cgrgncu/SwitchArray_info/README.md

# SwitchArray_info
+ SwitchArray 資訊

### 基本資料
+ 作者: TingoYeh
+ 最終版本: v20240416a
  + 電腦軟體:
    + 作業系統: Windows10
    + 軟體: ERT_ver2_9_9_Client.exe
  + 主控板PCBA(含ESP32):
    + Gerber: 檔案=BOM_ERT3-rev2_2024-02-26.csv,Gerber_ERT3-rev2_PCB_ERT3_9_2024-02-26.zip,PickAndPlace_PCB_ERT3_9_2024-02-26.csv
    + 韌體:SwitchArray_ver2_9.ino
  + 繼電器板PBCA:
    + Gerber: ??
    + 韌體:無

### 材料
+ #1 機殼:
  + 下單連結: https://item.taobao.com/item.htm?spm=a1z09.2.0.0.12aa2e8dmm8tFh&id=650716903526&_u=f207c1240h89b1
  + 來自大陸，關稅另計。視情況免運。
  + 一組含稅價約CYN800，折合台幣約NTD4000，要詢價(廠商將參考訂單數量、訂單交期等條件進行報價)。
  + 要提供設計圖。檔案=???
  + 每一台設備只需要一組機殼。
+ #2 電源接頭+插孔(K16防水航空插頭插座)
  + 下單連結: https://item.taobao.com/item.htm?spm=a1z09.2.0.0.12aa2e8dmm8tFh&id=663162205748&_u=f207c1240h331f
    + 替代連結: https://www.ruten.com.tw/item/show?22325055484808
  + 來自大陸，關稅另計。視情況免運。
  + 一組含稅價約CYN19，折合台幣約NTD95。
  + 每一台設備只需要一組(電源接頭+插孔)。
  + 圖片:  
    <image src="https://github.com/cgrgncu/SwitchArray_info/blob/main/K16%E9%98%B2%E6%B0%B4%E8%88%AA%E7%A9%BA%E6%8F%92%E9%A0%AD%E6%8F%92%E5%BA%A7.png" width="200">
+ #3 USB插孔(龍仕LSHITECH防水USB連接器)
  + 下單連結: https://item.taobao.com/item.htm?spm=a1z09.2.0.0.12aa2e8dmm8tFh&id=662371485402&_u=f207c1240h22c0
    + 替代連結: https://www.ruten.com.tw/item/show?22227674727266
  + 來自大陸，關稅另計。視情況免運。
  + 一組含稅價約CYN23，折合台幣約NTD115。
  + 每一台設備只需要一組(USB插孔)。
+ #4 HDMI插孔
  + 下單連結: https://item.taobao.com/item.htm?spm=a1z09.2.0.0.12aa2e8dmm8tFh&id=662442461312&_u=f207c1240hef03
  + 來自大陸，關稅另計。視情況免運。
  + 一組含稅價約CYN26，折合台幣約NTD130。
  + 每一台設備只需要2組(HDMI插孔)。
+ #5 BNC插孔
  + 下單連結: https://shop.cpu.com.tw/product/39037/info/
  + 來自台灣廣華電子，可開立統一發票。視情況免運。
  + 一個含稅價約NTD38。
  + 每一台設備只需要一個(BNC插孔)。
+ #6 槍型接頭
  + 下單連結: ????????????????????
  + 來自?????????????
  + 一組含稅價約??????????????????
  + 每一台設備只需要3紅色3黑色(槍型接頭)，共6個。
  + 用UL1015 18AWG 600V單股多蕊線=>AWG18,105度,600V,多芯線(紅色、黑色)
    + https://shop.cpu.com.tw/product/6934/info/
    + https://shop.cpu.com.tw/product/17169/info/
+ #7 香蕉插孔
  + 下單連結: https://shop.cpu.com.tw/product/8617/info/
  + 來自台灣廣華電子，可開立統一發票。視情況免運。
  + 一個含稅價約NTD22。
  + 每一台設備只需要1紅1黑1綠(香蕉插孔)。
+ #8 客製電路-切換版
  + 下單連結: https://jlcpcb.com/
  + 來自大陸。要運費。
  + 一組含稅價約US11，大約NTD330。
  + 要提供設計圖。檔案=BOM_ERT3-rev2_2024-02-26.csv,Gerber_ERT3-rev2_PCB_ERT3_9_2024-02-26.zip,PickAndPlace_PCB_ERT3_9_2024-02-26.csv
    + 其他: 4-PCB_PCB_ERT3_9.json
  + 每一台設備只需要8組(客製電路-切換版)。
+ #9 客製電路-控制版
  + 下單連結: https://jlcpcb.com/
  + 來自大陸。要運費。
  + 一組含稅價約US10，大約NTD300。
  + 要提供設計圖。檔案=???
  + 每一台設備只需要一組(客製電路-控制版)。
+ #10 電子元件???
  + 下單連結: https://www.lcsc.com/

+ #11 nodemcu-32s
  + 下單連結: [https://jlcpcb.com/](https://shopee.tw/(%E6%94%B6%E6%93%9A%E7%99%BC%E7%A5%A8%E5%8F%AF)%E7%AA%84%E7%89%88ESP32%E9%9B%99%E6%A0%B8%E5%BF%83arduino-WIFI%E8%97%8D%E8%8A%BDble%E8%85%B3%E4%BD%8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)https://shopee.tw/(%E6%94%B6%E6%93%9A%E7%99%BC%E7%A5%A8%E5%8F%AF)%E7%AA%84%E7%89%88ESP32%E9%9B%99%E6%A0%B8%E5%BF%83arduino-WIFI%E8%97%8D%E8%8A%BDble%E8%85%B3%E4%BD%8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
  + 來自台灣，要運費。
  + 一組含稅價約NTD245。
  + 每一台設備只需要一組(nodemcu-32s)。
  + 這個要自己燒韌體，韌體檔案=???
+ #12 BNC線
  + 下單連結: https://shop.cpu.com.tw/product/68473/info/
  + 來自台灣廣華電子，可開立統一發票。視情況免運。
  + 一組含稅價約NTD120。
  + 每一台設備只需要一組(BNC線)。
+ #13 34465A電錶
  + 下單連結: https://www.pinsyun.com.tw/index.html
  + 來自台灣品勛科技股份有限公司，可開立統一發票。視情況免運。
  + 一組含稅價約NTD63720。
  + 每一台設備只需要一組(34465A電錶)。
+ #14 200V 1A 9184B電源供應器
  + 下單連結: https://www.bktw.com.tw/
  + 來自台灣廣華電子，可開立統一發票。視情況免運。
  + 一組含稅價約NTD57750。
  + 每一台設備只需要一組(200V 1A 9184B電源供應器)。
+ #15 windows電腦
  + 一組含稅價約NTD15000。
  + 要有三個USBA
  + 每一台設備只需要一組(windows電腦)。
  + 軟體相關安裝
+ #16 歐規端子台
  + me860-508
  + MPC301-50808P
  + WJ2EDGRM-5.08-8P

```
 versionA@ 400V 100mA						
編號	項目	數量	單價	幣別	備註	來源
15A	AB30S	260	30	TWD		https://www.relay.com.tw/zh-TW/index/index.html
						
		總價	152378.308	匯率	CYN	4.4
					USD	31.24
						
 versionB@600V 600mA						
編號	項目	數量	單價	幣別	備註	來源
15B	LT930	128	70	TWD	交期長	https://www.letex.com.tw/
16B	AM38S	132	35	TWD	交期長	https://www.relay.com.tw/zh-TW/index/index.html
						
		總價	158158.308	匯率	CYN	4.4
					USD	31.24
						
 versionC@1000V 350mA						
編號	項目	數量	單價	幣別	備註	來源
15C	AA52F	260	380	TWD	交頎長	https://www.letex.com.tw/
					交期長	
						
		總價	243378.308	匯率	CYN	4.4
					USD	31.24
						
 versionD@600V 1A (DC Only)						
編號	項目	數量	單價	幣別	備註	來源
15D	G3VM-601FR	128	438	TWD		https://www.letex.com.tw/
16D	AM38S	132	35	TWD	交期長	https://www.relay.com.tw/zh-TW/index/index.html
						
		總價	205262.308	匯率	CYN	4.4
					USD	31.24
```

ab30s
(02)8227-6000 由總機為您轉接專業業務人員

### 機殼安裝完成後
+ BOX先連接電表(34465A電錶)的紅、黑線，BNC線
+ BOX連接電腦的USB。
+ BOX連接電供輸出端。使用2P防水接頭，#1接正(紅色)，#2接負(黑色)。
+ 電表接電腦(USB-B接USB-A)，電錶開啟有繼電器切換聲音是正常現象。
+ 電供接電腦。
+ 遠端重開機

### 軟體設定
+ 要滿足三個條件才是線有接好:
  + 有勾選「Remote PSU」
  + START可以按。要有測試RUN過才會儲存勾選
  + 要選好存檔資料夾。
+ 設定放電模式:
  + 讀取已經規劃好的設定檔案(csv)。
  + 軟體部分頁面只是協助規劃放電模式，實際使用不應該操作。
    + 先規劃W0~W8(最多9隻)，就是放電電極的行為，每次行為例如48秒
    + 再規劃各次行為W要放在哪個電擊棒，例如每個48秒依序換到哪個電極棒上。
    + 以上操作用來輔助產生csv檔案(CurrentSet Mode.csv)
+ 決議:
  + 禁止使用:
    + Insert Break=FALSE
    + 使用了資料會異常，原作者保留特殊測試用途。
  + 先設定啟用:
    + Only Use Last Value? = TRUE
    + Inverse Polarity = TRUE
    + 只有Gradient + Dipole dipole模式下有用。吧?

### 機殼考慮:
+  https://tw.misumi-ec.com/vona2/detail/222000224688/

### 收納包:
+ SC-TI06長方型加大防潑水硬殼收納包
  + https://jin-hua.com.tw/page/product/show.aspx?num=39619&lang=TW
