cgrgncu/SwitchArray_info/電路板生產/README.md

# 生產筆記

### PCBA廠商
+ https://jlcpcb.com/
+ 用google帳戶登入(CGRG)
