cgrgncu/SwitchArray_info/石墨電極製作/README.md

# 石墨電極製作
+ 作者: HsiupoYeh
+ 更新日期： 2025-04-06

## v20240310a
### 材料準備
+ 石墨電擊棒 x1隻
+ PVC蘋果膠膜(5公分寬) x1捲
+ 迷你台鉗60mm x1
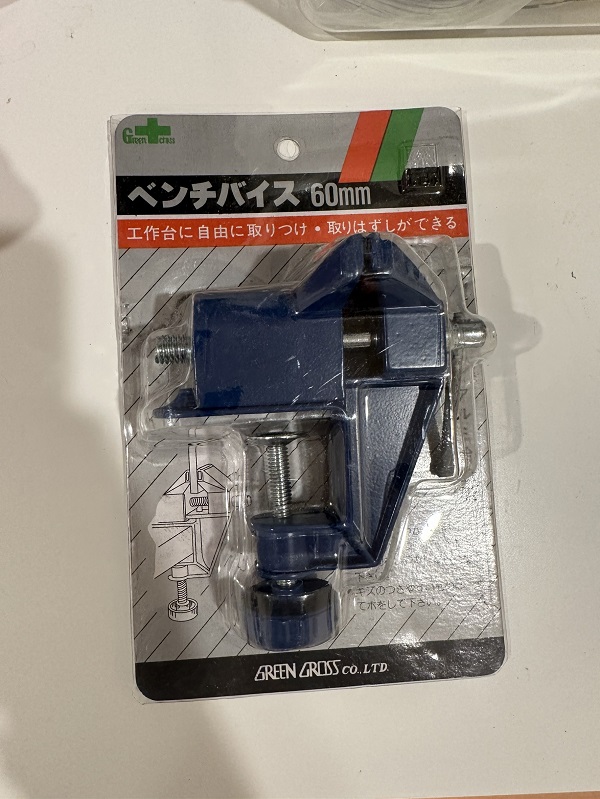
[picture p1: 石墨電極製作/迷你台鉗60mm.jpg]
迷你台鉗60mm
  > 
+ 電鑽 x1

### 步驟
+ 用PVC蘋果膠膜將石墨棒纏繞，用來增加固定時的摩擦力。
+ 不鏽鋼絲0.55mm，裁出12cm一條。2公分用來連接電線並使用熱縮，10公分用來纏繞鎖定石墨棒。
