cgrgncu/SwitchArray_info/production/SwitchArray/SwitchArray-2026-S010/README.md

## SwitchArray 2026-S010 組裝紀錄
### 組裝日期: 2026-10-16
+ SwitchArray完整序號為: 2026-S010
+ 使用日本TAKACHI電機工業生產的規格品「MO系列金屬系統機殼 MO99-16-23B」，並新增客製化支架與面板開孔(支架與面板開孔由台灣堃豐公司製作)。
+ 為了避免貼標籤錯誤，會預留一台已經貼了標籤的樣品機，若有不詳盡可拆這台來參考。
+ 貼上標籤貼紙:
  + 先全部組裝起來，等下要貼腳座。
  + 日本原廠的最大片覆蓋外殼，選一側為底座，撕掉膠膜，貼上腳座，腳座位置緊靠四個角落。使腳座放在桌上，右側是彎鉤側，在中間底部貼上標籤貼紙「SwitchArray\n2026-S010」。
  + 另一側的最大片覆蓋外殼取出不使用(另外收好)，替換成開孔的覆蓋外殼。內側貼上標籤貼紙「SwitchArray\n2026-S010」於中間下方偏右，貼上標籤貼紙「朝下」於中間下方偏左，貼上標籤貼紙「排針在上方」於中間上方。外側貼上標籤貼紙「SwitchArray\n2026-S010」於中間下方。
  + 日本原廠的前面板取出不使用(另外收好)，替換成開孔的前面板。內側是指平放時看過去右上角是有四個小孔一大孔的。內側貼上標籤貼紙「前面板內側」於中間最下方，再貼上標籤貼紙「SwitchArray\n2026-S010」於中間次下方。
  + 日本原廠的後面板，貼上標籤貼紙「後面板內側」於中間最下方，再貼上標籤貼紙「SwitchArray\n2026-S010」於中間次下方。
  + 取出支架，貼上標籤貼紙「排針在上方」於中間上方，再貼上標籤貼紙「SwitchArray\n2026-S010」於中間下方。
  + 準備收納用的大創透明外箱，並貼上護貝的名稱紙。
+ 若後續零件未就緒，就先組裝起來。記得要把支架鎖到開孔覆蓋外殼中，平頭M4x10螺絲。
+ 準備配件收納包(SC-TI06長方型加大防潑水硬殼收納包):
  + 配件包正反面貼上標籤貼紙「S010」於中間，正反兩面各一張。
  + 配件1: USB3.0數據線(POLYWELL USB3.0 Type-A公對公高速傳輸線 1M) 兩個USB頭平坦側貼上標籤貼紙「S010」，有加外框1字體6pt。用六號夾鏈袋裝好，放入收納包中。
  + 配件2:PSU連接線(橘、灰)_香蕉接頭轉防水接頭，一組。製作方式:
    + 準備香蕉接頭紅色(GS-6027B-R)、黑色(GS-6027B-BK)，各一個。
    + 從8芯纜線中取出橘色、灰色電線各一條，每條裁切為62[cm]長。
    + 準備KWAY綠色防水接頭一個。平坦側貼上標籤貼紙「S010」，有加外框字體10pt。
    + 先將一端剝線約1[cm]，先用壓接端子(CE0.75-10W)壓好，修剪壓接部分(保留約2.5~3格)，再鎖到黑色香蕉插頭(GS-6027B-BK)或紅色香蕉插頭(GS-6027B-R)上。紅色接頭配橘色線，黑色接頭配灰色線。
    + 兩條接頭帶線完成後，接到電供上(不要通電)，使用蘋果膠帶把兩條線束緊固定。保留約3[cm]用於安裝防水接頭。
    + 焊接電線到防水接頭上，記得按照順序先把零件套到線上，先用壓接端子(CE0.75-10W)壓好，再將橘色線焊接到PIN#1，灰色線焊接到PIN#2。最後組裝起來，並使用電錶查驗通路與否。
    + 用五號夾鏈袋裝好，放入收納包中。
  + 配件3:DMM連接線(紅、黑)_香蕉接頭轉電錶接頭，一組。製作方式:
    + 準備香蕉接頭紅色(GS-6027B-R)、黑色(GS-6027B-BK)，各一個。
    + 從雙頭香蕉接頭測試線(FC-TL209)中取出黑、紅色各一條，每條120[cm]從中間裁切一半長度，裁完變成約60[cm]長。至此變成黑紅各兩條。
    + 先將一端剝線約1[cm]，先用壓接端子(CE0.75-10W)壓好，修剪壓接部分(保留約2.5~3格)，再鎖到黑色香蕉插頭(GS-6027B-BK)或紅色香蕉插頭(GS-6027B-R)上。紅色接頭配紅色線，黑色接頭配黑色線。
    + 兩條接頭帶線完成後，接到電錶上(不要通電)，使用蘋果膠帶把兩條線束緊固定，並貼上標籤貼紙「S010」。標籤貼在兩邊蘋果膠帶末端距離約3[cm]。
    + 用六號夾鏈袋裝好，放入收納包中。
  + 配件4:BNC雙公射頻線_1M_RG316(BNC-316U-100)，一條。BNC接頭底下小環貼上標籤貼紙「S010」字體6pt，用六號夾鏈袋裝好，放入收納包中。
+ 組裝前面板上的接頭:
  + 安裝一個紅色博士端子座(優先使用型號GS-6044B-R)
    + 準備配合使用的紅色電源線(從8芯纜線中取出紅色)，長度33[cm]，一端先用壓接端子(CE0.75-10W)壓好，修剪壓接部分(保留約2.5~3格)後壓接絕緣R型端子(型號RF1.25-4)。最後鎖到博士端子座上+螺絲固定膠。另一端用壓接端子(CE0.75-10W)壓好。
  + 安裝一個黑色博士端子座(優先使用型號GS-6044B-BK)
    + 準備配合使用的黑色電源線(從8芯纜線中取出黑色)，長度33[cm]，一端先用壓接端子(CE0.75-10W)壓好，修剪壓接部分(保留約2.5~3格)後壓接絕緣R型端子(型號RF1.25-4)。最後鎖到博士端子座上+螺絲固定膠。另一端用壓接端子(CE0.75-10W)壓好。
  + 安裝一個雙頭BNC座有絕緣(型號BNC-SS-AI)+內側螺絲固定膠。
  + 安裝一個綠色KWAY防水接頭座
    + 準備配合使用的橘、灰色電源線(從8芯纜線中取出橘、灰色)各一條，每條長度33[cm]。
    + 接頭座編號1處塗上紅色，編號2處塗上黑色。
    + 先用壓接端子(CE0.75-10W)壓好，再焊接到接頭座再將橘色線焊接到PIN#1，灰色線焊接到PIN#2。
  + 安裝一個黃色USBA防水接頭座
    + 準備MicroUSB線(優先使用型號IS-C62，長度20[cm])     
+ 組裝上方面板REF接頭:
  + 準備綠色博士端子頭(優先使用型號9404G)
    + 準備配合使用的綠色電源線(從8芯纜線中取出綠色)，長度33[cm]，單端先用壓接端子(CE0.75-10W)壓好，修剪壓接部分(保留約2.5~3格)後壓接R型端子(型號R1.25-4)。最後鎖到博士端子座上。R型端子+壓接端子+螺絲固定膠。
+ 組裝Control_Board_v1.2
  + 取出一片Control_Board_v1.2，登記出廠序號「2025100002」。移除底部固定螺絲，螺絲另外收好。在H101附近貼上標籤貼紙「SwitchArray\n2026-S010」。
  + 先裝上BNC公轉杜邦母_30cm(型號BNC-MDP-03)連接線，紅色接V_ready，黑色接GND。
  + 再裝上ESP32-WROOM-32E(ESP32-Devkit v3.0)
    + SwitchArray內部使用的「ESP32」一律改用「CP2102」版本
      + 使用CP210x修改序號工具將序號修改為: 「2026-S010」。
        + 插上裝置後(避免弄錯一次只插上一個CP210x裝置)，運行「CP210xSetIDs.exe」，找到中間有一個格子有標註「Serial Number」，填入序號「2026-S010」，在把前面的勾選框勾起來，最後按下最下方的「Program Device」，完成後關閉修改工具，並反覆插拔裝置與檢查序號是否正確。
      + 修改成功後，可在裝置管理員>連接埠(COM和LPT)>Silicon Labs CP210x USB to UART Bridge (COM3)>詳細資料> 裝置例項路徑，會看到「USB\VID_10C4&PID_EA60\2026-S010」。其中「2026-S010」就是SwitchArray完整序號。
    + 燒錄韌體「SwitchArray_ver2_9.ino」。
    + 以上工作都完成後，於ESP32上IC的金鐘罩貼上標籤貼紙，上方貼的標籤貼紙「CP2102」有加外框字體6pt。下方貼的是標籤貼紙「S010」有加外框字體10pt。用剪刀稍微修剪再貼上去。
  + 鎖上配合使用的電源線:
    + 牛角座編號1: 準備配合使用的黑色電源線(從8芯纜線中取出黑色)，長度33[cm]，單端先用壓接端子(CE0.75-10W)壓好，修剪壓接部分(保留約2.5~3格)後壓接R型端子(型號R1.25-4)並用絕緣膠帶纏繞。
    + 牛角座編號2: 準備配合使用的灰色電源線(從8芯纜線中取出灰色)，長度33[cm]，單端先用壓接端子(CE0.75-10W)壓好，修剪壓接部分(保留約2.5~3格)後壓接R型端子(型號R1.25-4)並用絕緣膠帶纏繞。
    + 牛角座編號3: 準備配合使用的綠色電源線(從8芯纜線中取出綠色)，長度33[cm]，單端先用壓接端子(CE0.75-10W)壓好，修剪壓接部分(保留約2.5~3格)後壓接R型端子(型號R1.25-4)並用絕緣膠帶纏繞。
    + 牛角座編號4: 準備配合使用的紅色電源線(從8芯纜線中取出紅色)，長度33[cm]，單端先用壓接端子(CE0.75-10W)壓好，修剪壓接部分(保留約2.5~3格)後壓接R型端子(型號R1.25-4)並用絕緣膠帶纏繞。
    + 牛角座編號5: 準備配合使用的橙色電源線(從8芯纜線中取出橙色)，長度33[cm]，單端先用壓接端子(CE0.75-10W)壓好，修剪壓接部分(保留約2.5~3格)後壓接R型端子(型號R1.25-4)並用絕緣膠帶纏繞。
+ 組裝RelayBoard_v1.2與Control_Board_v1.2
  + 取出8片RelayBoard_v1.2，並記錄其序號，及其被設定的板子編號:
    + 「RelayBoard\n2026-S010-1」: 序號「2025120073」。換成:「2025120054」。
    + 「RelayBoard\n2026-S010-2」: 序號「2025120075」。換成:「2025120094」。
    + 「RelayBoard\n2026-S010-3」: 序號「2025120077」。換成:「2025120095」。
    + 「RelayBoard\n2026-S010-4」: 序號「2025120078」。換成:「2025120096」。
    + 「RelayBoard\n2026-S010-5」: 序號「2025120079」。換成:「2025120097」。
    + 「RelayBoard\n2026-S010-6」: 序號「2025120080」。換成:「2025120098」。
    + 「RelayBoard\n2026-S010-7」: 序號「2025120081」。換成:「2025120099」。
    + 「RelayBoard\n2026-S010-8」: 序號「2025120083」。換成:「2025120100」。
  + 拆封並移除底部固定螺絲，螺絲另外收好。
  + Control_Board_v1.2為第0片，從排針側依序疊好1~8片RelayBoard_v1.2到一起。
  + 用螺絲鎖到支架上，Control_Board_v1.2朝向支架有挖空處。
+ 組裝整個箱體:
  + 注意上方面板的REF要固定好，博士端子座要鎖緊並且使Y型端子後方的綠線朝前面板方向，避免組裝時壓到線。
  + 對齊RelayBoard到上方面板，之後鎖上螺絲。注意，支架後方先不要鎖緊，等上方面板鎖好之後再補鎖緊支架上的螺絲。
  + 接上MicroUSB線到Control_Board_v1.2上。
  + 安裝前面板:
    + 先把BNC接上
    + 再把USB接上(可能有點緊繃稍微硬擠一下)
    + 鎖上前面板固定板(平頭小螺絲的那塊)
  + 接快接頭(顏色對接)，然後將接頭藏到凹槽中。
  + 裝殼，鎖好全部。
  + 完成!
+ 準備相關軟體至雲端供使用者下載:
  + R2MS_Lite_安裝軟體:
      + R2MS_Lite_Smart_Scheduler
        + 這個軟體要重新編譯來支援新增的序號。
      + R2MS_Lite_Driver
+ 驗收測試:
  + 序號測試:
    + 確認R2MS_Lite_Smart_Scheduler是否有支援該序號。
    + 同時也是驗證韌體燒錄是否成功。
  + 空接放電測試：
    + 2026-10-16: 測試通過
    + 主要關心電壓為相似整齊波型，電流為0[A]。
      + 只安裝單片RelayBoard_v1.2，8CH空接，綠色REF空接。
        + 正式測試前，去清空舊的CSV檔案。
        + 觀察電流範圍+-0.001[A]，方便觀看，可以把電壓也設定同樣範圍:
          + 應該會呈現正反放電波型，不穩定，可視為漏電。電流約0.0005[A]，稍微抖動的波型。特色:單獨觀看一頻道，前面正反比較方波，後面正反比較三角形。
          + 用NotePad++開啟CSV檔案，檢查第三個直欄位電流。應該都是0，僅在切換時有0.00005~0.00006[A]
    + 若測試失敗表示要拆掉重新檢查: 單獨板子測試方法TBD...。 
  + 10歐姆模擬地層放電測試:
    + 主要關心電壓為相似整齊波型，電流為0.1[A]。
      + 2026-10-16:測試通過。
  + 校園草坪放電測試:
    + 實際放電並資料處理及逆推。 
+ 合格報告:
  + 內容物序號清單
  + 組裝日期
  + 測試日期及結果
  + 軟體下載位置
+ 資料蒐集小電腦:
  + 安裝設定TBD... 
  + 原則上一台資料蒐集小電腦僅專供一套R2MS_Lite使用，故電腦內使用者名稱與儀器序號相同。以利盤點管理及自動化功能開發。是否需要修改密碼視使用者需求而定，預設無密碼。
  + 重灌作業系統及必要驅動程式。目前選用Windows10，若有安全性疑慮請避免直接連接網際網路。
  + 安裝必要操作程式(R2MS_Lite_Smart_Scheduler、R2MS_Lite_Driver等)
  + 小電腦貼上標籤，例如:序號、重灌日期、用途、財產編號等。
