cgrgncu/SwitchArray_info/production/SwitchArray/SwitchArray-2025-S006/README.md

### SwitchArray 2025-S006
+ 組裝日期: 2025-12-31 (*無法確認具體日期)
+ SwitchArray完整序號為: 2025-S006

### 2026-04-28
+ 墾丁回來之後，S006損壞。內部線路似乎被拉扯到，ControlBoard排針損壞。

### 2026-04-29
+ 維修日期: 2026-04-29
+ 更換ControlBoard_v1.2，登記出廠序號「2025100004」。
+ 內部連接線更換為R型端子+壓接端子+螺絲固定膠。
+ 更換USBA公對公傳輸線。

### 2026-05-01
+ 通過室內測試

### 2026-05-04
+ 通過室外測試
