cgrgncu/SwitchArray_info/production/SwitchArray/SwitchArray-2025-S003/README.md

### SwitchArray 2025-S003
+ 組裝日期: 2025-12-31 (*無法確認具體日期)
+ SwitchArray完整序號為: 2025-S003

### 2026-05-04
+ 通過完整測試
