cgrgncu/SwitchArray_info/RelayBoard_QC_v1/R2MS_Lite_RelayBoard_QC_v20250419a/Flash_Html/README.txt

ESP32 Flash Tool 使用說明

📌 使用前準備：
1. 請使用 Google Chrome 或 Edge 瀏覽器（需支援 Web Serial API）
2. 建議使用 USB 資料線連接 ESP32 裝置

🧪 操作步驟：
1. 解壓縮本壓縮檔
2. 用 Chrome 開啟 flash.html
3. 點擊「開始燒錄」
4. 選擇 ESP32 裝置
5. 等待燒錄完成，裝置會自動重啟！

💡 如果出現錯誤：
- 請確認已允許瀏覽器存取 USB
- 更換 USB 線或接腳
- 使用支援的瀏覽器（Chrome、Edge）
