cgrgncu/SwitchArray_info/production/SwitchArray/SwitchArray-2026-S007/20261028/README.md

# SwitchArray-2026-S007 維修檢測完成紀錄
+ 室外檢測完成日期: 2026-10-28

### 時間序列檢視
| 室內浮接測試時間序列 PSU:SHOW S007202610281145 |
| :---: |
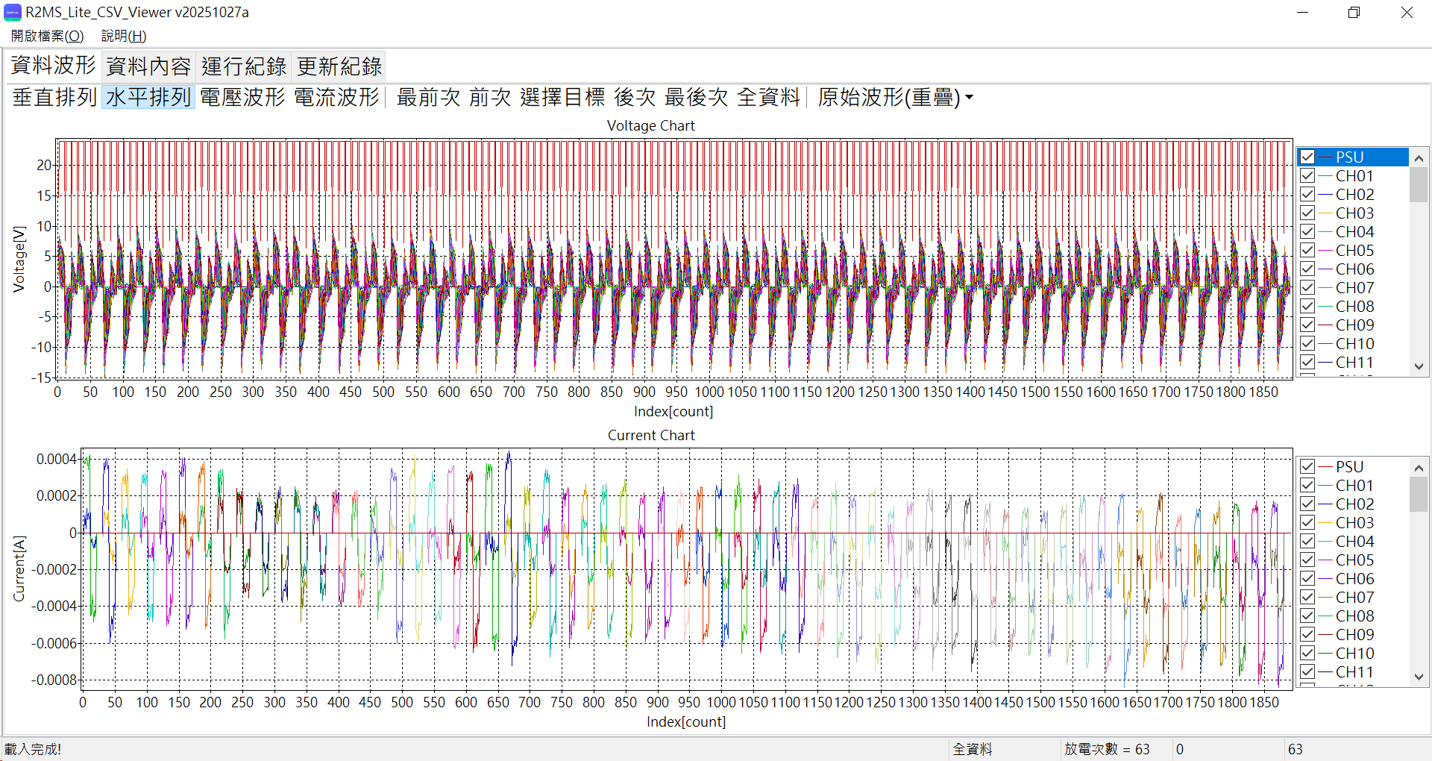
[picture p29: production/SwitchArray/SwitchArray-2026-S007/20261028/S007202610281145_Floating.png]
|  |

| 室內浮接測試時間序列 PSU:HIDE S007202610281145 |
| :---: |
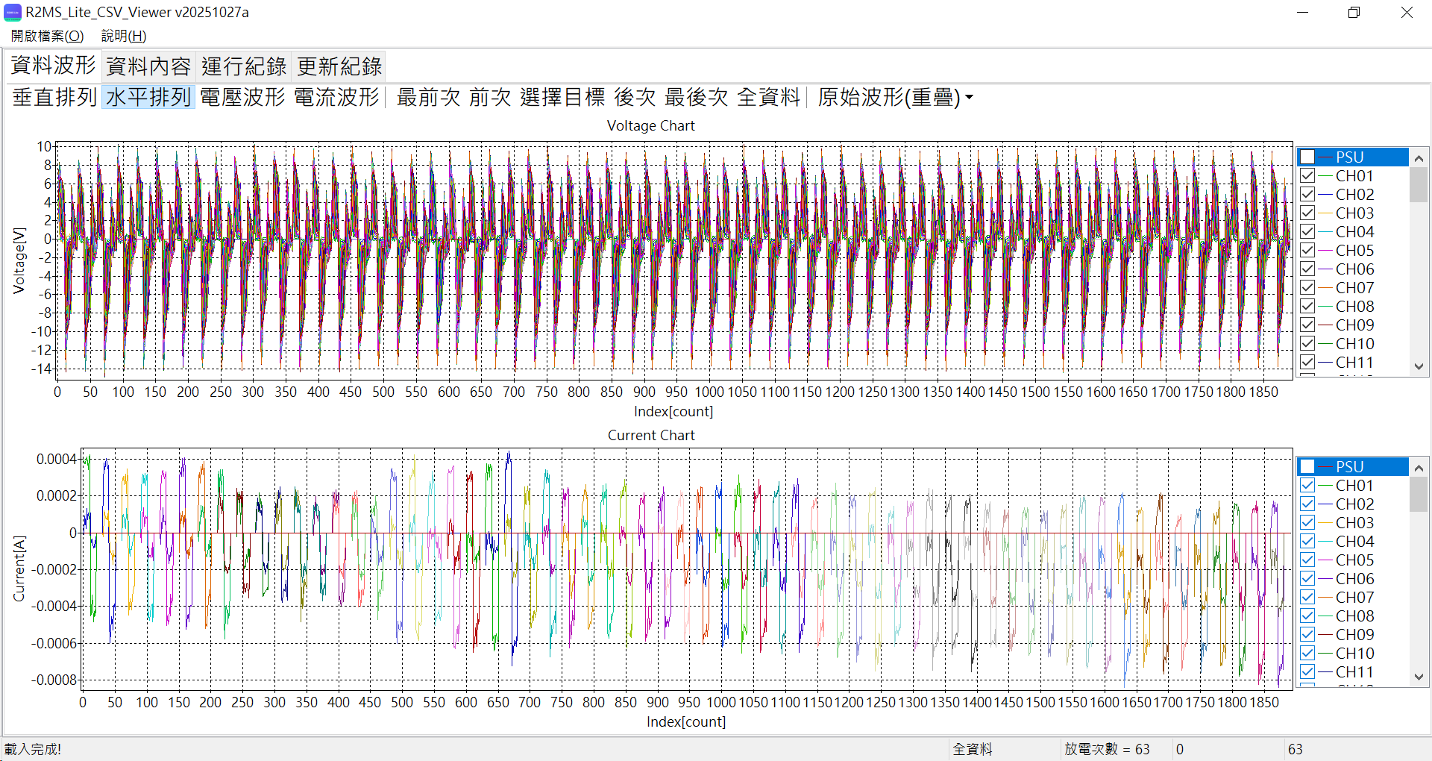
[picture p30: production/SwitchArray/SwitchArray-2026-S007/20261028/S007202610281145_Floating2.png]
|  |

| 室內標準地層測試時間序列 PSU:SHOW S007202610281153 |
| :---: |
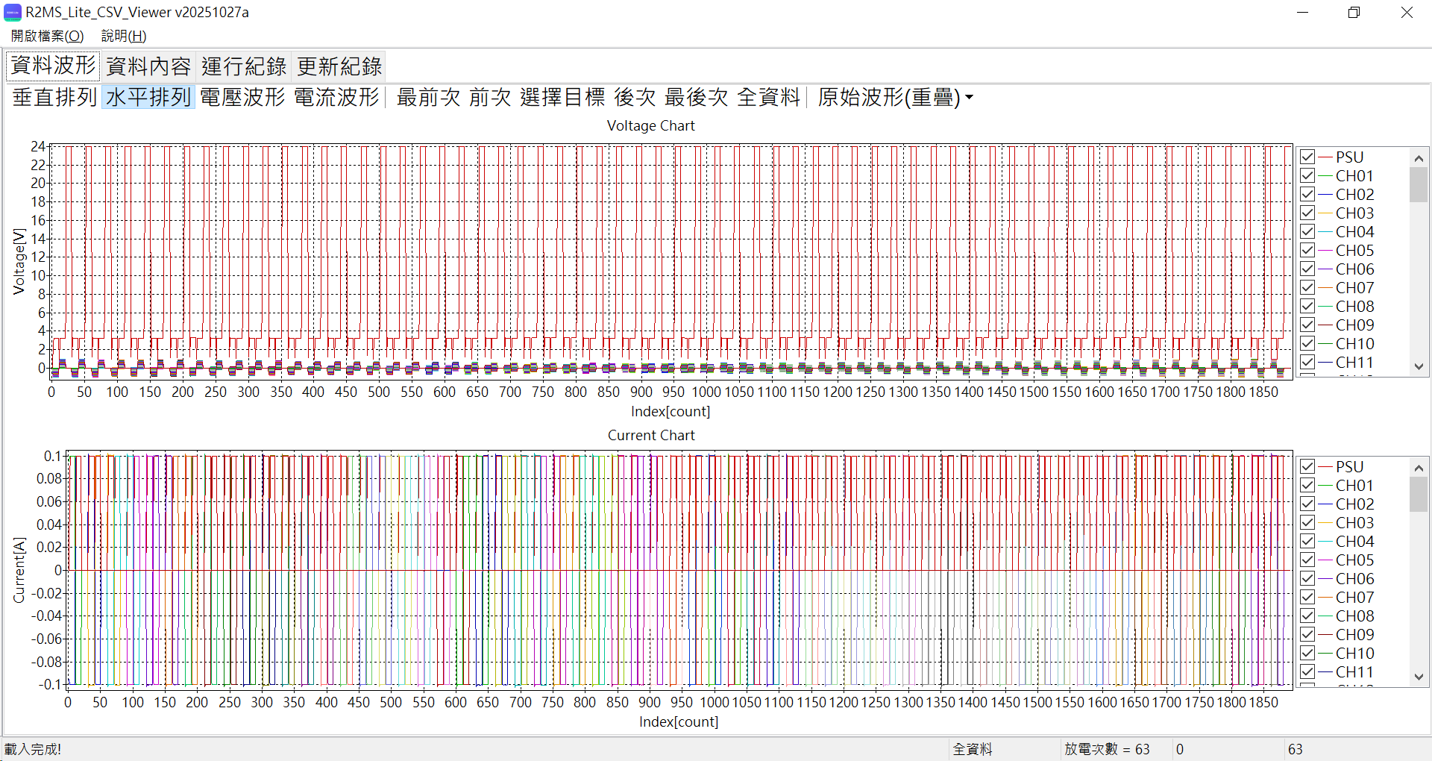
[picture p31: production/SwitchArray/SwitchArray-2026-S007/20261028/S007202610281153_StandardResistor.png]
|  |

| 室內標準地層測試時間序列 PSU:HIDE S007202610281153 |
| :---: |
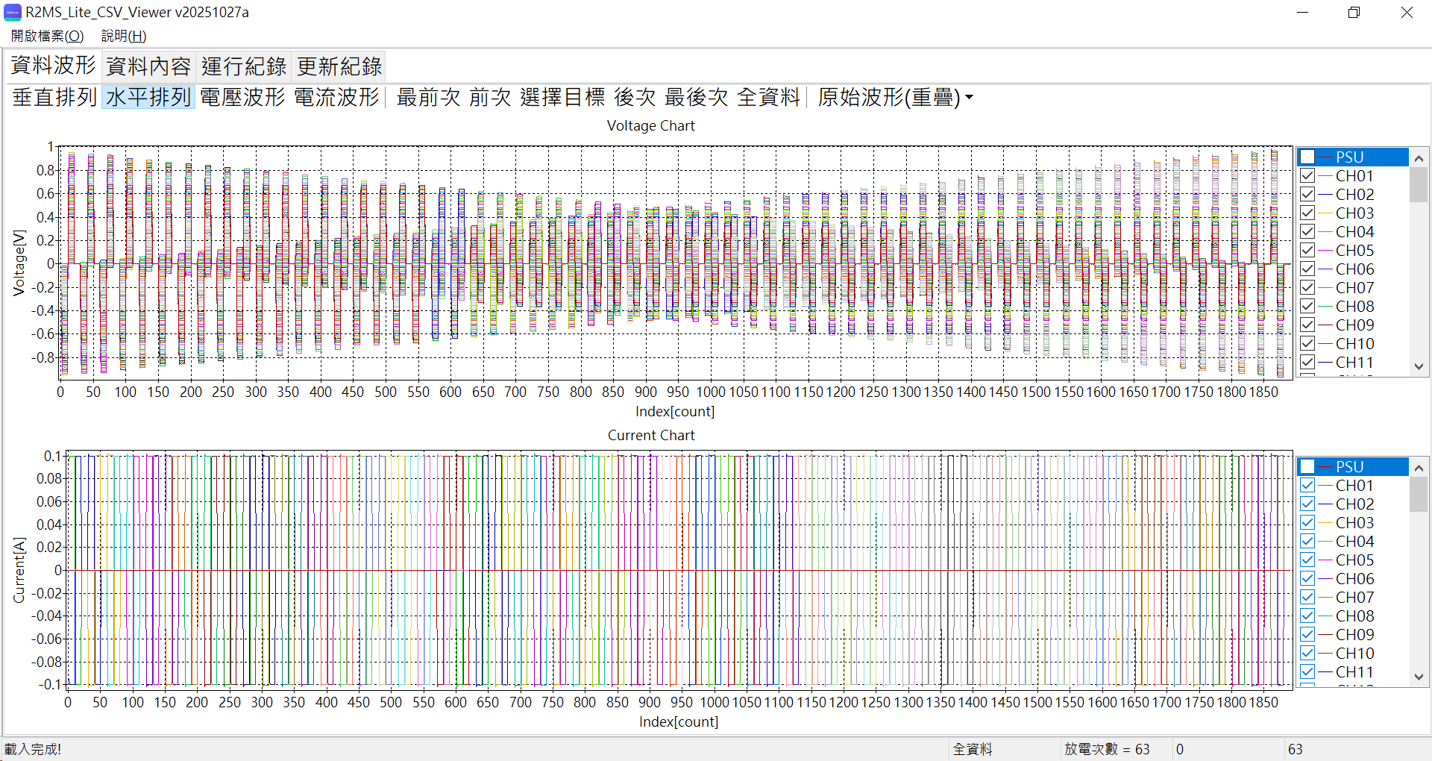
[picture p32: production/SwitchArray/SwitchArray-2026-S007/20261028/S007202610281153_StandardResistor2.png]
|  |

### R2MS_Lite_CSV_CurrentQC 分析摘要

- **來源檔案**：`S007202610281153.v299T.csv`
- **產生時間**：2026-10-30 22:27:23
- **程式版本**：R2MS_Lite_CSV_CurrentQC v20261030b
- **資料筆數**：原始 1890 筆 → 篩選後 1134 筆（每 10 筆保留 3~8）
- **判定標準**：AVG(MEAS/PSU) > 115.00%
- **BOARD 對應**：CH01–CH08 = BOARD 01、CH09–CH16 = BOARD 02、…、CH57–CH64 = BOARD 08

```
BOARD,CH,AVG(MEAS)[A],AVG(PSU)[A],AVG(MEAS/PSU)[%],count,BOARD,CH,AVG(MEAS)[A],AVG(PSU)[A],AVG(MEAS/PSU)[%],count
01,CH01,0.099842335,0.100020000, 99.82,12,02,CH09,0.099760838,0.100042500, 99.72,24
01,CH02,0.099870414,0.100030833, 99.84,24,02,CH10,0.099821804,0.100043333, 99.78,24
01,CH03,0.100690334,0.100041667,100.65,24,02,CH11,0.100019492,0.100042917, 99.98,24
01,CH04,0.099947691,0.100042083, 99.91,24,02,CH12,0.100190567,0.100042500,100.15,24
01,CH05,0.099862393,0.100042500, 99.82,24,02,CH13,0.099876392,0.100042917, 99.83,24
01,CH06,0.100108831,0.100042917,100.07,24,02,CH14,0.099977100,0.100043333, 99.93,24
01,CH07,0.099934289,0.100043333, 99.89,24,02,CH15,0.099697356,0.100043333, 99.65,24
01,CH08,0.099934848,0.100042500, 99.89,24,02,CH16,0.099838555,0.100042500, 99.80,24
03,CH17,0.099920781,0.100041667, 99.88,24,04,CH25,0.100358724,0.100042500,100.32,24
03,CH18,0.099849398,0.100041667, 99.81,24,04,CH26,0.099842587,0.100042083, 99.80,24
03,CH19,0.099893009,0.100042083, 99.85,24,04,CH27,0.100106381,0.100042083,100.06,24
03,CH20,0.100032208,0.100042500, 99.99,24,04,CH28,0.099947656,0.100042083, 99.91,24
03,CH21,0.099886917,0.100042500, 99.84,24,04,CH29,0.099915922,0.100042083, 99.87,24
03,CH22,0.099980603,0.100042083, 99.94,24,04,CH30,0.100115474,0.100042083,100.07,24
03,CH23,0.100165131,0.100042083,100.12,24,04,CH31,0.099773393,0.100041667, 99.73,24
03,CH24,0.099935494,0.100042500, 99.89,24,04,CH32,0.100115121,0.100041667,100.07,24
05,CH33,0.099841721,0.100041667, 99.80,24,06,CH41,0.099780657,0.100041667, 99.74,24
05,CH34,0.100124914,0.100041667,100.08,24,06,CH42,0.099780625,0.100041667, 99.74,24
05,CH35,0.099999095,0.100041667, 99.96,24,06,CH43,0.099725695,0.100042083, 99.68,24
05,CH36,0.099937656,0.100041667, 99.90,24,06,CH44,0.100163299,0.100042500,100.12,24
05,CH37,0.100011637,0.100042083, 99.97,24,06,CH45,0.099928224,0.100042083, 99.89,24
05,CH38,0.099848711,0.100042083, 99.81,24,06,CH46,0.099924263,0.100041667, 99.88,24
05,CH39,0.100001565,0.100042083, 99.96,24,06,CH47,0.100159557,0.100040833,100.12,24
05,CH40,0.100098571,0.100042083,100.06,24,06,CH48,0.099981281,0.100041250, 99.94,24
07,CH49,0.100094719,0.100042083,100.05,24,08,CH57,0.100080918,0.100042083,100.04,24
07,CH50,0.099927918,0.100041250, 99.89,24,08,CH58,0.100081509,0.100042083,100.04,24
07,CH51,0.099826756,0.100041250, 99.79,24,08,CH59,0.100145379,0.100042083,100.10,24
07,CH52,0.099769426,0.100041667, 99.73,24,08,CH60,0.100106001,0.100042083,100.06,24
07,CH53,0.099714025,0.100042083, 99.67,24,08,CH61,0.099945773,0.100041667, 99.90,24
07,CH54,0.099791156,0.100042083, 99.75,24,08,CH62,0.100043458,0.100041250,100.00,24
07,CH55,0.099775577,0.100041667, 99.73,24,08,CH63,0.100285550,0.100041667,100.24,24
07,CH56,0.100315461,0.100041667,100.27,24,08,CH64,0.100013821,0.100042500, 99.97,12
```

超標通道：無

| 野外測試時間序列 PSU:SHOW S007202610281229 |
| :---: |
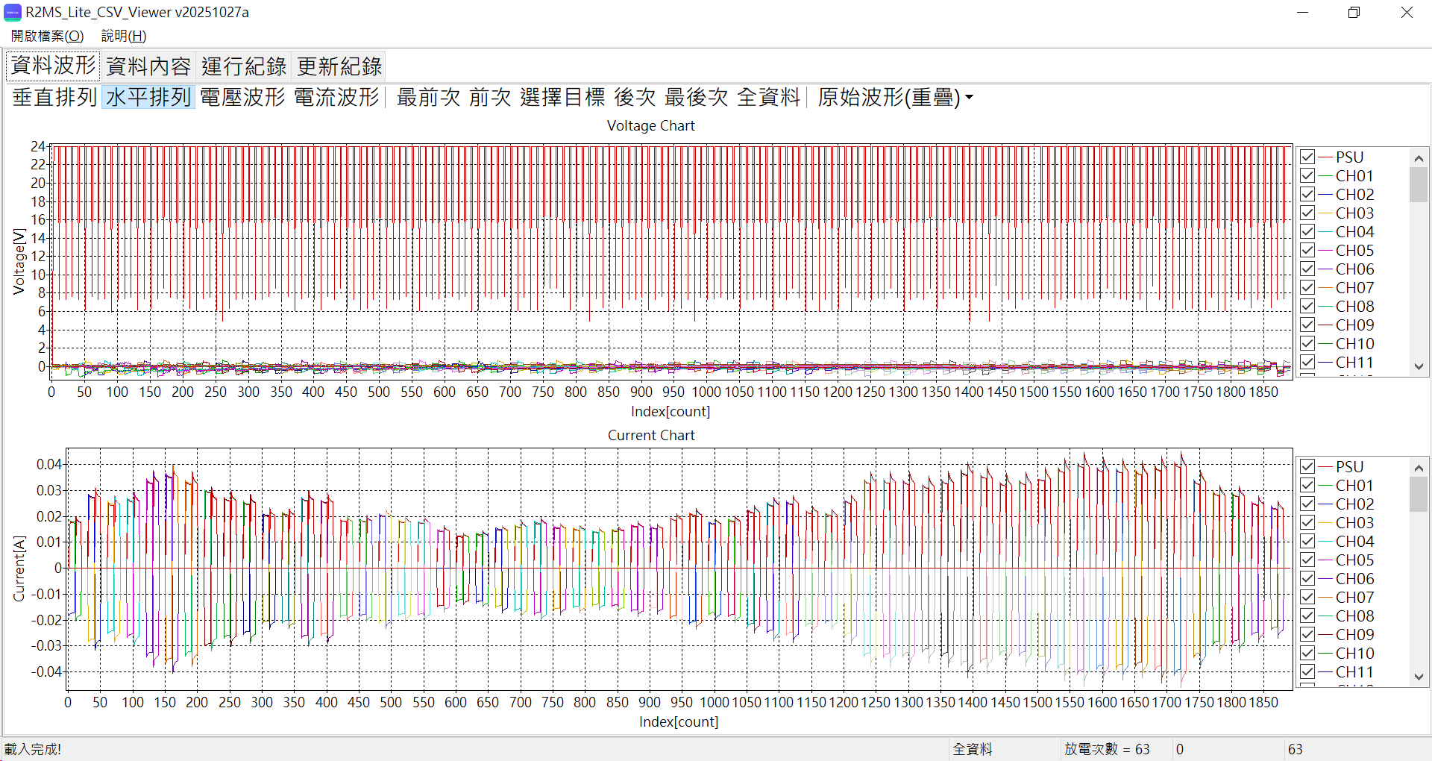
[picture p33: production/SwitchArray/SwitchArray-2026-S007/20261028/S007202610281229_FieldTest.png]
|  |

| 野外測試時間序列 PSU:HIDE S007202610281229 |
| :---: |
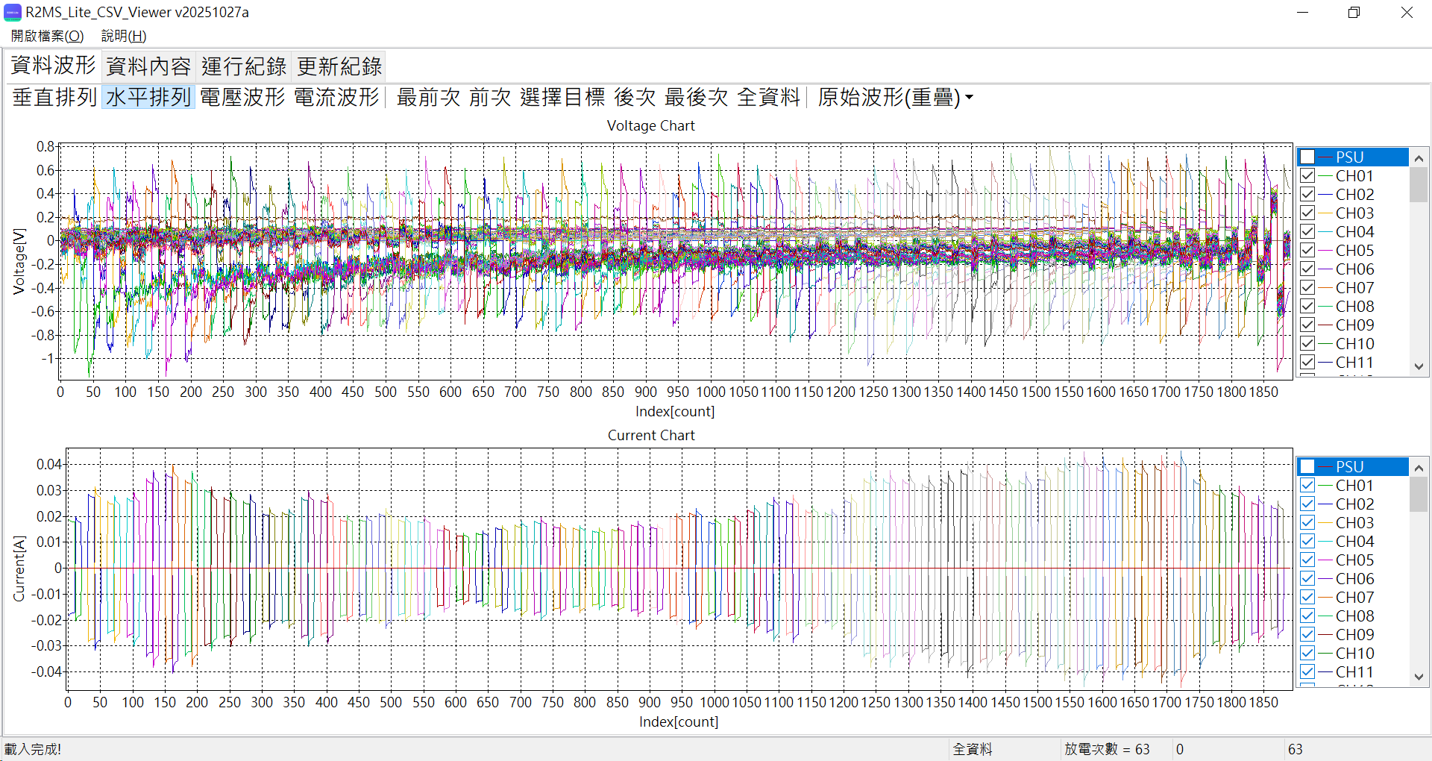
[picture p34: production/SwitchArray/SwitchArray-2026-S007/20261028/S007202610281229_FieldTest2.png]
|  |

### R2MS_Lite_CSV_CurrentQC 分析摘要

- **來源檔案**：`S007202610281229.v299T.csv`
- **產生時間**：2026-10-30 22:27:33
- **程式版本**：R2MS_Lite_CSV_CurrentQC v20261030b
- **資料筆數**：原始 1890 筆 → 篩選後 1134 筆（每 10 筆保留 3~8）
- **判定標準**：AVG(MEAS/PSU) > 115.00%
- **BOARD 對應**：CH01–CH08 = BOARD 01、CH09–CH16 = BOARD 02、…、CH57–CH64 = BOARD 08

```
BOARD,CH,AVG(MEAS)[A],AVG(PSU)[A],AVG(MEAS/PSU)[%],count,BOARD,CH,AVG(MEAS)[A],AVG(PSU)[A],AVG(MEAS/PSU)[%],count
01,CH01,0.018378397,0.018007500,102.07,12,02,CH09,0.027557417,0.027660833, 99.64,24
01,CH02,0.022900930,0.022912083, 99.72,24,02,CH10,0.026035274,0.026112083, 99.74,24
01,CH03,0.026668152,0.026418750,101.00,24,02,CH11,0.023090937,0.023103333,100.06,24
01,CH04,0.025875371,0.025781667,100.36,24,02,CH12,0.021022699,0.020871250,100.73,24
01,CH05,0.030083889,0.030130833, 99.76,24,02,CH13,0.023814588,0.023889167, 99.59,24
01,CH06,0.034757650,0.034723750,100.09,24,02,CH14,0.026271581,0.026300417, 99.92,24
01,CH07,0.034591916,0.034538333,100.19,24,02,CH15,0.022034848,0.022107083, 99.82,24
01,CH08,0.030920364,0.030955000, 99.95,24,02,CH16,0.018551886,0.018447083,100.57,24
03,CH17,0.019561922,0.019499583,100.26,24,04,CH25,0.017115954,0.016929583,101.05,24
03,CH18,0.019519355,0.019332917,101.03,24,04,CH26,0.016704977,0.016631250,100.54,24
03,CH19,0.018039399,0.017994583,100.27,24,04,CH27,0.015543703,0.015386250,101.06,24
03,CH20,0.016415004,0.016192500,101.53,24,04,CH28,0.014616923,0.014568750,100.41,24
03,CH21,0.013648703,0.013415833,101.88,24,04,CH29,0.014554592,0.014320833,101.62,24
03,CH22,0.012884189,0.012625000,102.01,24,04,CH30,0.015534895,0.015456250,100.42,24
03,CH23,0.014175331,0.013963333,101.38,24,04,CH31,0.016044103,0.015952917,100.61,24
03,CH24,0.015657938,0.015610417,100.25,24,04,CH32,0.017471483,0.017391667,100.32,24
05,CH33,0.020088737,0.020082917, 99.98,24,06,CH41,0.023477920,0.023423750,100.13,24
05,CH34,0.019393802,0.019214167,101.04,24,06,CH42,0.029832957,0.029873333, 99.75,24
05,CH35,0.018171529,0.017990833,100.99,24,06,CH43,0.033673771,0.033789583, 99.67,24
05,CH36,0.020322346,0.020292083,100.04,24,06,CH44,0.033655370,0.033651250,100.03,24
05,CH37,0.023577864,0.023482083,100.35,24,06,CH45,0.032766004,0.032783750, 99.98,24
05,CH38,0.025130683,0.025160000, 99.88,24,06,CH46,0.032871651,0.032882083, 99.97,24
05,CH39,0.023748970,0.023642083,100.52,24,06,CH47,0.035420151,0.035395000,100.05,24
05,CH40,0.021515417,0.021377083,100.69,24,06,CH48,0.036300771,0.036356250, 99.88,24
07,CH49,0.034257884,0.034236250,100.10,24,08,CH57,0.038151881,0.038128750,100.06,24
07,CH50,0.033169382,0.033212500, 99.88,24,08,CH58,0.039631599,0.039696250, 99.84,24
07,CH51,0.034186266,0.034287917, 99.70,24,08,CH59,0.037177935,0.037176667,100.07,24
07,CH52,0.036602245,0.036672917, 99.80,24,08,CH60,0.031577248,0.031434583,100.52,24
07,CH53,0.039106035,0.039285000, 99.54,24,08,CH61,0.028784133,0.028747500,100.15,24
07,CH54,0.039345443,0.039392083, 99.91,24,08,CH62,0.026916785,0.026841250,100.36,24
07,CH55,0.038205749,0.038308333, 99.75,24,08,CH63,0.024536923,0.024292917,101.05,24
07,CH56,0.037777507,0.037673750,100.30,24,08,CH64,0.023245993,0.023453333, 99.15,12
```

超標通道：無

| NCU草坪時間序列 PSU:SHOW S007202610281236 |
| :---: |
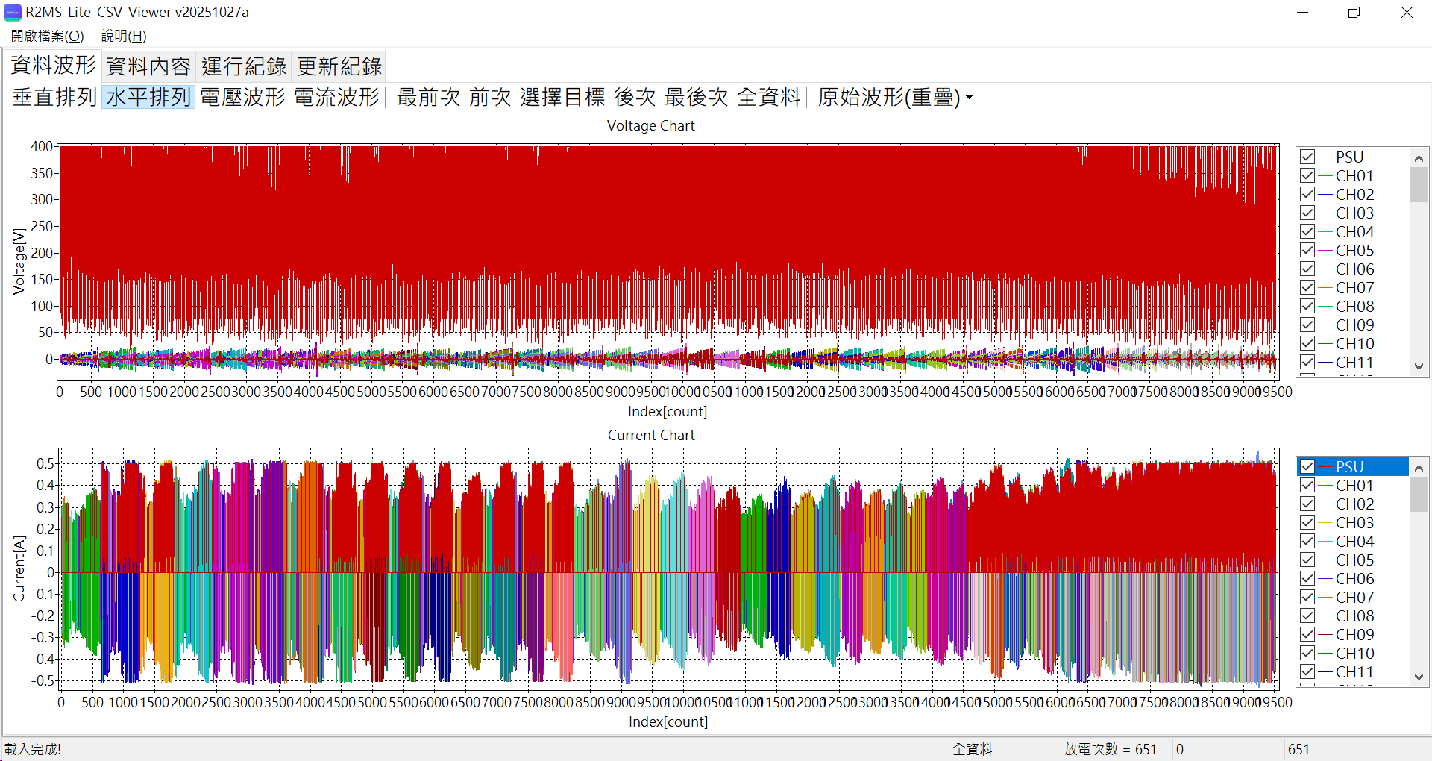
[picture p35: production/SwitchArray/SwitchArray-2026-S007/20261028/S007202610281236_NCUQC.png]
|  |

| NCU草坪時間序列 PSU:HIDE S007202610281236 |
| :---: |
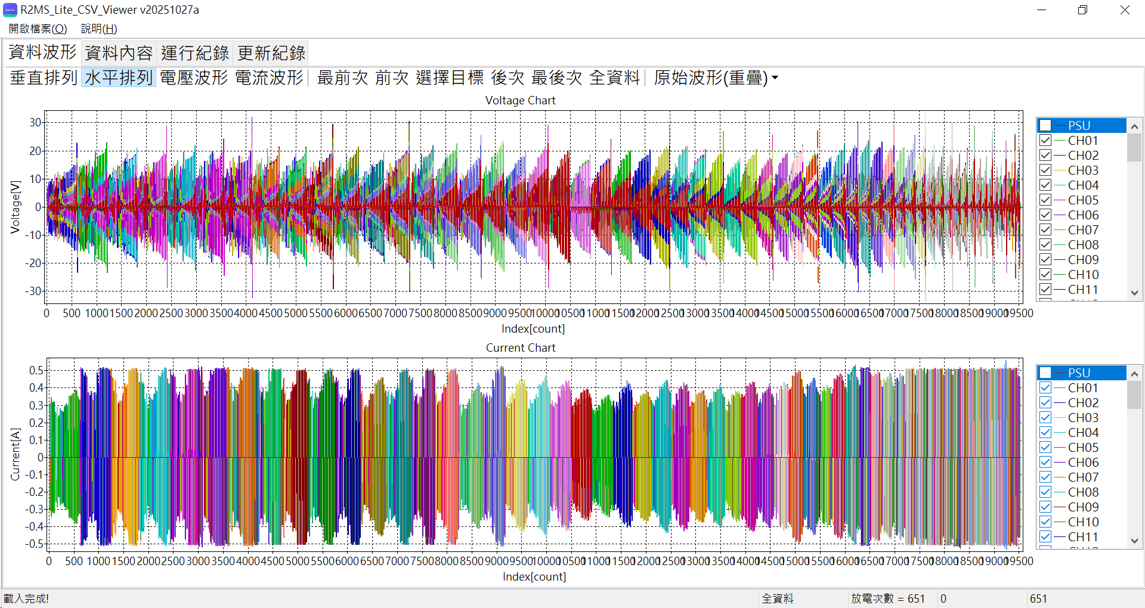
[picture p36: production/SwitchArray/SwitchArray-2026-S007/20261028/S007202610281236_NCUQC2.png]
|  |

### R2MS_Lite_CSV_CurrentQC 分析摘要

- **來源檔案**：`S007202610281236.v299S.csv`
- **產生時間**：2026-10-30 22:27:40
- **程式版本**：R2MS_Lite_CSV_CurrentQC v20261030b
- **資料筆數**：原始 19530 筆 → 篩選後 11718 筆（每 10 筆保留 3~8）
- **判定標準**：AVG(MEAS/PSU) > 115.00%
- **BOARD 對應**：CH01–CH08 = BOARD 01、CH09–CH16 = BOARD 02、…、CH57–CH64 = BOARD 08

```
BOARD,CH,AVG(MEAS)[A],AVG(PSU)[A],AVG(MEAS/PSU)[%],count,BOARD,CH,AVG(MEAS)[A],AVG(PSU)[A],AVG(MEAS/PSU)[%],count
01,CH01,0.313368119,0.305388571,102.66,252,02,CH09,0.432780092,0.432528333,100.05,240
01,CH02,0.451508569,0.439753292,102.79,240,02,CH10,0.414681704,0.413714405,100.23,252
01,CH03,0.434500523,0.423824375,102.57,240,02,CH11,0.429635591,0.427810208,100.43,240
01,CH04,0.407711541,0.398186627,102.44,252,02,CH12,0.375692224,0.373253125,100.66,240
01,CH05,0.447210100,0.441318917,101.39,240,02,CH13,0.416084279,0.415329048,100.18,252
01,CH06,0.474015488,0.458710500,103.46,240,02,CH14,0.435071408,0.433510417,100.36,240
01,CH07,0.452305621,0.440556905,102.74,252,02,CH15,0.422638461,0.422540875,100.02,240
01,CH08,0.458069550,0.454523833,100.79,240,02,CH16,0.330473810,0.329092937,100.43,252
03,CH17,0.433319712,0.420428083,103.19,240,04,CH25,0.357377468,0.343759881,103.92,252
03,CH18,0.373907998,0.350616292,106.83,240,04,CH26,0.355503889,0.350102917,101.57,240
03,CH19,0.367207891,0.358125675,102.57,252,04,CH27,0.323079678,0.319488958,101.12,240
03,CH20,0.363257849,0.344103250,105.75,240,04,CH28,0.334592369,0.329810794,101.44,252
03,CH21,0.327063569,0.297651750,110.03,240,04,CH29,0.314507002,0.301354625,104.38,240
03,CH22,0.297462896,0.277090317,107.41,252,04,CH30,0.365161180,0.359510167,101.55,240
03,CH23,0.349616487,0.318630042,109.85,240,04,CH31,0.327532721,0.325275317,100.69,252
03,CH24,0.320997881,0.317576625,101.08,240,04,CH32,0.349794343,0.346075375,101.07,240
05,CH33,0.411226809,0.404270167,101.70,240,06,CH41,0.391145983,0.384321167,101.73,240
05,CH34,0.363703458,0.354753294,102.48,252,06,CH42,0.458639797,0.449793708,101.97,240
05,CH35,0.342549761,0.335733125,102.00,240,06,CH43,0.440036583,0.438865476,100.27,252
05,CH36,0.395747491,0.385492208,102.58,240,06,CH44,0.458705447,0.454688792,100.88,240
05,CH37,0.401901280,0.383594087,104.53,252,06,CH45,0.454493839,0.448428333,101.35,240
05,CH38,0.439620976,0.432080125,101.69,240,06,CH46,0.438742721,0.434391190,101.00,252
05,CH39,0.407306051,0.401959708,101.30,240,06,CH47,0.465848600,0.458996167,101.49,240
05,CH40,0.381316280,0.371035595,102.63,252,06,CH48,0.463132649,0.460084875,100.66,240
07,CH49,0.447400112,0.444034762,100.76,252,08,CH57,0.466868590,0.460666208,101.37,240
07,CH50,0.454499746,0.451911583,100.58,240,08,CH58,0.461296993,0.457900913,100.74,252
07,CH51,0.459365642,0.457112458,100.49,240,08,CH59,0.468859714,0.463193417,101.24,240
07,CH52,0.453511182,0.449849881,100.81,252,08,CH60,0.446327418,0.440821000,101.27,240
07,CH53,0.471181445,0.466801917,100.96,240,08,CH61,0.430974913,0.423994643,101.68,252
07,CH54,0.469008569,0.463251542,101.25,240,08,CH62,0.447955665,0.439773833,101.91,240
07,CH55,0.469450619,0.458389563,102.43,252,08,CH63,0.415572559,0.404000875,102.91,240
07,CH56,0.467398717,0.462060750,101.16,240,08,CH64,0.413460446,0.406799246,101.66,252
```

超標通道：無

### 順推分析
+ 用預設值順推，時間序列解算手動選用實際資料「S007202610281236.v299S.csv」。

### 逆推分析(S007202610281236.v299S.WS.ohm)
+ 測線名稱改為「S007202610281236.v299S.WS」
+ 資料剔除次數改為「1」
+ 色階範圍改為「[50,2000]」
+ 其他維持預設值。  
  | S007202610281236.v299S.WS 逆推結果 |
  | :---: |
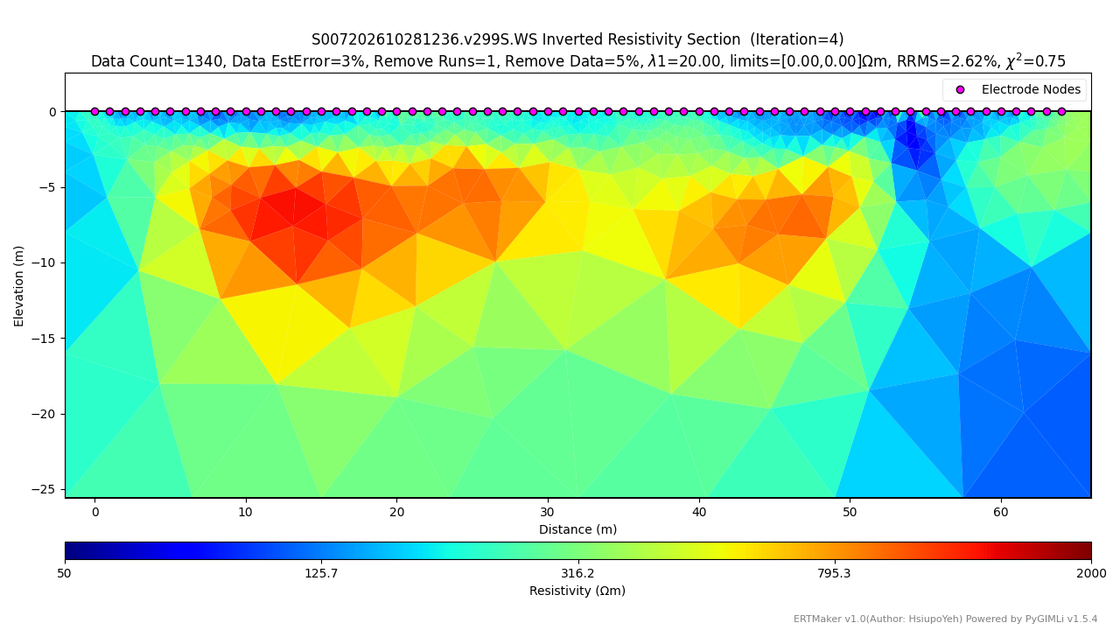
[picture p37: production/SwitchArray/SwitchArray-2026-S007/20261028/S007202610281236.v299S.WS_R01_L01_I04_INV3.png]
  |  |

### 逆推分析(S007202610281236.v299S.WS.PSU.ohm)
+ 測線名稱改為「S007202610281236.v299S.WS.PSU」
+ 資料剔除次數改為「1」
+ 色階範圍改為「[50,2000]」
+ 其他維持預設值。  
  | S007202610281236.v299S.WS.PSU 逆推結果 |
  | :---: |
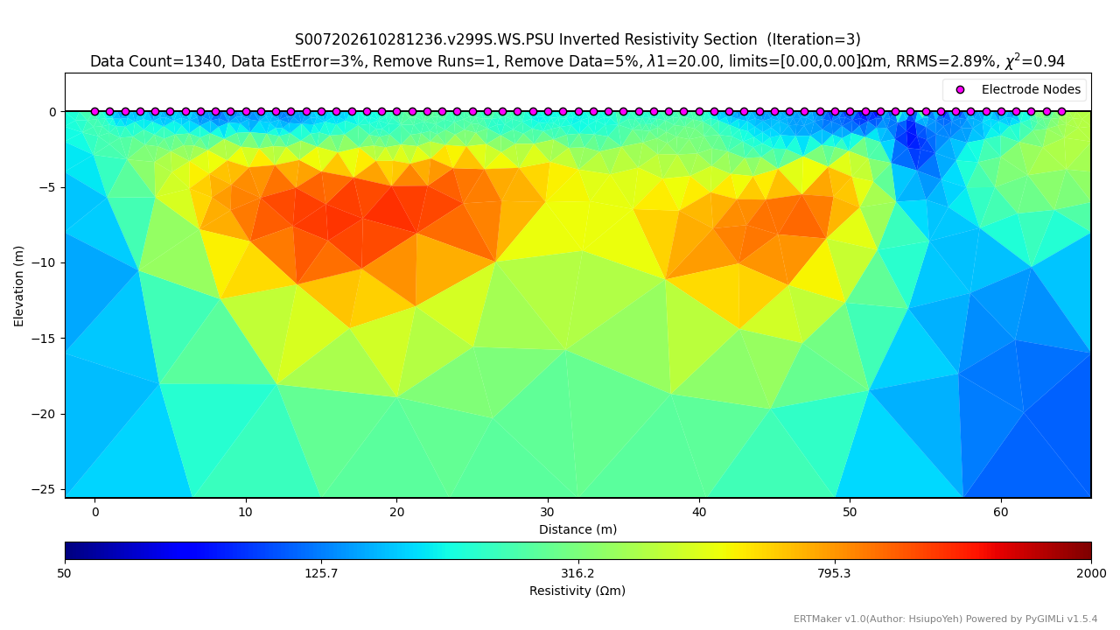
[picture p38: production/SwitchArray/SwitchArray-2026-S007/20261028/S007202610281236.v299S.WS.PSU_R01_L01_I03_INV3.png]
  |  |

### 逆推分析(S007202610281236.v299S.MPR.ohm)
+ 測線名稱改為「S007202610281236.v299S.MPR」
+ 資料剔除次數改為「1」
+ 色階範圍改為「[50,2000]」
+ 其他維持預設值。  
  | S007202610281236.v299S.MPR 逆推結果 |
  | :---: |
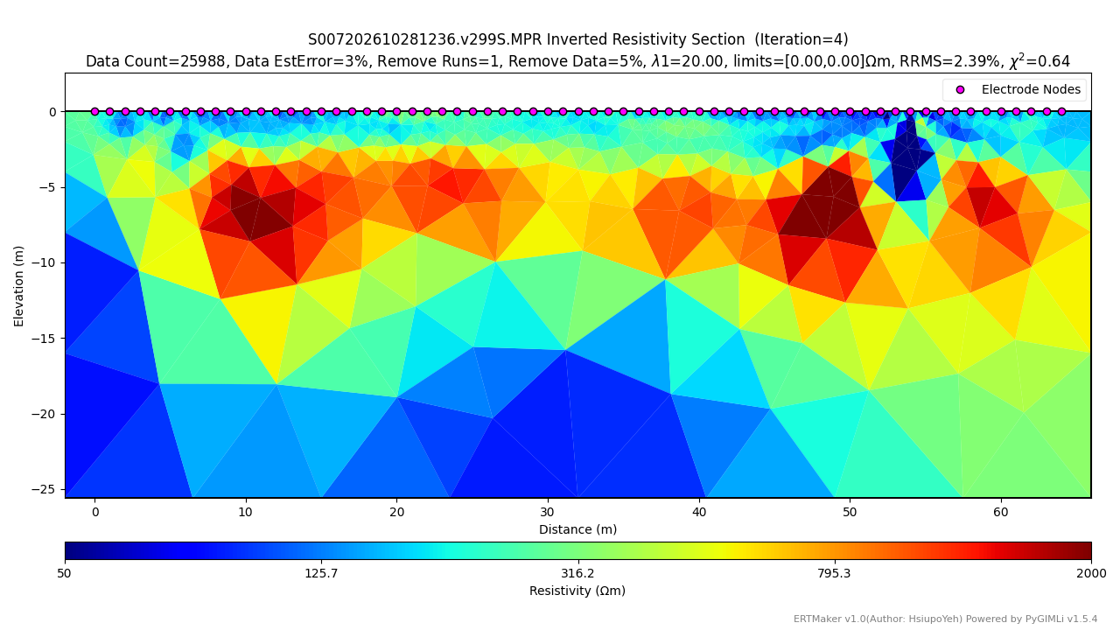
[picture p39: production/SwitchArray/SwitchArray-2026-S007/20261028/S007202610281236.v299S.MPR_R01_L01_I04_INV3.png]
  |  |

### 逆推分析(S007202610281236.v299S.MPR.PSU.ohm)
+ 測線名稱改為「S007202610281236.v299S.MPR.PSU」
+ 資料剔除次數改為「1」
+ 色階範圍改為「[50,2000]」
+ 其他維持預設值。  
  | S007202610281236.v299S.MPR.PSU 逆推結果 |
  | :---: |
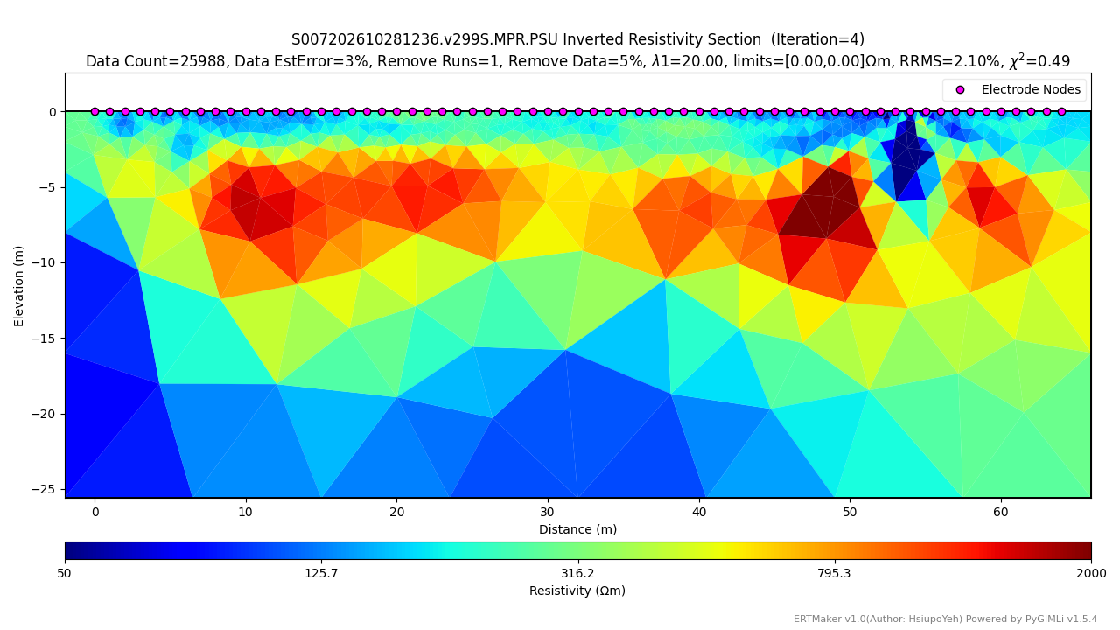
[picture p40: production/SwitchArray/SwitchArray-2026-S007/20261028/S007202610281236.v299S.MPR.PSU_R01_L01_I04_INV3.png]
  |  |

### 逆推分析(S007202610281236.v299S.MGD.ohm)
+ 測線名稱改為「S007202610281236.v299S.MGD」
+ 資料剔除次數改為「1」
+ 色階範圍改為「[50,2000]」
+ 其他維持預設值。  
  | S007202610281236.v299S.MGD 逆推結果 |
  | :---: |
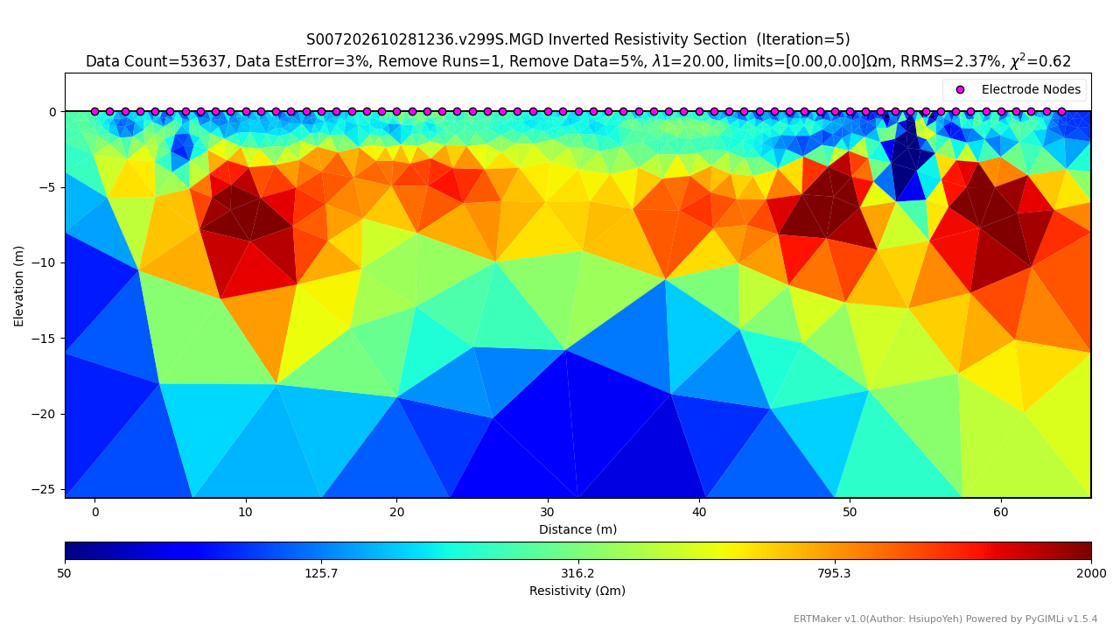
[picture p41: production/SwitchArray/SwitchArray-2026-S007/20261028/S007202610281236.v299S.MGD_R01_L01_I05_INV3.png]
  |  |

### 逆推分析(S007202610281236.v299S.MGD.PSU.ohm)
+ 測線名稱改為「S007202610281236.v299S.MGD.PSU」
+ 資料剔除次數改為「1」
+ 色階範圍改為「[50,2000]」
+ 其他維持預設值。  
  | S007202610281236.v299S.MGD.PSU 逆推結果 |
  | :---: |
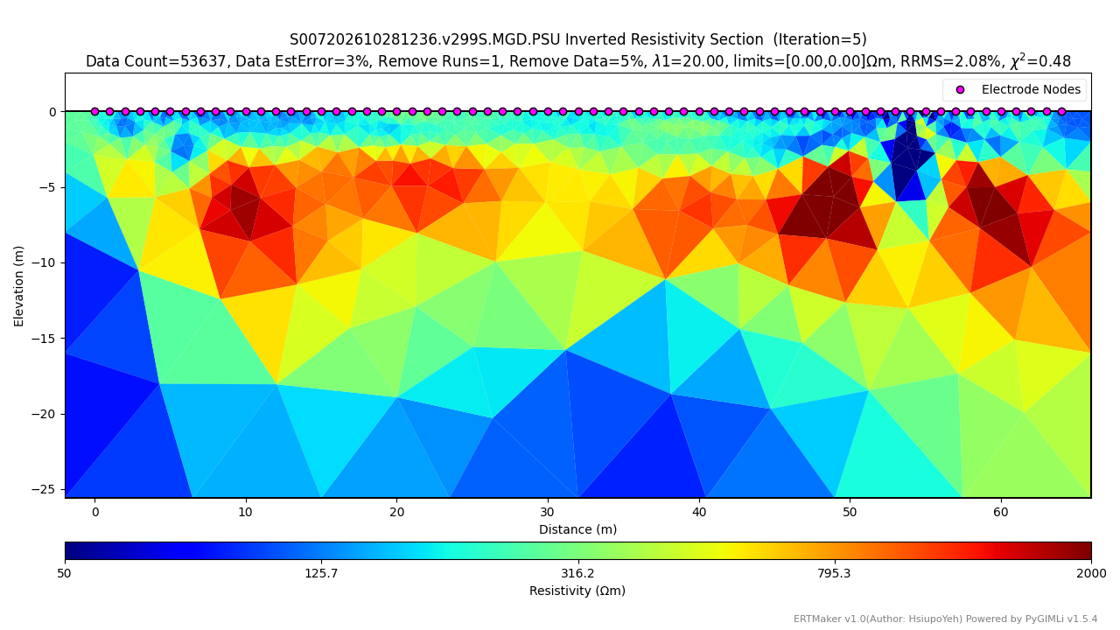
[picture p42: production/SwitchArray/SwitchArray-2026-S007/20261028/S007202610281236.v299S.MGD.PSU_R01_L01_I05_INV3.png]
  |  |

### 逆推分析(S007202610281236.v299S.GD.ohm)
+ 測線名稱改為「S007202610281236.v299S.GD」
+ 資料剔除次數改為「1」
+ 色階範圍改為「[50,2000]」
+ 其他維持預設值。  
  | S007202610281236.v299S.GD 逆推結果 |
  | :---: |
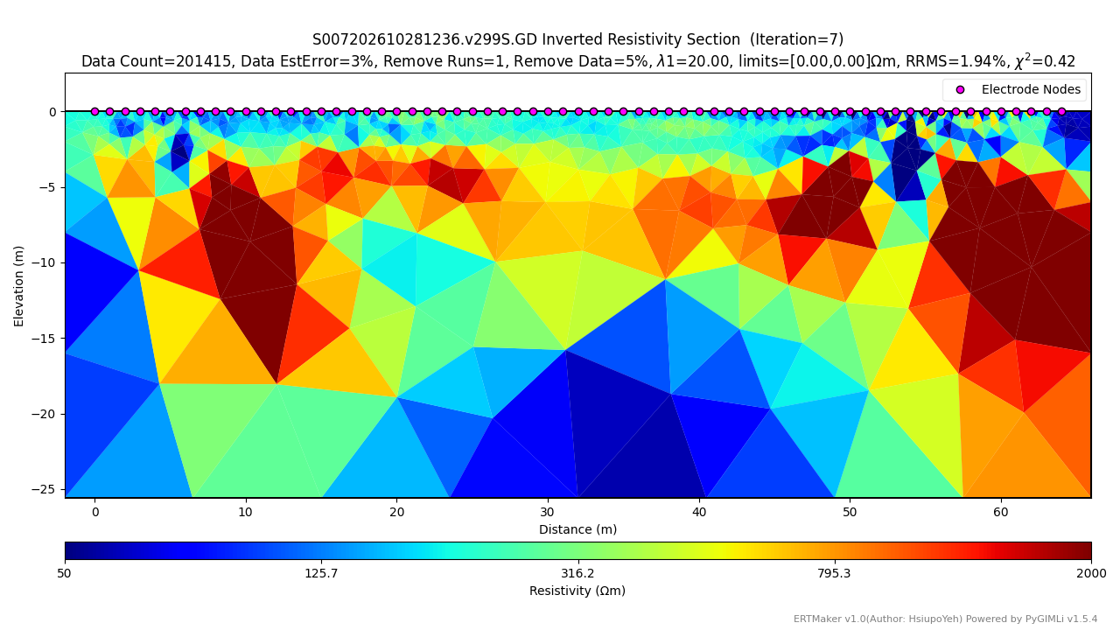
[picture p43: production/SwitchArray/SwitchArray-2026-S007/20261028/S007202610281236.v299S.GD_R01_L01_I07_INV3.png]
  |  |

### 逆推分析(S007202610281236.v299S.GD.PSU.ohm)
+ 測線名稱改為「S007202610281236.v299S.GD.PSU」
+ 資料剔除次數改為「1」
+ 色階範圍改為「[50,2000]」
+ 其他維持預設值。  
  | S007202610281236.v299S.GD.PSU 逆推結果 |
  | :---: |
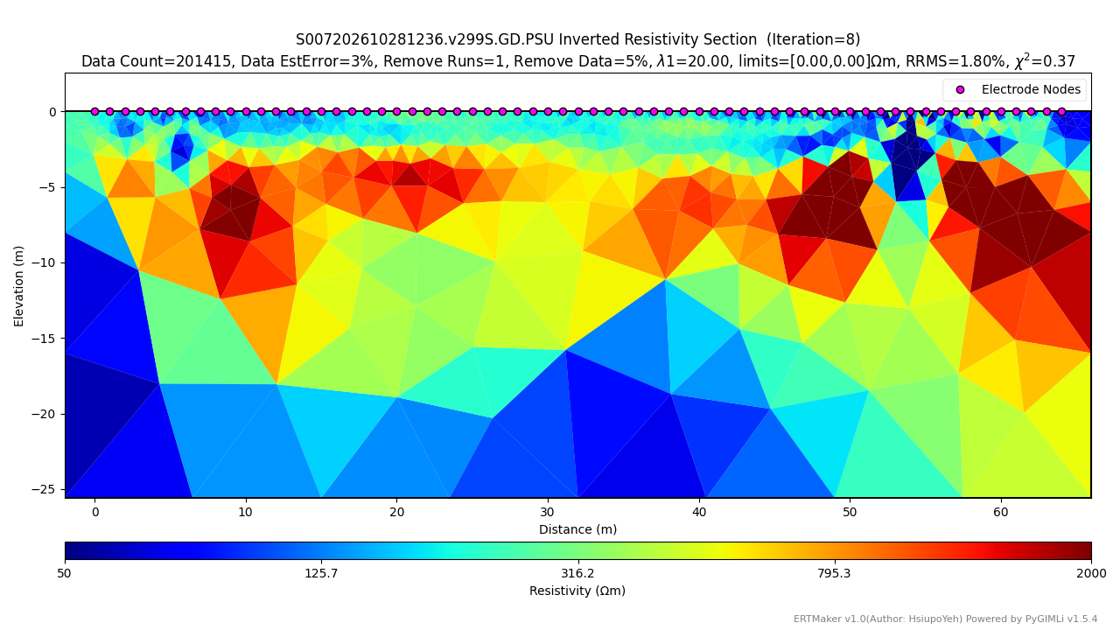
[picture p44: production/SwitchArray/SwitchArray-2026-S007/20261028/S007202610281236.v299S.GD.PSU_R01_L01_I08_INV3.png]
  |  |
