cgrgncu/SwitchArray_info/production/SwitchArray/SwitchArray-2026-S007/20260504/README.md

# SwitchArray-2026-S007 維修檢測完成紀錄
+ 室外檢測完成日期: 2026-05-04
+ 維修內容:
  + 更換USBA公對公傳輸線。

### 時間序列檢視
| 室內浮接測試時間序列 |
| :---: |
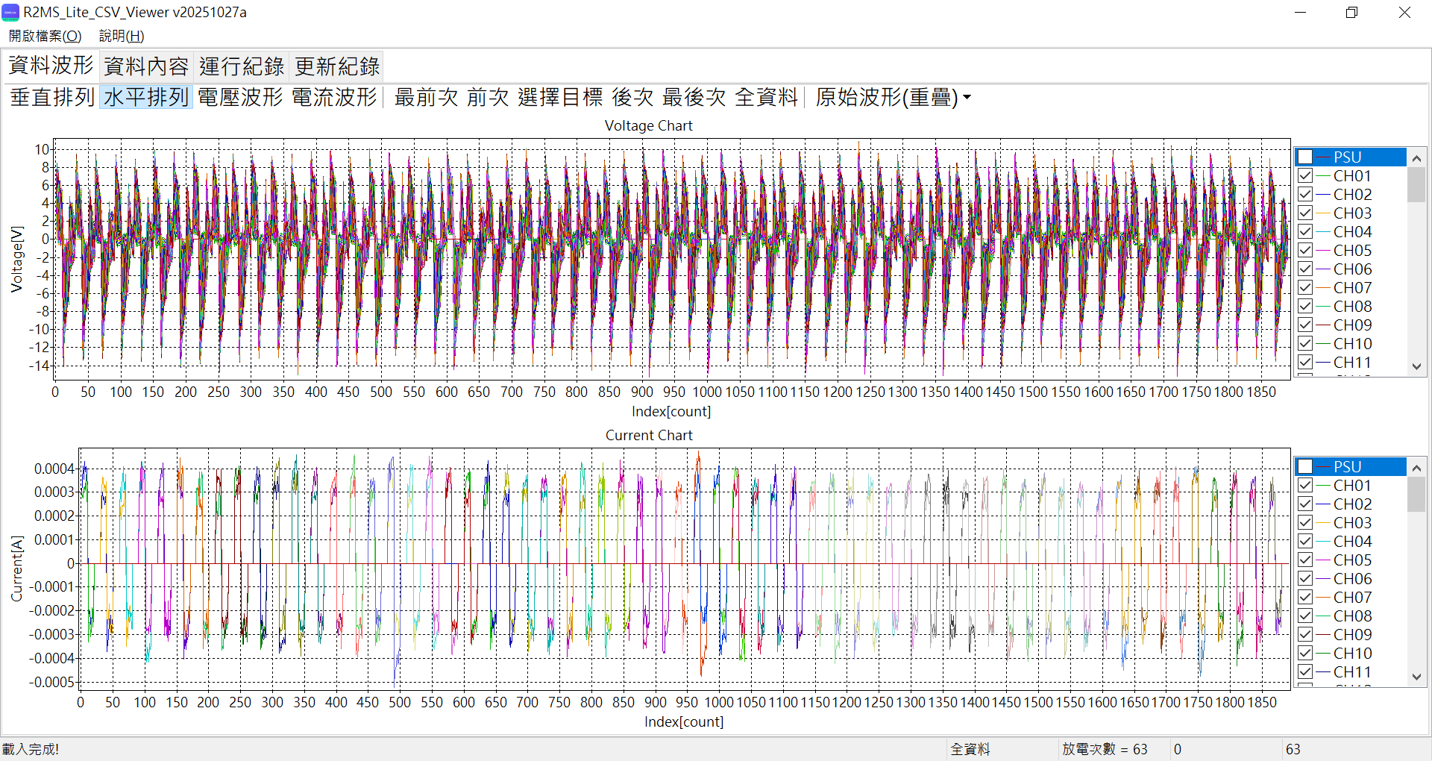
[picture p45: production/SwitchArray/SwitchArray-2026-S007/20260504/S007202604291616_Floating.png]
室內浮接測試時間序列
|  |

| 室內標準地層測試時間序列 |
| :---: |
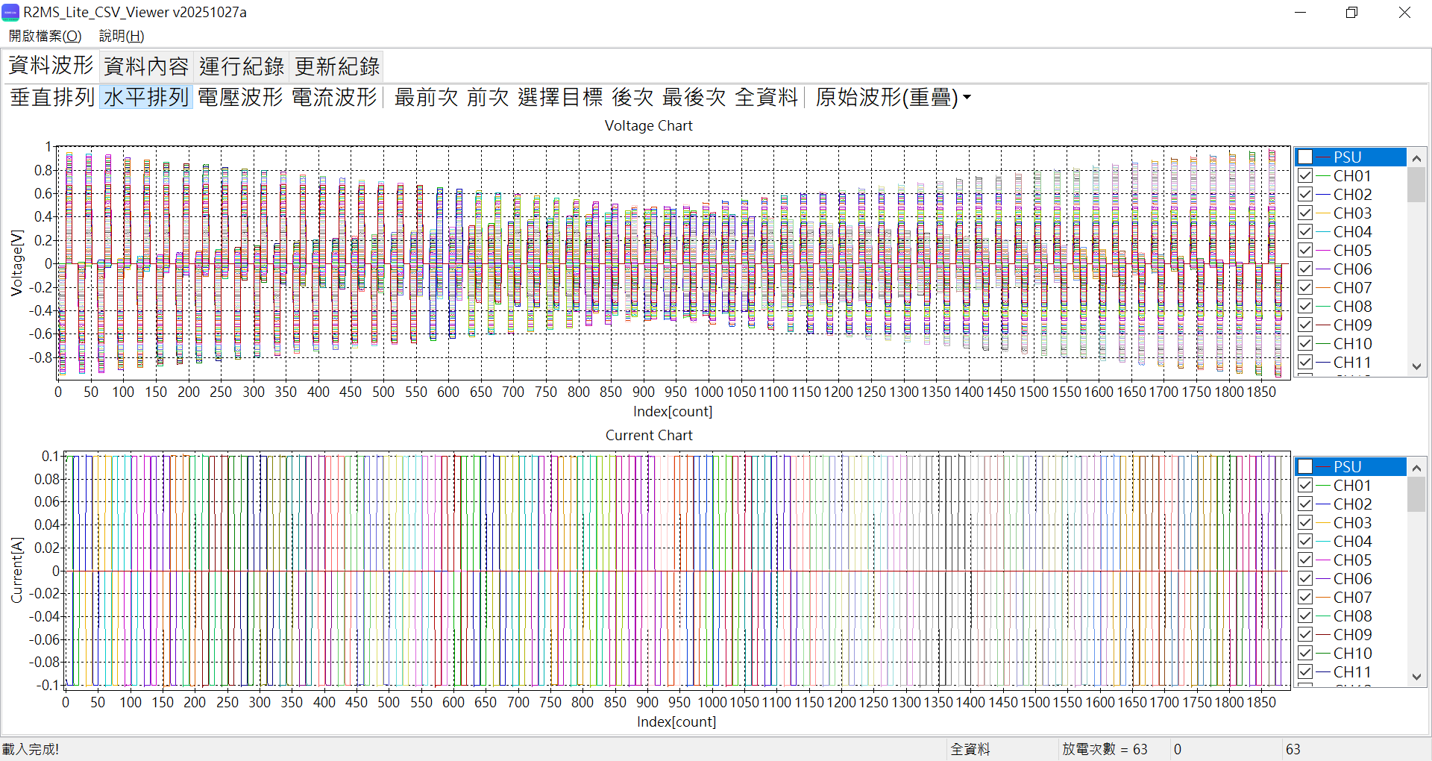
[picture p46: production/SwitchArray/SwitchArray-2026-S007/20260504/S007202604291637_StandardResistor.png]
室內標準地層測試時間序列
|  |

| 野外測試時間序列 |
| :---: |
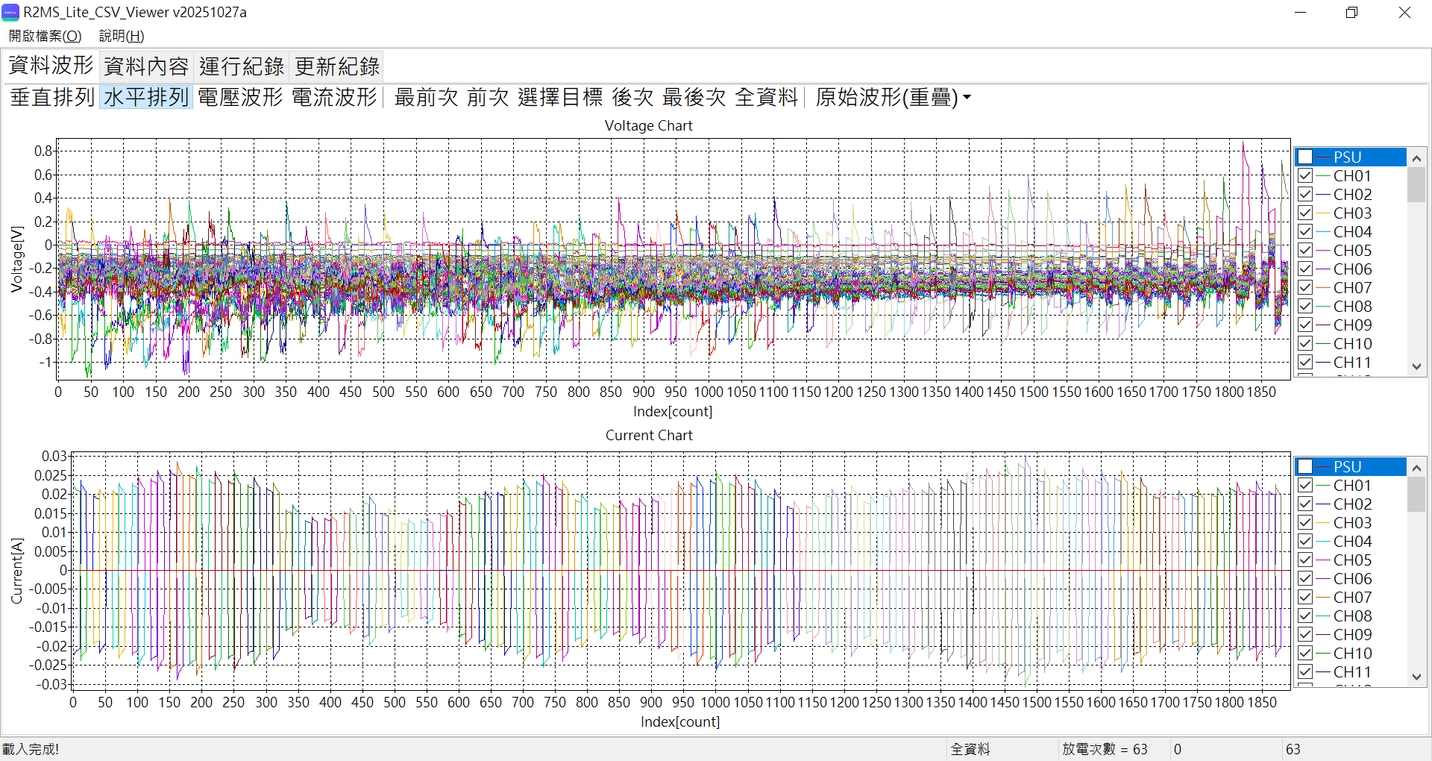
[picture p47: production/SwitchArray/SwitchArray-2026-S007/20260504/S007202605041624_FieldTest.png]
野外測試時間序列
|  |

| NCU草坪時間序列 |
| :---: |
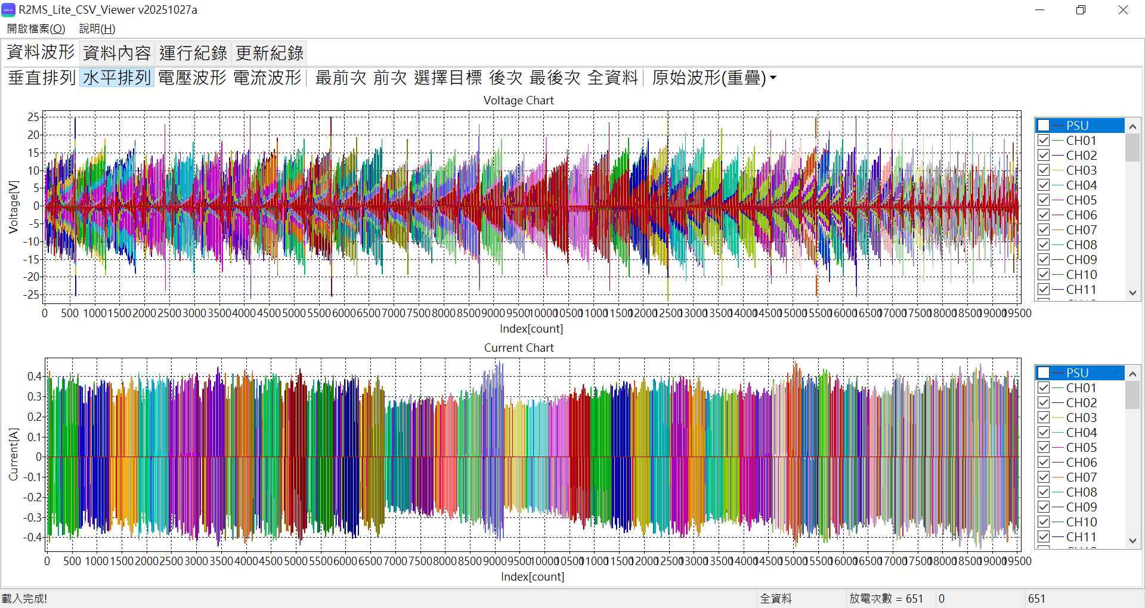
[picture p48: production/SwitchArray/SwitchArray-2026-S007/20260504/S007202605041630_NCUQC.png]
NCU草坪時間序列
|  |
| *看起來CH17、CH33好像有點跟別台不同。 |
### 順推分析
+ 用預設值順推，時間序列解算手動選用實際資料「S007202605041630.v299S.csv」。

### 逆推分析(S007202605041630.v299S.WS.ohm)
+ 測線名稱改為「S007202605041630.v299S.WS」
+ 資料剔除數量改為「1」
+ 色階範圍改為「[50,2000]」
+ 其他維持預設值。  
  | S007202605041630.v299S.WS 逆推結果 |
  | :---: |
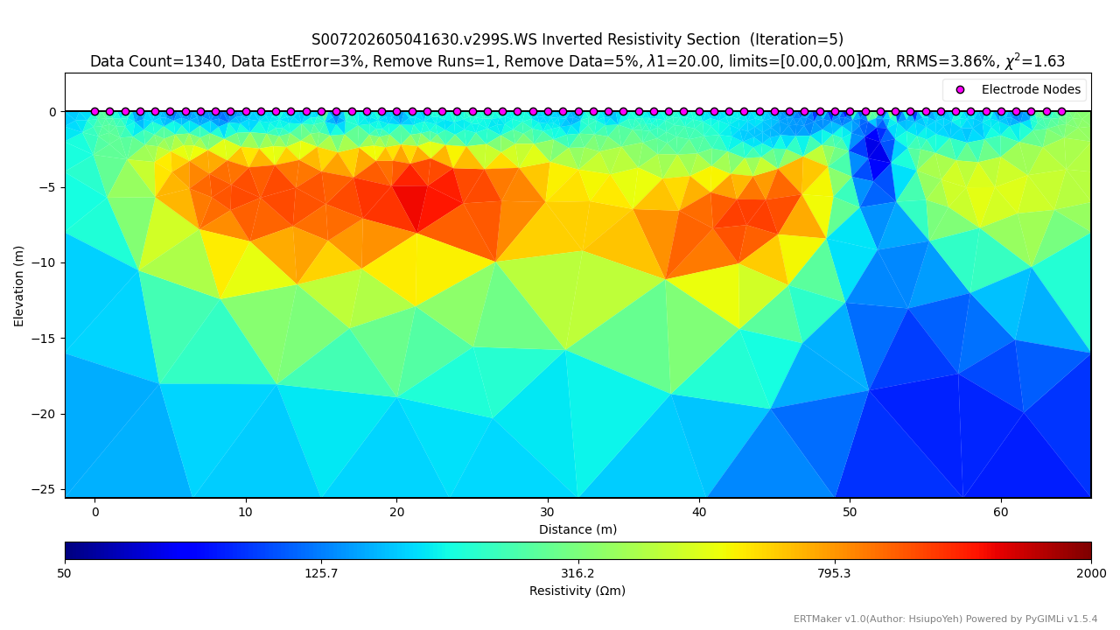
[picture p49: production/SwitchArray/SwitchArray-2026-S007/20260504/S007202605041630.v299S.WS_R01_L01_I05_INV3.png]
逆推結果
  |  |
