cgrgncu/SwitchArray_info/production/SwitchArray/SwitchArray-2026-S008/20260519/README.md

# SwitchArray-2026-S008 檢測完成紀錄
+ 室外檢測完成日期: 2026-05-19
+ 維修內容:
  + RelayBoard調整，登記序號。

### 時間序列檢視
| 室內浮接測試時間序列 |
| :---: |
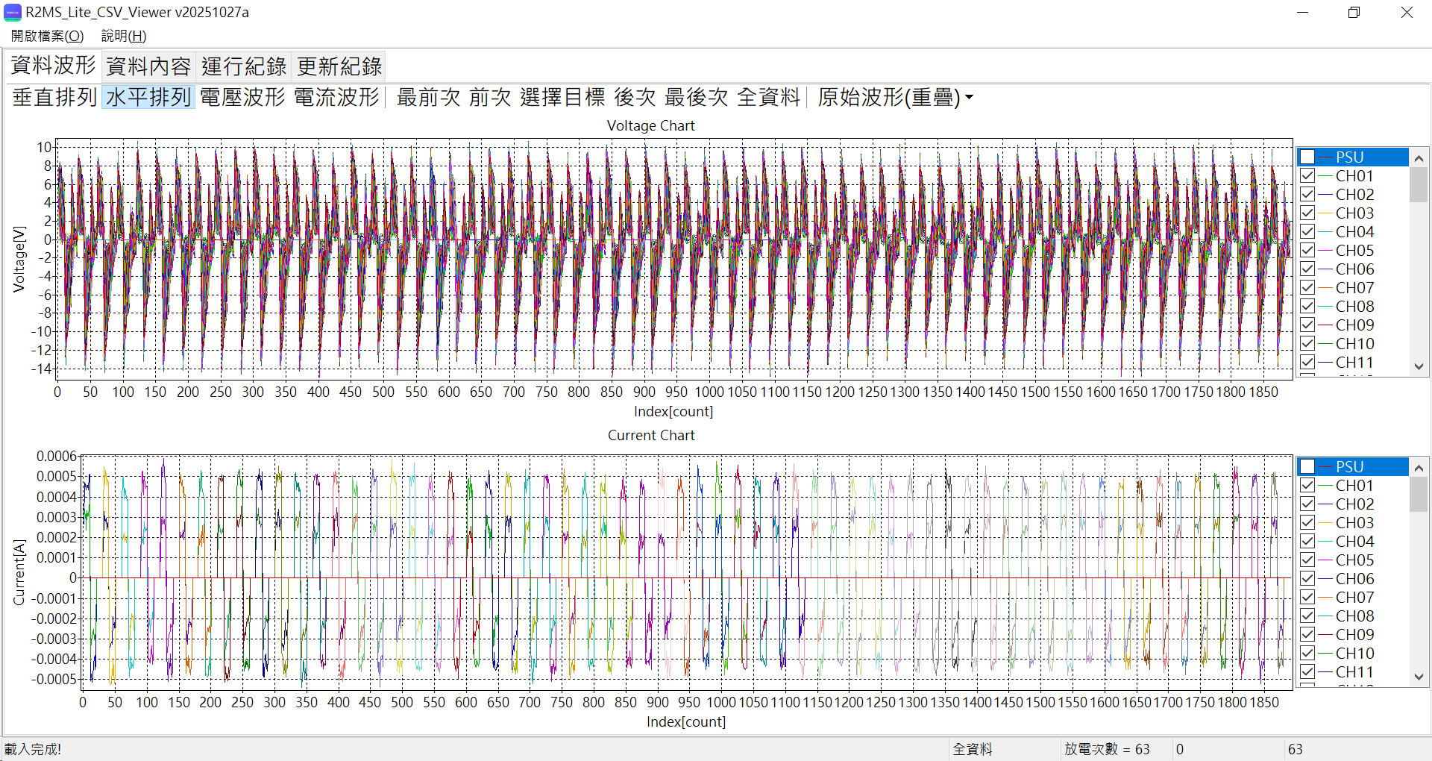
[picture p50: production/SwitchArray/SwitchArray-2026-S008/20260519/S008202605261040_Floating.png]
室內浮接測試時間序列
|  |

| 室內標準地層測試時間序列 |
| :---: |
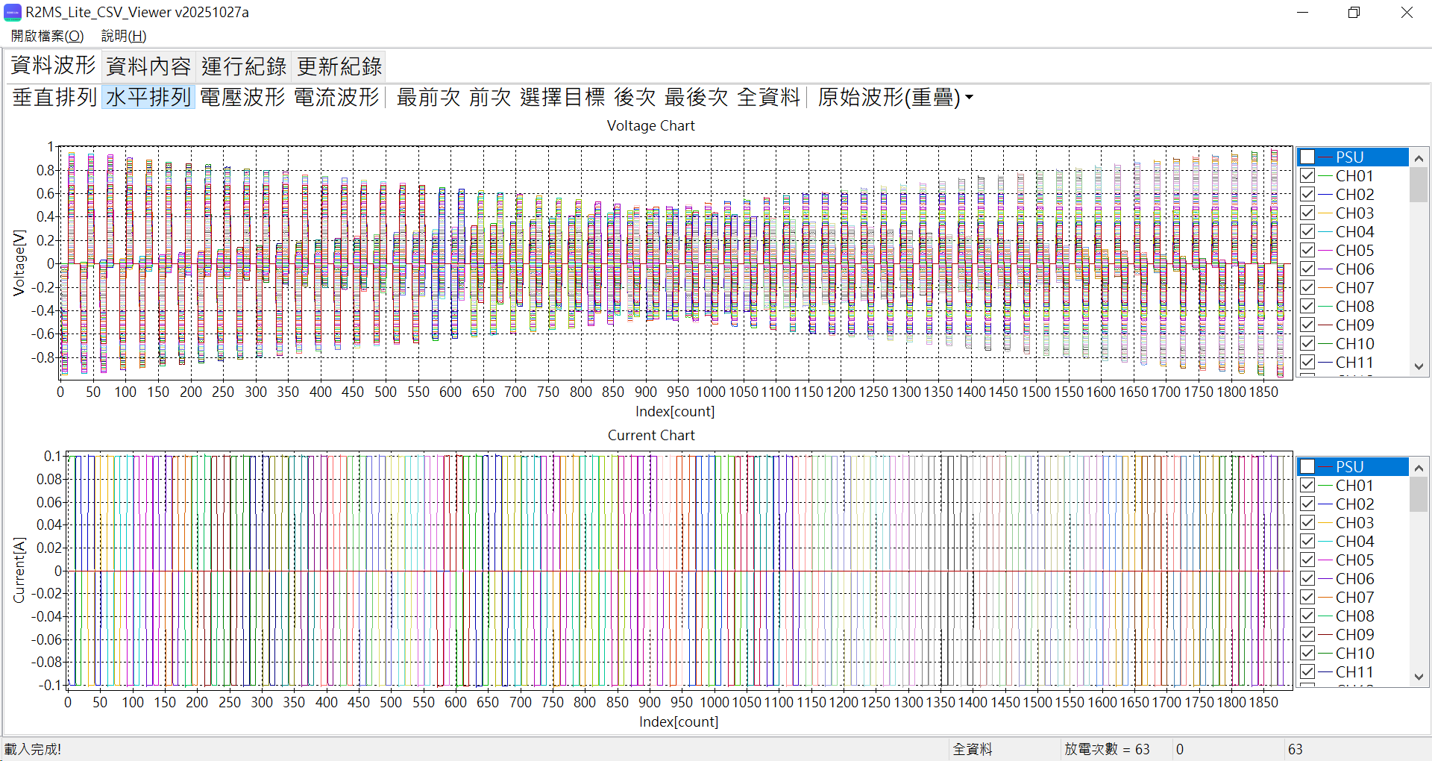
[picture p51: production/SwitchArray/SwitchArray-2026-S008/20260519/S008202605261058_StandardResistor.png]
室內標準地層測試時間序列
|  |

| 野外測試時間序列 |
| :---: |
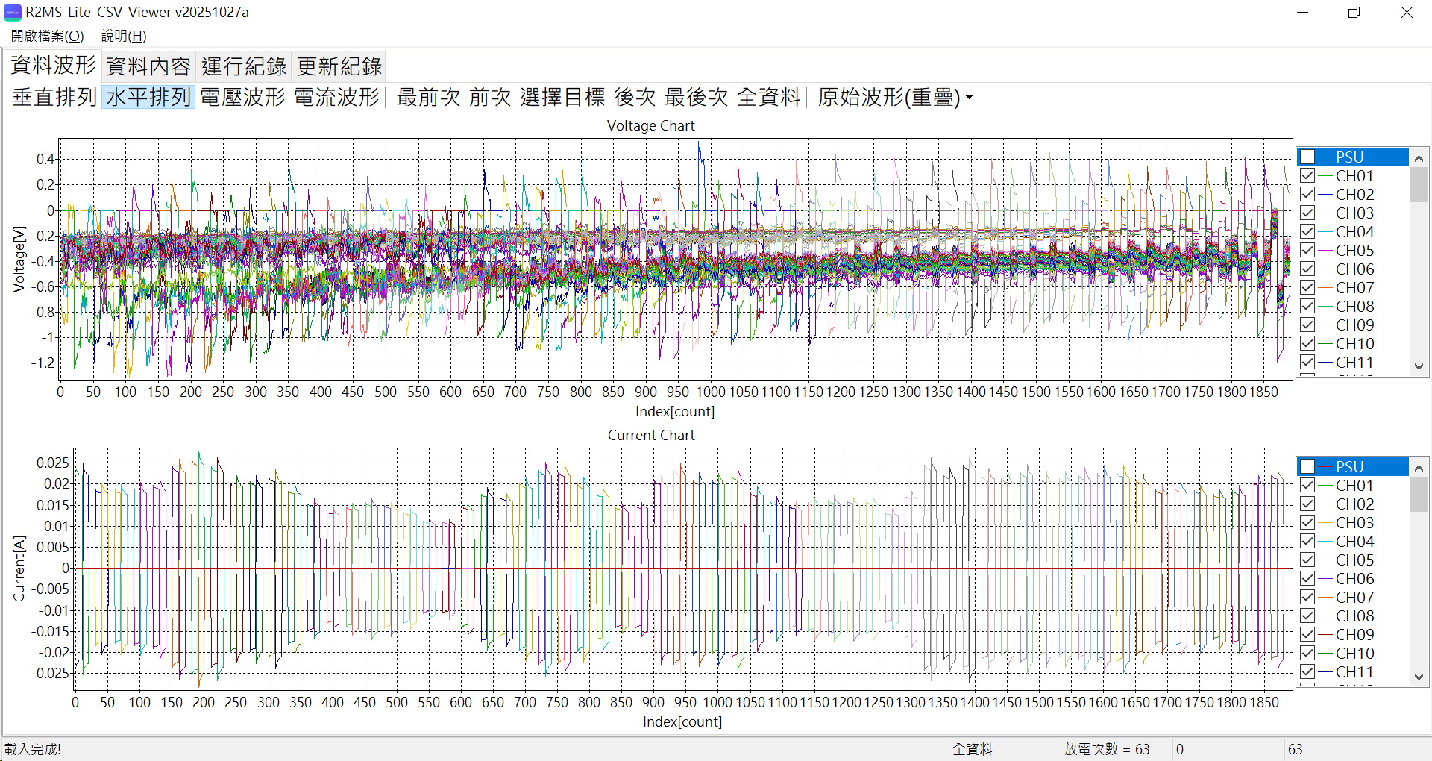
[picture p52: production/SwitchArray/SwitchArray-2026-S008/20260519/S008202605191300_FieldTest.png]
野外測試時間序列
|  |

| NCU草坪時間序列 |
| :---: |
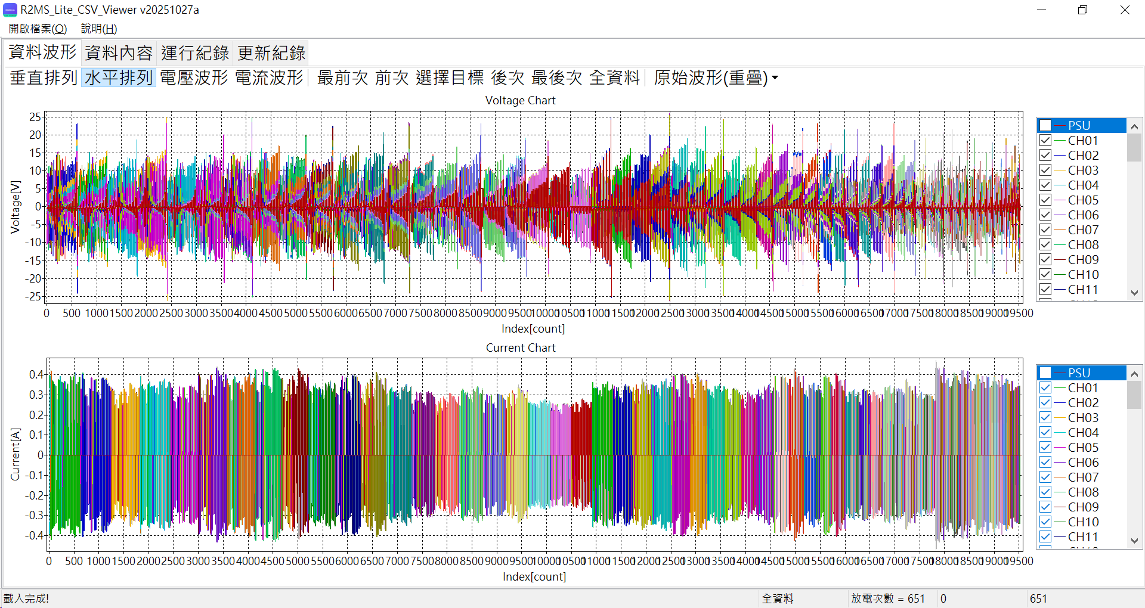
[picture p53: production/SwitchArray/SwitchArray-2026-S008/20260519/S008202605191313_NCUQC.png]
NCU草坪時間序列
|  |

### 順推分析
+ 用預設值順推，時間序列解算手動選用實際資料「S009202605201254.v299S.csv」。

### 逆推分析(S008202605191313.v299S.WS.ohm)
+ 測線名稱改為「S008202605191313.v299S.WS」
+ 資料剔除數量改為「1」
+ 色階範圍改為「[50,2000]」
+ 其他維持預設值。  
  | S008202605191313.v299S.WS 逆推結果 |
  | :---: |
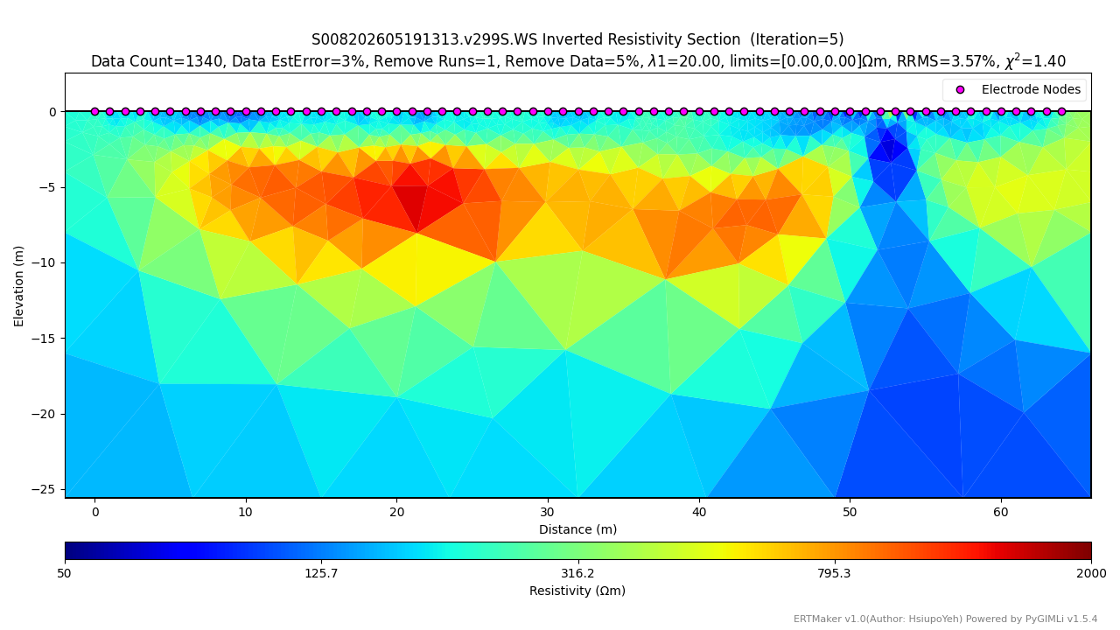
[picture p54: production/SwitchArray/SwitchArray-2026-S008/20260519/S008202605191313.v299S.WS_R01_L01_I05_INV3.png]
  |  |

### 逆推分析(S008202605191313.v299S.MPR.ohm)
+ 測線名稱改為「S008202605191313.v299S.MPR」
+ 資料剔除數量改為「1」
+ 色階範圍改為「[50,2000]」
+ 其他維持預設值。  
  | S008202605191313.v299S.MPR 逆推結果 |
  | :---: |
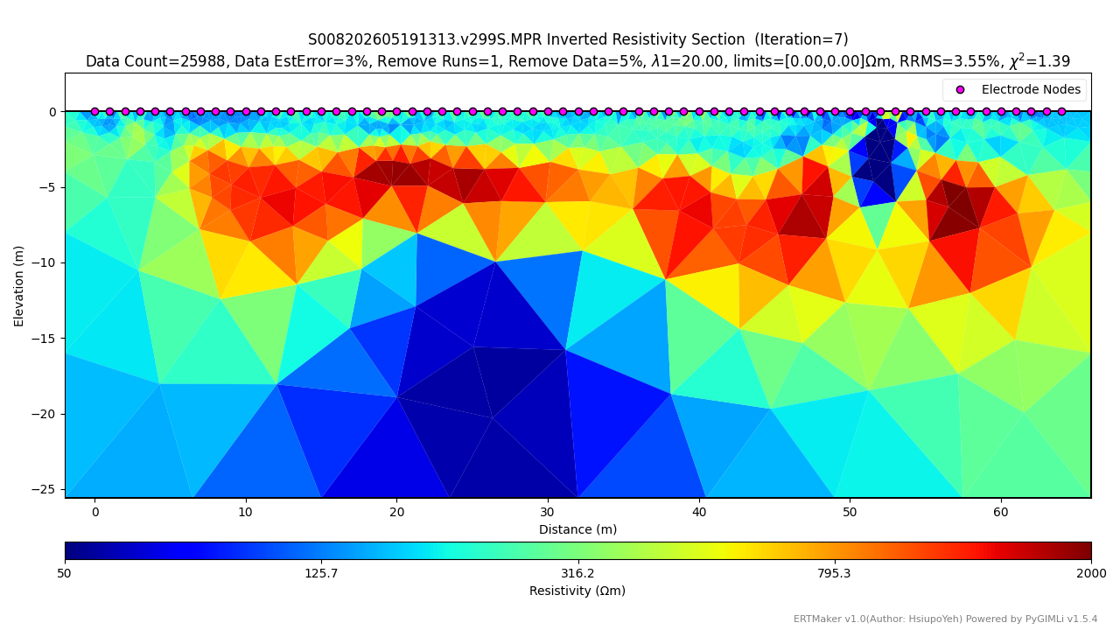
[picture p55: production/SwitchArray/SwitchArray-2026-S008/20260519/S008202605191313.v299S.MPR_R01_L01_I07_INV3.png]
  |  |

### 逆推分析(S008202605191313.v299S.MGD.ohm)
+ 測線名稱改為「S008202605191313.v299S.MGD」
+ 資料剔除數量改為「1」
+ 色階範圍改為「[50,2000]」
+ 其他維持預設值。  
  | S008202605191313.v299S.MGD 逆推結果 |
  | :---: |
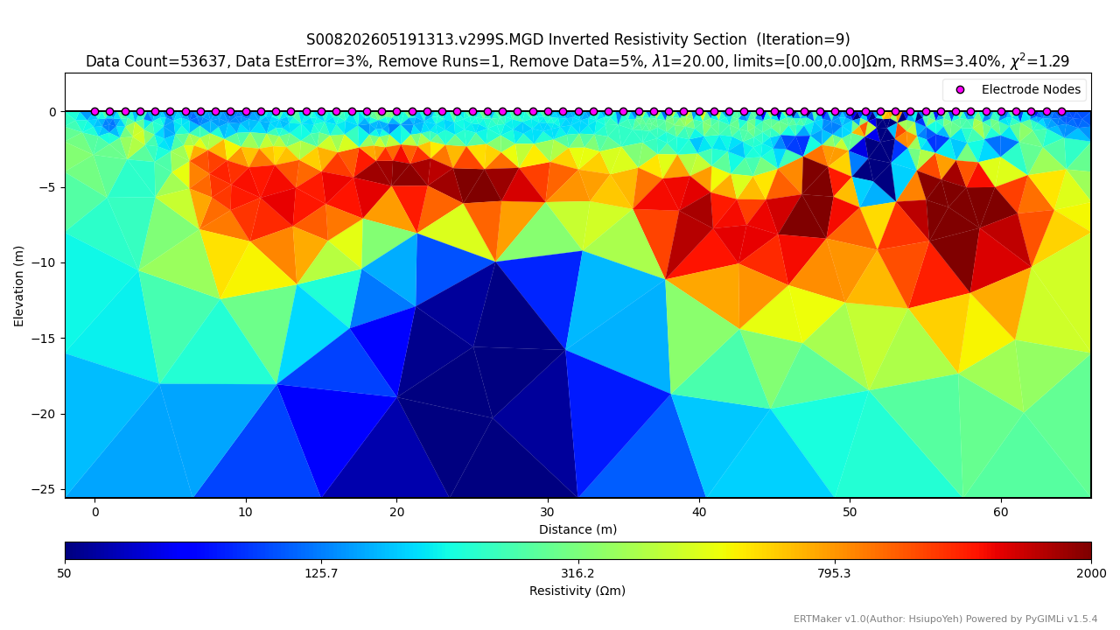
[picture p56: production/SwitchArray/SwitchArray-2026-S008/20260519/S008202605191313.v299S.MGD_R01_L01_I09_INV3.png]
  |  |

### 逆推分析(S006202605041542.v299S.GD.ohm)
+ 測線名稱改為「S006202605041542.v299S.GD」
+ 資料剔除數量改為「1」
+ 色階範圍改為「[50,2000]」
+ 其他維持預設值。  
  | S006202605041542.v299S.GD 逆推結果 |
  | :---: |
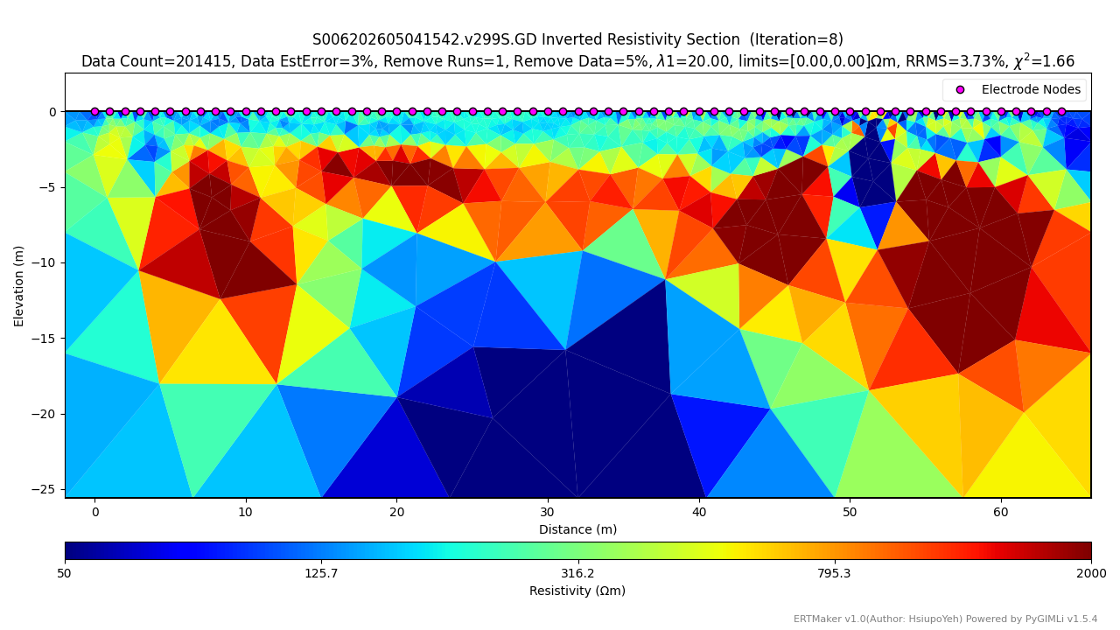
[picture p57: production/SwitchArray/SwitchArray-2025-S006/20260504/S006202605041542.v299S.GD_R01_L01_I08_INV3.png]
  |  |
