cgrgncu/SwitchArray_info/production/SwitchArray/SwitchArray-2026-S009/20260520/README.md

# SwitchArray-2026-S009 檢測完成紀錄
+ 室外檢測完成日期: 2026-05-20
+ 維修內容:
  + RelayBoard調整，登記序號。

### 時間序列檢視
| 室內浮接測試時間序列 |
| :---: |
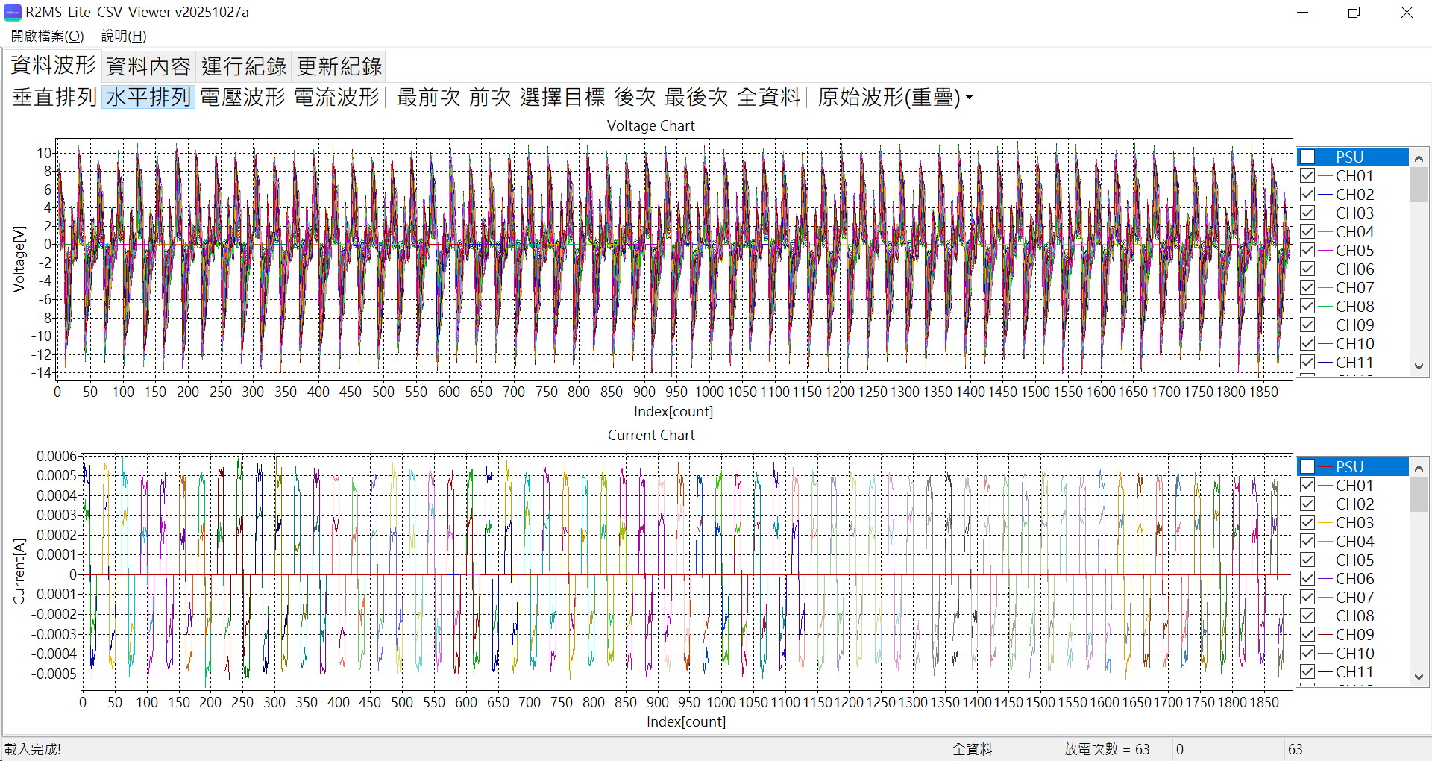
[picture p58: production/SwitchArray/SwitchArray-2026-S009/20260520/S009202605260953_Floating.png]
室內浮接測試時間序列
|  |

| 室內標準地層測試時間序列 |
| :---: |
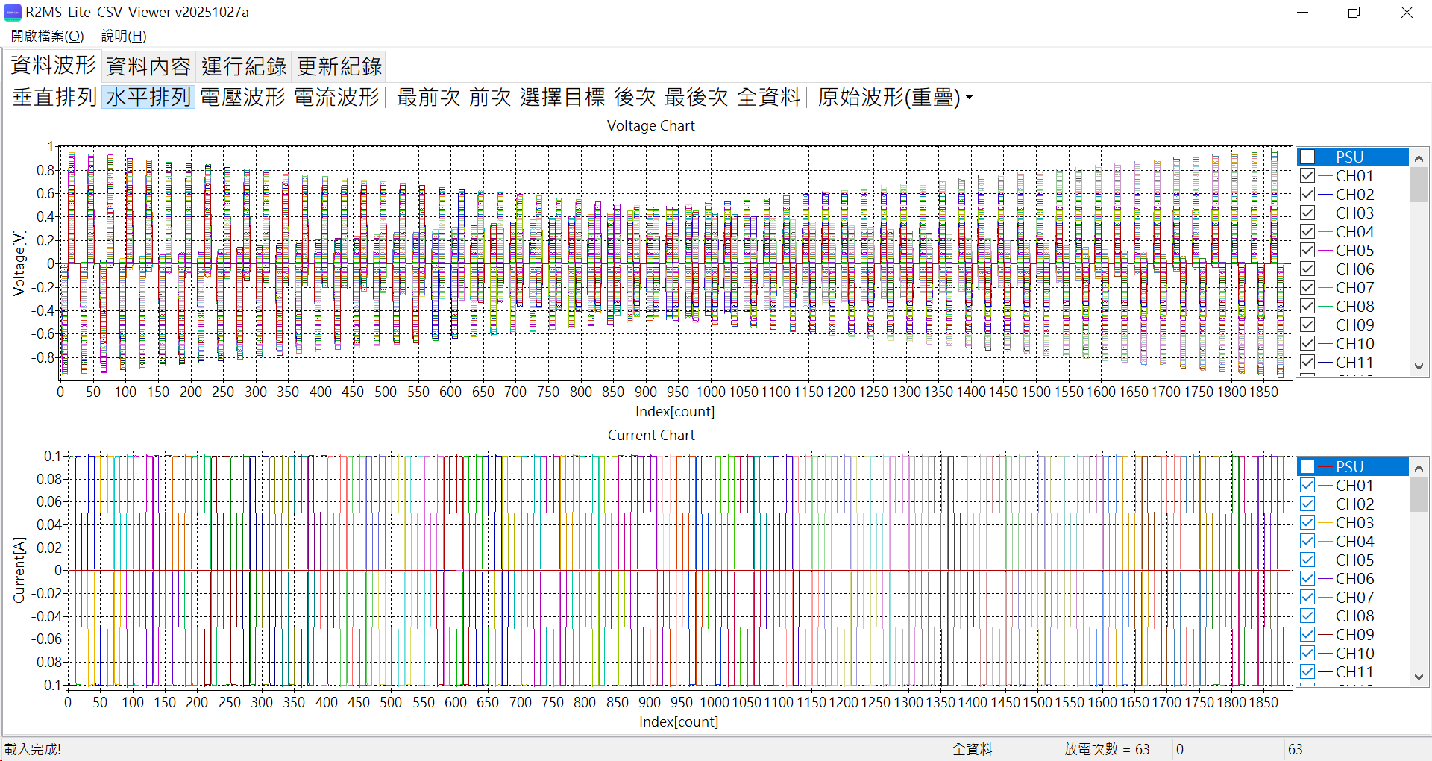
[picture p59: production/SwitchArray/SwitchArray-2026-S009/20260520/S009202605261001_StandardResistor.png]
室內標準地層測試時間序列
|  |

| 野外測試時間序列 |
| :---: |
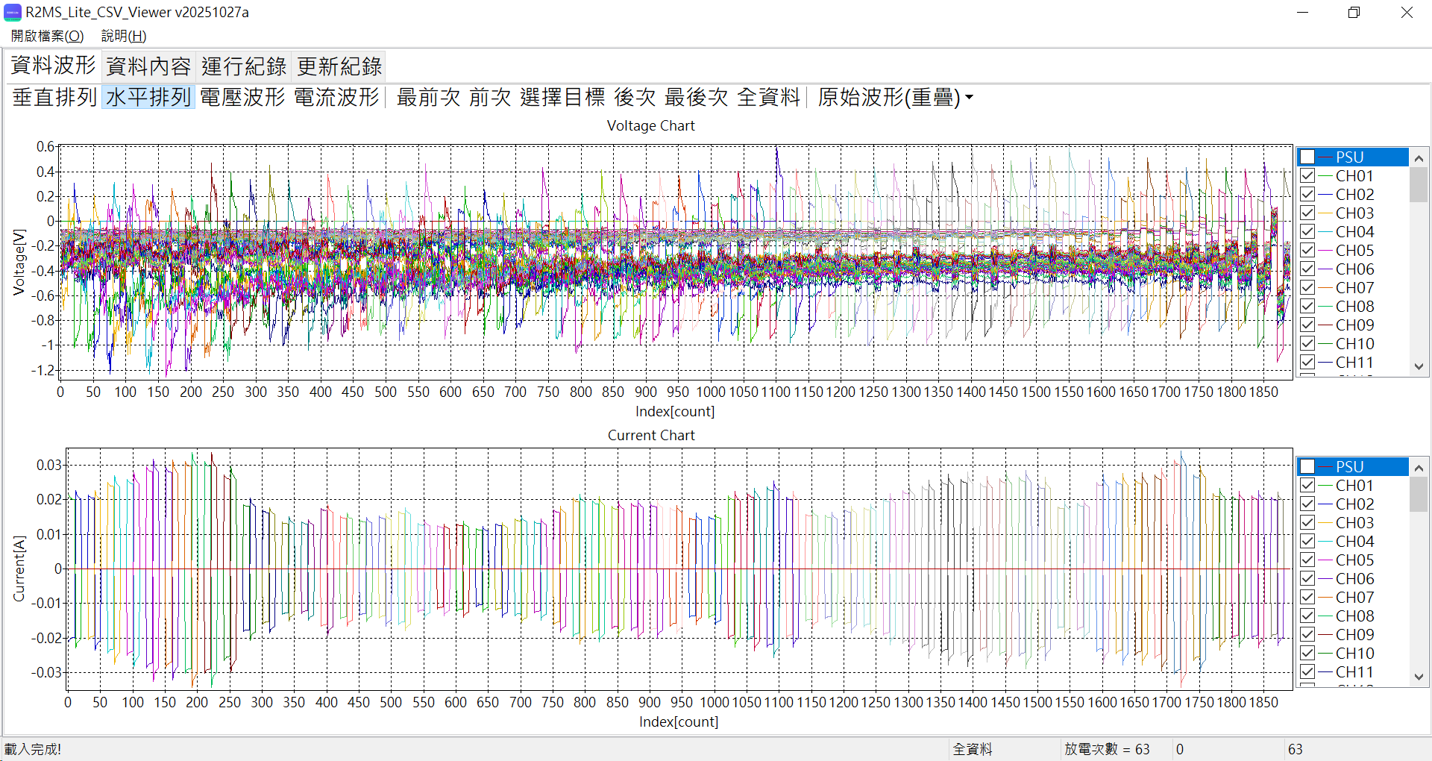
[picture p60: production/SwitchArray/SwitchArray-2026-S009/20260520/S009202605201216_FieldTest.png]
野外測試時間序列
|  |

| NCU草坪時間序列 |
| :---: |
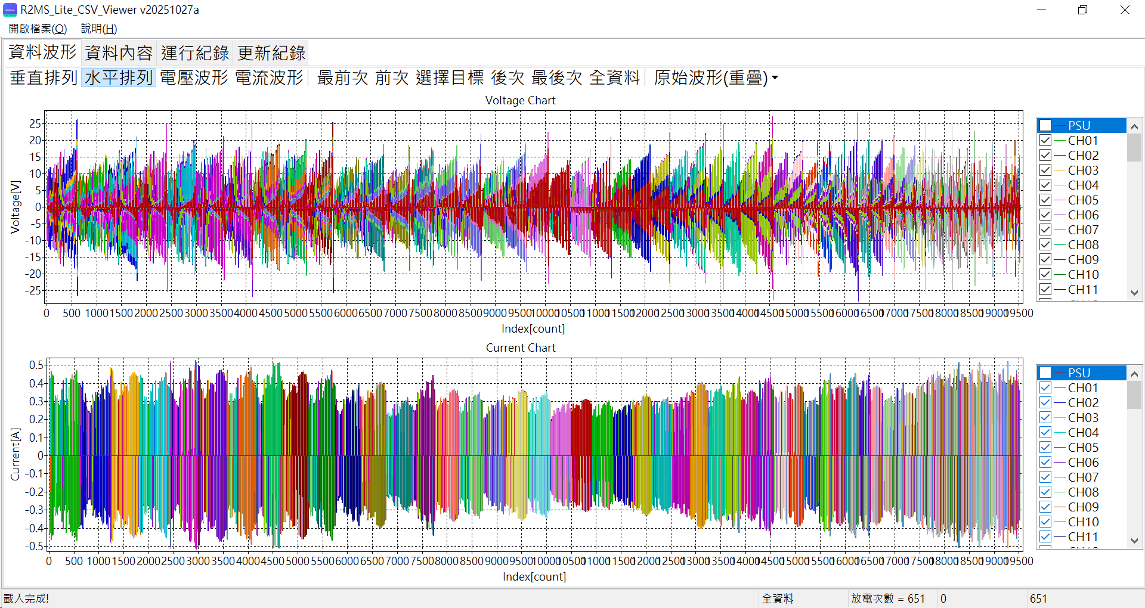
[picture p61: production/SwitchArray/SwitchArray-2026-S009/20260520/S009202605201254_NCUQC.png]
NCU草坪時間序列
|  |

### 順推分析
+ 用預設值順推，時間序列解算手動選用實際資料「S009202605201254.v299S.csv」。

### 逆推分析(S009202605201254.v299S.WS.ohm)
+ 測線名稱改為「S009202605201254.v299S.WS」
+ 資料剔除數量改為「1」
+ 色階範圍改為「[50,2000]」
+ 其他維持預設值。  
  | S009202605201254.v299S.WS 逆推結果 |
  | :---: |
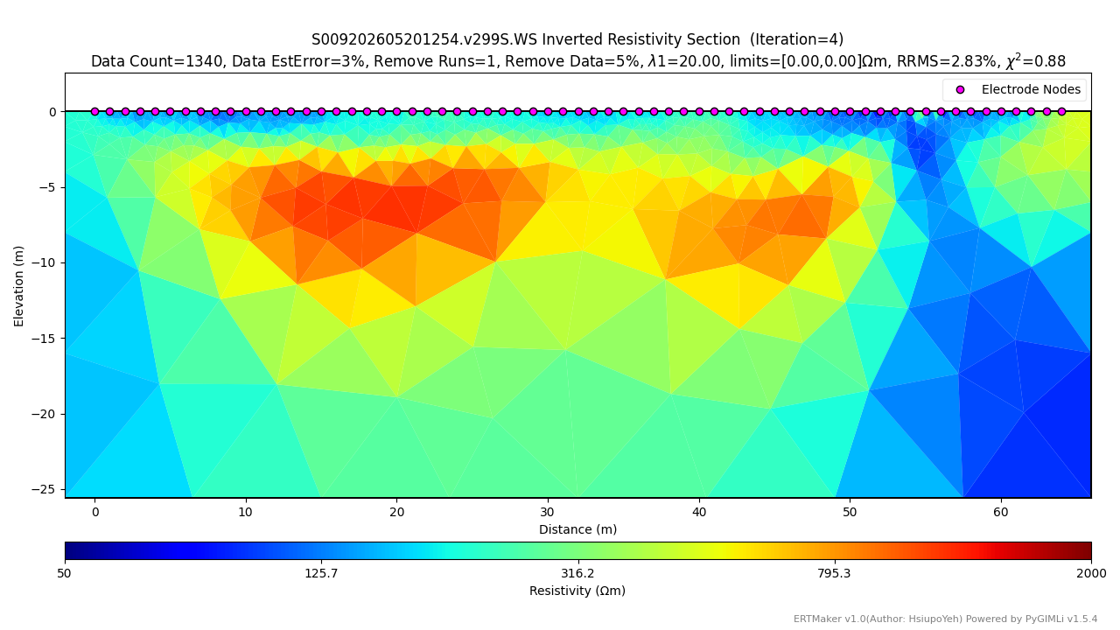
[picture p62: production/SwitchArray/SwitchArray-2026-S009/20260520/S009202605201254.v299S.WS_R01_L01_I04_INV3.png]
  |  |

### 逆推分析(S009202605201254.v299S.MPR.ohm)
+ 測線名稱改為「S009202605201254.v299S.MPR」
+ 資料剔除數量改為「1」
+ 色階範圍改為「[50,2000]」
+ 其他維持預設值。  
  | S009202605201254.v299S.MPR 逆推結果 |
  | :---: |
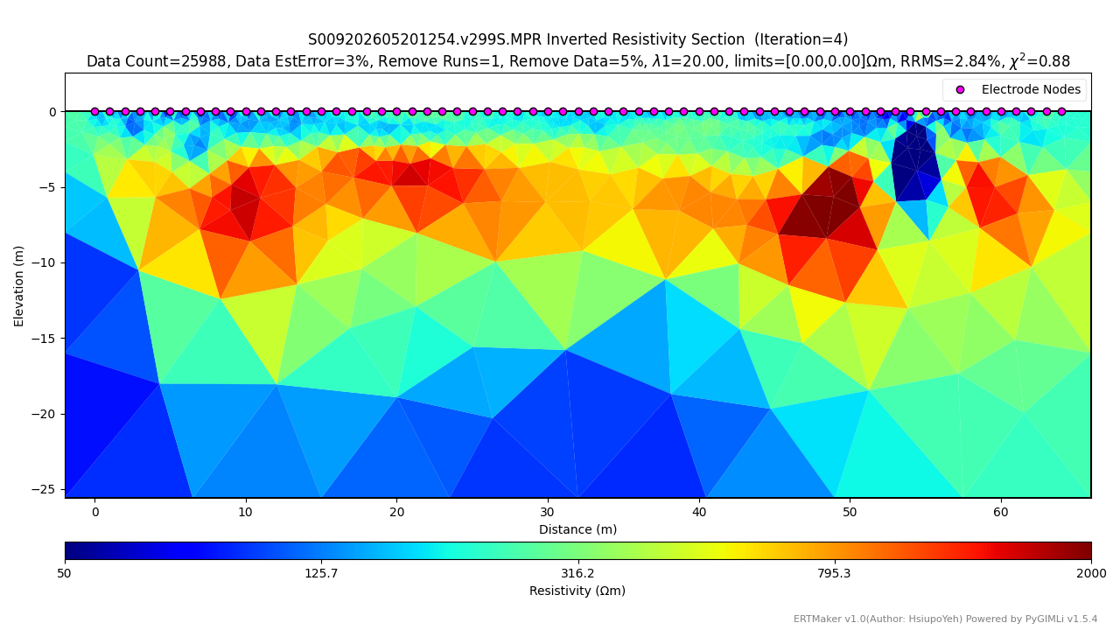
[picture p63: production/SwitchArray/SwitchArray-2026-S009/20260520/S009202605201254.v299S.MPR_R01_L01_I04_INV3.png]
  |  |

### 逆推分析(S009202605201254.v299S.MGD.ohm)
+ 測線名稱改為「S009202605201254.v299S.MGD」
+ 資料剔除數量改為「1」
+ 色階範圍改為「[50,2000]」
+ 其他維持預設值。  
  | S009202605201254.v299S.MGD 逆推結果 |
  | :---: |
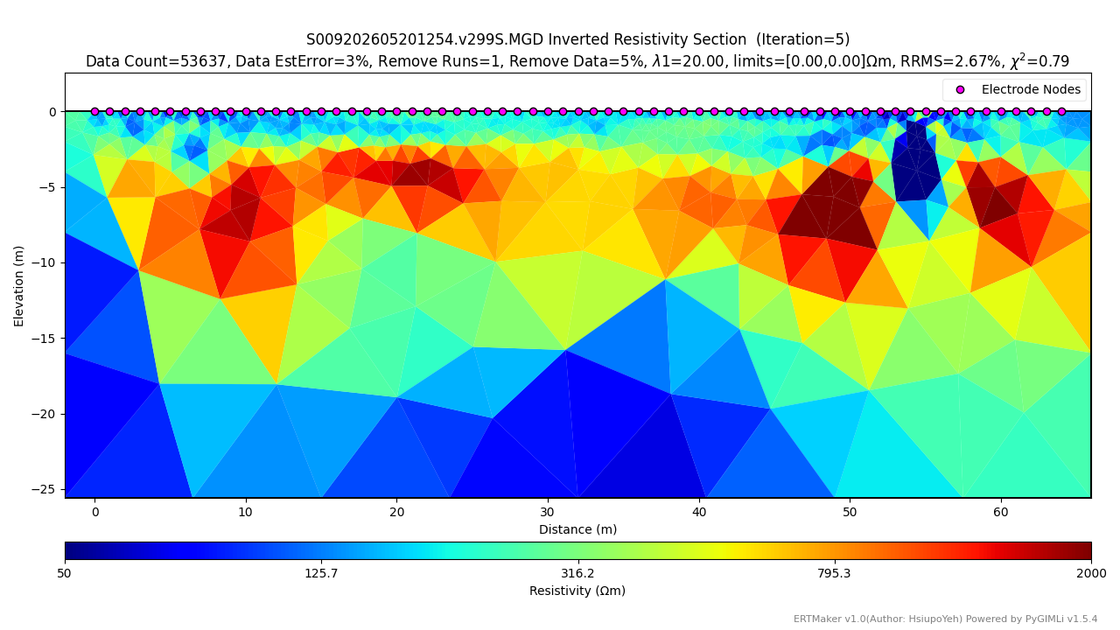
[picture p64: production/SwitchArray/SwitchArray-2026-S009/20260520/S009202605201254.v299S.MGD_R01_L01_I05_INV3.png]
  |  |

### 逆推分析(S009202605201254.v299S.GD.ohm)
+ 測線名稱改為「S009202605201254.v299S.GD」
+ 資料剔除數量改為「1」
+ 色階範圍改為「[50,2000]」
+ 其他維持預設值。  
  | S009202605201254.v299S.GD 逆推結果 |
  | :---: |
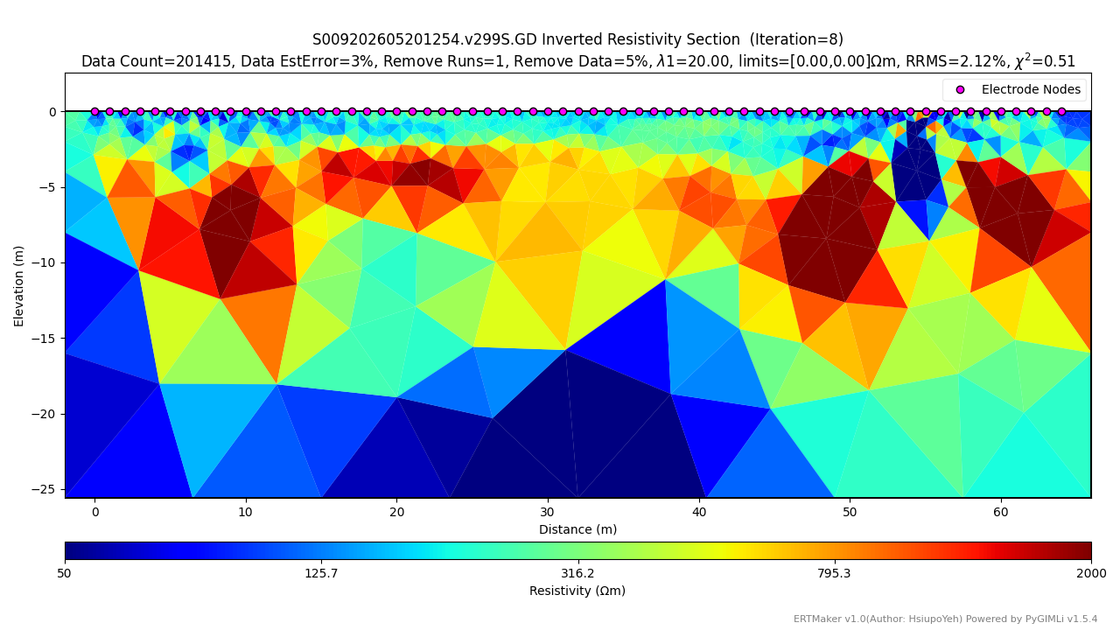
[picture p65: production/SwitchArray/SwitchArray-2026-S009/20260520/S009202605201254.v299S.GD_R01_L01_I08_INV3.png]
  |  |
