cgrgncu/SwitchArray_info/組裝紀錄.md

# 組裝紀錄

### 2024-07-09
+ 主控制板(ESP32)配線規定:
  + REF用綠色線(UL1015 18AWG 600V單股多蕊線)，在ESP32端使用15cm，在香蕉接頭端使用10cm，共兩條線。兩者用快速接頭連接。
 
### 2024-08-22
+ 主控制板(ESP32)要折掉側邊。
  
+ 裝上ESP32小板(NODEMCU-32 v1.3 G349)。
  + 參考原廠說明書貼上PIN腳貼紙
  + 燒韌體「SwitchArray_ver2_9」
    
+ 貼上標籤SwitchArray序號SXXX，例如S005。彥廷做的編號為S001~S004。
  + 字體大小:自動，外框:「無」，內容「S005」，1張，貼在主控制板PCB上(貼在兩個螺絲之間，也就是U201,U202之間)。
  + 字體大小:10pt，外框:1/7，內容「S005」，1張，沿著外框剪切，把標籤貼在ESP32小板上(貼在金鐘罩上面)。
  
+ 接上BNC線(BNC公轉杜邦母30cm，BNC-MDP-03)。
  + H3的V_ready: 接紅色
  + H3的GND: 接黑色

+ K16防水航空插頭插座(綠色2P)
  + PIN#1焊接處塗紅色，接紅線。
  + PIN#2焊接處塗黑色，接黑線。
