cgrgncu/SwitchArray_info/ERT_v2.9.9_軟體.md

### ERT v2.9.9

### 軟體名稱
+ ERT basic

### 軟體圖示(運行ICON)
+ 不要用R3，選用其他圖片。

### 開機紀錄
+ 成功 or 失敗 -> 10次 -> 系統時間存*.log

### cal頁面
+ UI移除
+ 檔案內數值全部用10

### Electrode Array頁面
+ 下拉選單只留下「None」、「Gradient...」

### Scan Setting頁面
+ 移除不要用的功能

### Timer頁面
+ 增加提示文字: 修改本頁內容將立刻儲存在設定檔中

### Reflesh按鈕
+ 移除

### Scan頁面
+ Auto Plot Current移除

### Data Modify頁面
+ 移除說明圖片
+ 修改頁面名稱為Data Convert

# 20240416釋出
+ 軟體名稱:ERT_ver2_9_9_Client.exe
+ 作者: TingoYeh
+ 版本: ver2_9_9
+ 釋出時間: 2024-04-16

### HsiupoYeh 2024-04-16測試:
1. 軟體使用上會有諸多不便，須小心。
2. 只在Windows10上測試過，需安裝Labview runtimes。
3. 需要在約30內選好DMM、ESP32、PSU的COM資訊，否則會當作錯誤操作而關閉主程式。設定成功才能用Start按鈕，按Start按鈕才會存設定檔(setting.txt)。
4. 待正常設定各項COM資訊後，存檔路徑若無效就跳過log存檔功能，如果有路徑就會存log檔案。可手動先查看設定檔(setting.txt)內的存檔路徑。
5. 注意，設定檔(setting.txt)與ver2.9.7略有不同，請重新用當下軟體調整設定後存檔。
6. Start按鈕按下後會重新寫入data_temp.csv，請注意不要同時操作該檔案。等運作完成後才會一次存到以起始時間命名的檔案中。但是因為檔案描述到分鐘，因此同一分鐘的檔案會被後者取代。
7. 自動運作(Timer)的功能，要在無連續操作下才會進行，例如:放電中、檢測電阻中不會觸發。觸發條件描述只到分鐘，實際上只有該分鐘00秒觸發。
8. 視窗名稱有.vi
9. 存檔路徑顯示字元有上限...但功能應該是正常的(?
10. 如果放電檔案Current Mode.csv不存在，或者是編輯出很奇怪的檔案，有機會造成ESP32不回應...
