cgrgncu/SwitchArray_info/production/Survey_Item_List.md

# 基本調查用品清單

# 主機
+ SwitchArray 兩台，一台備用。都要有配件包。
+ DMM 一台，檢查USB線材、電源線。
+ PSU 一台，檢查USB線材、電源線。
+ PC 一台，檢查變壓器、電源線。
+ 螢幕 一台，檢查USB線材或hdmi線材。
+ 儲能電池 一台
+ 桌子
+ 纜線(主纜線以及一分八)
+ 電極棒
+ 鐵鎚
+ 皮尺
+ 類比電表
+ 數位電表
+ 螺絲起子工具
+ 絕緣膠帶
+ 蘋果膠帶
+
