cgrgncu/SwitchArray_info/production/README.md

# R2MS Lite 生產紀錄

### PSU(9185B)
+ 5台優惠價格: 278,250

### DMM(34465A)
+ 63,798 x4 = 255,192

### PC(NUC i7)
+ 主機
  + 20,000 x10 = 200,000
+ 外接螢幕:
  + 3,000 x1 = 3,000
+ 集線器:
  + 199 x6 = 1194
+ USBDISK32GB
  + 20入組 = 2,297

### SwitchArray
+ 箱體
  + 第一個: 28,350(含稅)
  + 之後每個: 18,000(未稅)
+ AB30S-C
  + 25 x500 = 12,500(未稅)
+ LT930
  + 70 x500 = 35,000(未稅)
+ 10歐姆模擬地層電路板
  + 含運含關稅依時價 = 2,650
+ Phoenix Contact 1873265
  + 100入 = 38,239
+ Phoenix Contact 1825569
  + 100入 = 26,815
+ 預估需求費用每台: 60,000
  + 箱體: 20,000
  + 主控板(ESP32): 2,000
  + AD板每片不含人工: 500 + (25+70) x16 = 500 + 1,520 = 2,020
    + 考慮良率應製作10片 = 20,200
  + 人工每台: 20000

### NAS(DS224+) + UPS
+ 32,390 x2 = 64,780

### 小計
|項目 |說明 |金額|
|---|---|---|
|PSU(9185B) |5台優惠價格: 278,250 |278,250|
|DMM(34465A) |63,798 x4 = 255,192 |255,192|
|PC(NUC i7) |20,000 x10 = 200,000 |200,000|
|外接螢幕: |3,000 x1 = 3,000 |3,000  |
|集線器: |199 x6 = 1,194 |1,194  |
|USBDISK32GB |20入組 = 2,297 |2,297  |
|SwitchArray |28,350(含稅) x1 |28,350 |
|AB30S-C |25 x500 = 12,500(未稅)  |12,500 |
|LT930 |70 x500 = 35,000(未稅)  |35,000 |
|10歐姆模擬地層電路板 |含運含關稅依時價 = 2,650 |2,650  |
|Phoenix Contact 1873265|100入 = 38,239 |38,239 |
|Phoenix Contact 1825569|100入 = 26,815 |26,815 |
|NAS(DS224+) + UPS |32,390 x2 = 64,780 |64,780 |
|小計 | |948,267 |
