cgrgncu/SwitchArray_info/production/PSU(9185B)/README.md

# PSU(9185B) 
+ 特色: 600V/0.35A,400V/0.5A
+ 所有儀器清單:
  + 508I23118 (2024-04-15建立ERT監測站，小油坑景觀平台站，沒有採購紀錄)
  + 508F24126 (葉秀柏借用)
  + 508F24128 (在實驗室)
  + 508F24129 (在實驗室)
  + 508F24130 (在實驗室)
  + 508F24133 (在實驗室)
  + 508F25105 (在實驗室)

## 2024採購紀錄
+ 財產單據: 11309A3070
+ 財產編號:
  + 3100502-54-01024
  + 3100502-54-01025
  + 3100502-54-01026
  + 3100502-54-01027
  + 3100502-54-01028
+ 驗收日期: 2024-08-26。
+ 保固期限: 驗收合格日起三年。

### PSU(9185B) 3100502-54-01024 508F24126
+ 財產單據: 11309A3070
+ 財產編號: 3100502-54-01024
+ 儀器序號: 508F24126
+ 產品名稱: 台灣百科 單通道可程式直流電源供應器

### PSU(9185B) 3100502-54-01025 508F24128
+ 財產單據: 11309A3070
+ 財產編號: 3100502-54-01025
+ 儀器序號: 508F24128
+ 產品名稱: 台灣百科 單通道可程式直流電源供應器

### PSU(9185B) 3100502-54-01026 508F24129
+ 財產單據: 11309A3070
+ 財產編號: 3100502-54-01026
+ 儀器序號: 508F24129
+ 產品名稱: 台灣百科 單通道可程式直流電源供應器
+ 台灣標達公司帶走使用於TSMC。SwitchArray(2025-S005)搭配PSU(508F24129)、DMM(MY60078728)、PC(R2MS_Lite_S004)。

### PSU(9185B) 3100502-54-01027 508F24130
+ 財產單據: 11309A3070
+ 財產編號: 3100502-54-01027
+ 儀器序號: 508F24130
+ 產品名稱: 台灣百科 單通道可程式直流電源供應器

### PSU(9185B) 3100502-54-01028 508F24133
+ 財產單據: 11309A3070
+ 財產編號: 3100502-54-01028
+ 儀器序號: 508F24133
+ 產品名稱: 台灣百科 單通道可程式直流電源供應器

## 2025

### PSU(9185B) 工研院 508F25105
+ 財產單據: 工研院
+ 財產編號: 工研院
+ 儀器序號: 508F25105
+ 產品名稱: 台灣百科 單通道可程式直流電源供應器
