cgrgncu/SwitchArray_info/production/DMM(34465A)/README.md

# DMM(34465A)
+ 所有儀器清單:
  + MY59004074 (2024-09-03從農田撤回，舊款灰色外殼，功能應該相同，沒有採購紀錄)
  + MY60077634 (2024-04-15建立ERT監測站，小油坑景觀平台站，沒有採購紀錄)
  + MY60090449 (葉秀柏借用，2024-01-18購買，沒有採購紀錄)
  + MY60076563 (在實驗室)
  + MY60078728 (在實驗室)
  + MY60681084 (在實驗室)
  + MY64001649 (在實驗室)
  + MY64004458 (在實驗室)

## 2024採購紀錄
+ 財產單據:11310A3127
+ 財產編號:
  + 3100503-78-00279
  + 3100503-78-00280
  + 3100503-78-00281
  + 3100503-78-00282
+ 驗收日期: 2024-09-03。
+ 保固期限: 驗收合格日起三年。

### DMM(34465A) 3100503-78-00279 MY60076563
+ 財產單據: 11310A3127
+ 財產編號: 3100503-78-00279
+ 儀器序號: MY60076563
+ 產品名稱: Digital multimeter 34465A

### DMM(34465A) 3100503-78-00280 MY60078728
+ 財產單據: 11310A3127
+ 財產編號: 3100503-78-00280
+ 儀器序號: MY60078728
+ 產品名稱: Digital multimeter 34465A
+ 台灣標達公司帶走使用於TSMC。SwitchArray(2025-S005)搭配PSU(508F24129)、DMM(MY60078728)、PC(R2MS_Lite_S004)。
  
### DMM(34465A) 3100503-78-00281 MY60681084
+ 財產單據: 11310A3127
+ 財產編號: 3100503-78-00281
+ 儀器序號: MY60681084
+ 產品名稱: Digital multimeter 34465A
  
### DMM(34465A) 3100503-78-00282 MY64001649
+ 財產單據: 11310A3127
+ 財產編號: 3100503-78-00282
+ 儀器序號: MY64001649
+ 產品名稱: Digital multimeter 34465A

## 2025

### DMM(34465A) 工研院 MY64004458
+ 財產單據: 工研院
+ 財產編號: 工研院
+ 儀器序號: MY64004458
+ 產品名稱: Digital multimeter 34465A
