cgrgncu/SwitchArray_info/production/PC(ASUS_NUC_12PRO)/README.md

# PC(ASUS_NUC_12PRO)
+ 所有儀器清單:

## 2024採購紀錄
+ 財產單據:11309A3071
+ 財產編號:
  + 3140101-03-40091
  + 3140101-03-40092
  + 3140101-03-40093
  + 3140101-03-40094
  + 3140101-03-40095
  + 3140101-03-40096
  + 3140101-03-40097
  + 3140101-03-40098
  + 3140101-03-40099
  + 3140101-03-40100
+ 驗收日期: 2024-08-26。
+ 保固期限: 驗收合格日起三年。

### PC(ASUS_NUC_12PRO) 3140101-03-40091
+ 財產單據: 11309A3071
+ 財產編號: 3140101-03-40091
+ 儀器序號: S4ARAC01F468BEX
+ 產品名稱: ASUS NUC 12PRO
+ MODEL: NUC12WSH
+ MAC Address(LAN1): 48210B61DB36
+ MAC Address(Wifi): 8CE9EEF9F015
