cgrgncu/SwitchArray_info/監測站處理流程/R2MS_Lite_v297_Upload/README.md

# R2MS_Lite_v297_Upload_v20241110a
+ 參數寫在INI中，限制使用ANSI編碼的INI。純英文內文各種編碼都不會發生錯誤。

+ 使用外部程式，但因回應內容是UTF-8編碼，採用把結果存到檔案中再讀取。

+ 要搭配Server端使用。
