cgrgncu/SwitchArray_info/監測站處理流程/R2MS_Lite_API_Server/README.md

# R2MS_Lite_API_Server
+ 作者: HsiupoYeh
+ 更新日期: 2024-10-27
