cgrgncu/SwitchArray_info/硬體_電路板/主控制板(ESP32)/韌體(ESP32)/SwitchArray_ver2_9/Code/README.txt

陽明山監測專用

韌體版本v2_9，軟體版本:ERT_ver2_9_7
需自行確認使用上述版本號。可從ERT_ver2_9_7軟體中察看韌體版本。

115200

2024/04/16起
軟體ERT_ver_2.9.9也通過測試，可使用此版本韌體。
