cgrgncu/SwitchArray_info/監測站處理流程/手動工作清單.md

# 手動工作清單

### 1. 參考存檔說明把檔案歸檔成為zip模式
+ 範例結構: 「[20240409A]Taiwan-Taipei-XiaoYouKengScenicPlatform(XYKP)\Recorder\XP1\2025\05\01\1402.zip」
  + zip內部結構體:
  ```
  Recorder/XP1/2025/05/01/1402/Part01/1/S001202505011402.Current Mode.csv
  Recorder/XP1/2025/05/01/1402/Part01/1/S001202505011402.Project1.ini
  Recorder/XP1/2025/05/01/1402/Part01/1/S001202505011402.setting.txt
  Recorder/XP1/2025/05/01/1402/Part01/1/S001202505011402.v299.csv
  ```

### 現場一次性逆推成果
+ 準備好實際的3天穩定資料XP1: 
  + 固定資料(*.geo): XP1.geo --> 手動自己製作
  + 固定資料(*.trn): XP1.trn --> 手動自己製作，應該參考RTK量測結果。  
  + 第1天資料(*.csv): S001202404152001.v297E.csv
  + 第2天資料(*.csv): S001202404162001.v297E.csv
  + 第3天資料(*.csv): S001202404172001.v297E.csv
  + 固定的假資料(*.csv): empty_A.v297E.csv
  + 固定的假資料(*.csv): empty_B.v297E.csv
  + 固定的假資料(*.csv): empty_C.v297E.csv
+ 準備好實際的3天穩定資料XP2: 
  + 固定資料(*.geo): XP2.geo --> 手動自己製作
  + 固定資料(*.trn): XP2.trn --> 手動自己製作，應該參考RTK量測結果。
  + 第1天資料(*.csv): S002202404152031.v297E.csv
  + 第2天資料(*.csv): S002202404162031.v297E.csv
  + 第3天資料(*.csv): S002202404172031.v297E.csv
  + 固定的假資料(*.csv): empty_A.v297E.csv
  + 固定的假資料(*.csv): empty_B.v297E.csv
  + 固定的假資料(*.csv): empty_C.v297E.csv
+ 將資料整理為下方資料夾結構，以利軟體運作分析:
```
C:\R2MS_ERT_Web_Server\Projects\[20240409A]StableCSV2URF-Taiwan-Taipei-XiaoYouKengScenicPlatform(XYKP)\
  │
  ├─── Recorder\XP1\
  │    ├─── Part01\1\                        % 測線 XP1 - 第 1 天資料 (2024/04/15)
  │    │    ├── empty_A.v297E.csv            % 預留空測檔案 A
  │    │    ├── empty_B.v297E.csv            % 預留空測檔案 B
  │    │    ├── empty_C.v297E.csv            % 預留空測檔案 C
  │    │    ├── S001202404152001.v297E.csv   % 第 1 天實測電阻率原始資料 (S001, 20:01)
  │    │    ├── XP1.geo                      % 電極幾何座標檔案 (手動製作)
  │    │    └── XP1.trn                      % RTK 地形修正檔案 (手動製作)
  │    │
  │    ├─── Part01\2\                        % 測線 XP1 - 第 2 天資料 (2024/04/16)
  │    │    ├── empty_A.v297E.csv
  │    │    ├── empty_B.v297E.csv
  │    │    ├── empty_C.v297E.csv
  │    │    ├── S001202404162001.v297E.csv   % 第 2 天實測電阻率原始資料 (S001, 20:01)
  │    │    ├── XP1.geo
  │    │    └── XP1.trn
  │    │
  │    └─── Part01\3\                        % 測線 XP1 - 第 3 天資料 (2024/04/17)
  │         ├── empty_A.v297E.csv
  │         ├── empty_B.v297E.csv
  │         ├── empty_C.v297E.csv
  │         ├── S001202404172001.v297E.csv   % 第 3 天實測電阻率原始資料 (S001, 20:01)
  │         ├── XP1.geo
  │         └── XP1.trn
  │
  └─── Recorder\XP2\
       ├─── Part01\1\                        % 測線 XP2 - 第 1 天資料 (2024/04/15)
       │    ├── empty_A.v297E.csv
       │    ├── empty_B.v297E.csv
       │    ├── empty_C.v297E.csv
       │    ├── S002202404152031.v297E.csv   % 第 1 天實測電阻率原始資料 (S002, 20:31)
       │    ├── XP1.geo                      % 沿用同觀測站 Baseline 幾何
       │    └── XP1.trn                      % 沿用同觀測站 Baseline 地形
       │
       ├─── Part01\2\                        % 測線 XP2 - 第 2 天資料 (2024/04/16)
       │    ├── empty_A.v297E.csv
       │    ├── empty_B.v297E.csv
       │    ├── empty_C.v297E.csv
       │    ├── S002202404162031.v297E.csv   % 第 2 天實測電阻率原始資料 (S002, 20:31)
       │    ├── XP1.geo
       │    └── XP1.trn
       │
       └─── Part01\3\                        % 測線 XP2 - 第 3 天資料 (2024/04/17)
            ├── empty_A.v297E.csv
            ├── empty_B.v297E.csv
            ├── empty_C.v297E.csv
            ├── S002202404172031.v297E.csv   % 第 3 天實測電阻率原始資料 (S002, 20:31)
            ├── XP1.geo
            └── XP1.trn
```
+ 然後利用「R2MS ERT分析精靈」進行批次分析，可得到URF及相關檔案:
```
C:\R2MS_ERT_Web_Server\Projects\[20240409A]StableCSV2URF-Taiwan-Taipei-XiaoYouKengScenicPlatform(XYKP)\
  │
  └─── Urf\
       ├─── Level0\                                % Level0 原始資料轉換層
       │    ├─── XP1\
       │    │    └─── Part01\
       │    │         ├── XP1_Part01.uqi           % XP1 數據質量與批次查詢索引檔
       │    │         ├─── 1\
       │    │         │    ├── XP1_Part01_1_Level0.urf
       │    │         │    └── XP1_Part01_1_Level0.urflog
       │    │         ├─── 2\
       │    │         │    ├── XP1_Part01_2_Level0.urf
       │    │         │    └── XP1_Part01_2_Level0.urflog
       │    │         └─── 3\
       │    │              ├── XP1_Part01_3_Level0.urf
       │    │              └── XP1_Part01_3_Level0.urflog
       │    │
       │    └─── XP2\
       │         └─── Part01\
       │              ├── XP2_Part01.uqi           % XP2 數據質量與批次查詢索引檔
       │              ├─── 1\
       │              │    ├── XP2_Part01_1_Level0.urf
       │              │    └── XP2_Part01_1_Level0.urflog
       │              ├─── 2\
       │              │    ├── XP2_Part01_2_Level0.urf
       │              │    └── XP2_Part01_2_Level0.urflog
       │              └─── 3\
       │                   ├── XP2_Part01_3_Level0.urf
       │                   └── XP2_Part01_3_Level0.urflog
       │
       └─── Level1\                                % Level1 濾波與品質控管過濾層
            ├─── XP1\
            │    ├── XP1_S3_R4_B50000_Level1.urf  % XP1 篩選後50000筆3次平均URF檔，一次性調查可以採用進行後續逆推，這個比較穩健。
            │    └─── Part01\
            │         ├─── 1\
            │         │    ├── XP1_Part01_1_Level1.urf % XP1 篩選後50000筆第1天URF檔(2024/04/16)。監測就是只選用當天的URF進行後續逆推。
            │         │    └── XP1_Part01_1_Level1.urflog
            │         ├─── 2\
            │         │    ├── XP1_Part01_2_Level1.urf % XP1 篩選後50000筆第2天URF檔(2024/04/17)。監測就是只選用當天的URF進行後續逆推。
            │         │    └── XP1_Part01_2_Level1.urflog
            │         └─── 3\
            │              ├── XP1_Part01_3_Level1.urf % XP1 篩選後50000筆第3天URF檔(2024/04/18)。監測就是只選用當天的URF進行後續逆推。
            │              └── XP1_Part01_3_Level1.urflog
            │
            └─── XP2\
                 ├── XP2_S3_R4_B50000_Level1.urf  % XP2 篩選後50000筆3次平均URF檔，一次性調查可以採用進行後續逆推，這個比較穩健。
                 └─── Part01\
                      ├─── 1\
                      │    ├── XP2_Part01_1_Level1.urf % XP2 篩選後50000筆第1天URF檔(2024/04/16)。監測就是只選用當天的URF進行後續逆推。
                      │    └── XP2_Part01_1_Level1.urflog
                      ├─── 2\
                      │    ├── XP2_Part01_2_Level1.urf % XP2 篩選後50000筆第2天URF檔(2024/04/17)。監測就是只選用當天的URF進行後續逆推。
                      │    └── XP2_Part01_2_Level1.urflog
                      └─── 3\
                           ├── XP2_Part01_3_Level1.urf % XP2 篩選後50000筆第3天URF檔(2024/04/18)。監測就是只選用當天的URF進行後續逆推。
                           └── XP2_Part01_3_Level1.urflog
```
+ 至此，可以拿平均URF檔案作為一次性調查使用。但這裡針對長期監測，故只需要保留「XP1_Part01.uqi」、「XP2_Part01.uqi」，然後另外重新用腳本跑CSV2URF，就可以跳脫分析精靈。
+
