cgrgncu/SwitchArray_info/監測站處理流程/網路通訊規劃.md

# 網路通訊規劃
+ 希望讓整個系統是透過網路通訊來溝通，以利建置網頁服務。
+ 連接埠使用:
  + 避開的清單:
    + https://zh.wikipedia.org/zh-tw/%E9%80%9A%E8%A8%8A%E5%9F%A0
    + https://zh.wikipedia.org/wiki/TCP/UDP%E7%AB%AF%E5%8F%A3%E5%88%97%E8%A1%A8
  + 80
  + 5000
  + 5001
  + 15000: DSM
  + 15001: DSM
  + 18000: ERT分析精靈伺服器版
  + 18001: 逆推大師伺服器版
  + 18002: R2MS_Lite_API_Server
