cgrgncu/SwitchArray_info/監測站處理流程/風險與安全性.md

# R2MS_Lite風險與安全性

### 主機
+ NUC12WSH/i7/500GB/16GB
+ 運作溫度: 0 ~ 50℃，比商規( 0 ~ 70℃)還低。
+ 有風扇，在惡劣環境可能較快損壞。按照使用者經驗，CPU風扇平均壽命推估為3年。
+ 電源:20V/6A(120W)變壓器。
+ 購買時售價約2萬

### 設定與作業系統
+ 因ERT_v2.9.9軟體，需運作在Windows10或以上版本。風險:Windows授權啟用方式較昂貴且麻煩、系統較肥大難以去除多數不必要的功能，常受強制安全性更新影響使用者體驗。
+ 選定中央大學提供SW_DVD9_Win_Pro_10_22H2.19_64BIT_ChnTrad_Pro_Ent_EDU_N_MLF_X23-74684.ISO，安裝企業版。並停止更新，已避免運作期間重開機。風險: 較耗電、需手動進行重大更新。
+ BIOS設定電源規則，維持上次狀態。希望可以緩解異常斷電的重開機問題。風險:
+ 因ERT_v2.9.9軟體，需登入後運作。風險:此時任何能接觸到主機的人均可無限制進行操作。
  + 目前規劃設定只有一個使用者帳戶，無密碼，開機自動登入，不休眠。
  + 棄用Windows內建遠端桌面，設定為關閉。滿足中央大學資安要求。
  + 遠端桌面改用開源軟體Rustdesk，可商用，自架中繼伺服器可有較高的安全性及速度。
    + 其他遠端桌面軟體為備用，例如Google遠端桌面。風險: Google遠端桌面需要登入帳號密碼，Google帳戶不利於交接與維護。

### 預裝軟體
+
