cgrgncu/SwitchArray_info/監測站處理流程/遠端桌面.md

# 免費遠端桌面軟體
+ 微軟內建的遠端桌面軟體 -> 離線或斷線後使用者會自動登出，造成LabView撰寫轉體ERT_ver2_9_7.exe無法透過Windows內建排程工具自動開啟。
+ Google遠端 -> 需要綁定信箱，有時不明原因無法連線。
+ Anydesk遠端 -> 被判定為商用之後會有一些操作不方便(廣告、畫面不清晰、限制連線時間等)。

### 後續對策
+ 經過評估想試試看RustDesk
+ 評估者: HsiupoYeh
+ 最後更新時間: 2024-08-25

### RustDesk
+ 官方網站: https://rustdesk.com/
+ 公司: Purslane Ltd. (位於新加坡)
+ 可選擇免費方案:
  ```
  Free Self-hosting Plan
  $0/month
  Open source and free
  ```
+ Github開源: https://github.com/rustdesk/rustdesk
  + 授權模式: AGPL-3.0，簡單理解成可商用要開源。
  + 免費的方案可以選擇自己架伺服器或用第三方公用伺服器(例如歐盟有人免費提供伺服器)
+ 開發團隊: https://rustdesk.com/team.html
  + 核心團隊成員:
    + 約瑟夫·傑克斯(執行長)
      + Joseph Jacks於2018年創立OSS Capital。在此之前，他協助創辦並經營了第一家Kubernetes 新創公司(Kismatic)，也創立並經營了KubeCon（Kubernetes 社群會議），然後在2016 年CNCF（雲端原生運算基金會）成立時將其捐贈給Linux 基金會。
    + 週華兵(首席技術長)
      + Huabing Zhou 在創立和開發 RustDesk 之前，週華兵在新加坡工作期間在金融 IT 領域累積了超過 12 年的經驗。為專案和業務管理帶來豐富的現實生活經驗。
    + 丹尼爾·蘭姆(社區助理)
      + Daniel Lamb 在 IT 產業擁有 25 年的輝煌職業生涯，積極參與眾多開源項目，擔任各種角色和職責。此外，他還在蘇格蘭建立了一家 IT 服務公司，為全球客戶提供服務。 Daniel 擁有廣泛的專業知識，包括支援、銷售和社區參與，為該計畫帶來了大量的知識和經驗。
