cgrgncu/SwitchArray_info/監測站處理流程/檔案空間規劃.md

# R2MS_Lite儲存空間規劃

### 每次測量的檔案大小(以單次放電為例，例如:05\13\1532\Part01\1\S002202405131532)
+ 「1532」資料夾=18,058,503(Byte)=17,636(KB)=17.23(MB)
  + 「S002202405131532.Current Mode.csv」=135,232(Byte)=133(KB)=0.13(MB)
  + 「S002202405131532.Project1.ini」=2,235(Byte)=2.19(KB)
  + 「S002202405131532.setting.txt」=2,235(Byte)=2.19(KB)
  + 「S002202405131532.v299.csv」=17,917,783(Byte)=17,498(KB)=17.09(MB)
+ 用Windows壓縮1532資料夾為「1532.zip」=3.95 MB (4,148,204 位元組)
+ 用Winrar壓縮1532資料夾為「1532.zip」=3.75 MB (3,941,011 位元組)
+ 用MATLAB2014a壓縮1532資料夾為「1532.zip」=3.86 MB (4,055,454 位元組)
+ 用MATLAB2014b壓縮1532資料夾為「1532.zip」=3.86 MB (4,055,454 位元組)
+ 用Info-ZIP壓縮1532資料夾為「1532.zip」=3.86 MB (4,054,428 位元組)
+ 用NAS壓縮1532資料夾為「1532.zip」=3.15 MB (3,308,739 位元組)
```
所以，原始資料每次量測可能要準備25(MB)的儲存空間。
```

#### 推估監測站NUC可用次數
+ SSD: 500(GB)。實際為464(GB)，安裝必要軟體後，可用空間約為350(GB)=358400(MB)。
  + 358400(MB)/25(MB)=14336(次)
    + 每日2次(12小時1次): 14336(次)/2(次) = 7168(天) ~= 238(月) ~= 19(年)
    + 每日4次(6小時1次): 14336(次)/4(次) = 3584(天) ~= 119(月) ~= 9(年)
    + 每日8次(3小時1次): 14336(次)/8(次) = 1782(天) ~= 59(月) ~= 4.8(年)

### 網路要求:
+ 要傳的單一檔案約為4MB，上傳時間限制60秒。
  + 上傳速度1(Mbps)=0.125(MB/s)=7.5(MB/min)。

### 推估資料中心NUC可用次數
+ SSD: 500(GB)。實際為464(GB)，安裝必要軟體後，可用空間約為350(GB)=358400(MB)。
  + 目前版:
    + 「1532」資料夾=18,058,503(Byte)=17,636(KB)=17.23(MB)
    + 轉「E.csv」=17.9(MB)，電腦一份，虛擬機一份。共約36(MB)
    + CSV2URF，轉出「level0」=5.2(MB)，轉出「level1」=1.43(MB)，電腦一份，虛擬機一份。共約13.5(MB)。
    + 逆推過程資料=520(MB)，電腦一份，虛擬機一份。共約1040(MB)。
    + 逆推結果資料=10.8(MB)。電腦一份，虛擬機一份。共約21.6(MB
  + 目前版可用次數:
    + 保留逆推過程: 每次會增加17.23+36+13.5+1040+21.6=1128.33(MB)
      + 358400(MB)/1129(MB)=317(次)
        + 每日2次(12小時1次): 317(次)/2(次) = 158(天) ~= 5.2(月) 
        + 每日4次(6小時1次): 317(次)/4(次) = 79(天) ~= 2.6(月) 
        + 每日8次(3小時1次): 317(次)/8(次) = 39(天) ~= 1.3(月)
    + 不保留逆推過程: 每次會增加17.23+36+13.5+21.6=88.33(MB)
      + 358400(MB)/89(MB)=4026(次)
        + 每日2次(12小時1次): 4026(次)/2(次) = 2013(天) ~= 67(月) ~= 5.5(年)
        + 每日4次(6小時1次): 4026(次)/4(次) = 1006(天) ~= 33(月) ~= 2.7(年)
        + 每日8次(3小時1次): 4026(次)/8(次) = 503(天) ~= 16(月) ~= 1.3(年)
  + 規劃設計:
    + 壓縮部分檔案，壓縮對文字檔效果佳，最高可節省約70%空間。選用通用性高的zip而非追求極致壓縮比。
    + 用NAS保存資料，選用硬碟容量使單站可儲存10年以上。
    + 逆推過程之相關檔案太大，只允許保留數月至一年。
