cgrgncu/SwitchArray_info/監測站處理流程/分析目標中英文定義.md

# 中英文定義

### Water saturation,Sw(孔隙水飽和度)
+ 最早可從阿奇定律中來估算這個值。Sw。
