cgrgncu/SwitchArray_info/production/SwitchArray/RelayBoard_List.md

# Relayboard 清單

### 空接測量方法
+ 不裝機，使用韌體「SwitchArray_ver2_9」。使用標準放電測試。
+ 一次只裝一片，空接看前8個頻道的電流。觀察範圍是-0.0004~0.0004A。範圍內就算通過。
  + CH0(黑): 下、平到底。
  + CH1(藍): 下、上、下、平到底。
  + CH2(綠): 上、下、上、下、平到底。
  + CH3(桃): 上、下、上、下、平到底。
  + CH4(紫): 上、下、上、下、平到底。
  + CH5(靛): 上、下、下、平到底。
  + CH6(黃): 上、下、下、平到底。
  + CH7(墨綠): 上、下、下、平到底。

### 測試地層量測方法1(無接地)
+ 不裝機，使用韌體「SwitchArray_ver2_9」。使用標準放電測試。
+ 一次只裝一片，接10歐姆地層但不接地看前8個頻道的電流。觀察範圍是-0.11~0.11A。範圍內就算通過。

### 測試地層量測方法1(有接地)
+ 不裝機，使用韌體「SwitchArray_ver2_9」。使用標準放電測試。
+ 一次只裝一片，接10歐姆地層但有接地看前8個頻道的電流。觀察範圍是-0.11~0.11A。範圍內就算通過。
+ 看電壓6次上下。數值為1V。

## 2025
### 2025001-2025009
+ 2025100001: 空接正常。目前安裝位置:無。
  + 2026-11-12:
    + 空接測試通過
    + 測試地層量測方法1(有接地)通過。
    + (1)單片空接檢測(DMM正常接)通過。
    + (2)單片空接檢測(DMM用PSU線接)通過。
    + (3)單片短路檢測(DMM正接PSU正，DMM負接短路)通過。
    + (4)單片短路檢測(DMM正接PSU負，DMM負接短路)通過。
+ 2025100002: 空接正常。目前安裝位置:無。
  + 2026-11-12:
    + 空接測試通過
    + 測試地層量測方法1(有接地)通過。
    + (1)單片空接檢測(DMM正常接)通過。
    + (2)單片空接檢測(DMM用PSU線接)通過。
    + (3)單片短路檢測(DMM正接PSU正，DMM負接短路)通過。
    + (4)單片短路檢測(DMM正接PSU負，DMM負接短路)通過。
+ 2025100003: 空接正常。目前安裝位置:無。
  + 2026-11-13:
    + 空接測試通過
    + 測試地層量測方法1(有接地)通過。
    + (1)單片空接檢測(DMM正常接)通過。
    + (2)單片空接檢測(DMM用PSU線接)通過。
    + (3)單片短路檢測(DMM正接PSU正，DMM負接短路)通過。
    + (4)單片短路檢測(DMM正接PSU負，DMM負接短路)通過。
+ 2025100004: 空接正常。目前安裝位置:無。
  + 2026-11-13:
    + 空接測試通過
    + 測試地層量測方法1(有接地)通過。
    + (1)單片空接檢測(DMM正常接)通過。
    + (2)單片空接檢測(DMM用PSU線接)通過。
    + (3)單片短路檢測(DMM正接PSU正，DMM負接短路)通過。
    + (4)單片短路檢測(DMM正接PSU負，DMM負接短路)通過。
  + 曾安裝S008_CH02。疑似CH9 10 12 13電流過大。更換為2025100058。
+ 2025100005: 空接正常。目前安裝位置:無。
  + 2026-11-13:
    + 空接測試通過
    + 測試地層量測方法1(有接地)通過。
    + (1)單片空接檢測(DMM正常接)通過。
    + (2)單片空接檢測(DMM用PSU線接)通過。
    + (3)單片短路檢測(DMM正接PSU正，DMM負接短路)通過。
    + (4)單片短路檢測(DMM正接PSU負，DMM負接短路)通過。
+ 2025100006: 空接正常。目前安裝位置:無。
  + 2026-11-13:
    + 空接測試通過
    + 測試地層量測方法1(有接地)通過。
    + (1)單片空接檢測(DMM正常接)通過。
    + (2)單片空接檢測(DMM用PSU線接)通過。
    + (3)單片短路檢測(DMM正接PSU正，DMM負接短路)通過。
    + (4)單片短路檢測(DMM正接PSU負，DMM負接短路)通過。
+ 2025100007: 空接異常。U1、U2供電電壓很奇怪，繼電器沒有動，換一個新的也沒有改善。
+ 2025100008: 空接正常。目前安裝位置:無。
  + 2026-11-13:
    + 空接測試通過
    + 測試地層量測方法1(有接地)通過。
    + (1)單片空接檢測(DMM正常接)通過。
    + (2)單片空接檢測(DMM用PSU線接)通過。
    + (3)單片短路檢測(DMM正接PSU正，DMM負接短路)通過。
    + (4)單片短路檢測(DMM正接PSU負，DMM負接短路)通過。
+ 2025100009: 空接正常。目前安裝位置:無。
  + 2026-11-13:
    + 空接測試通過
    + 測試地層量測方法1(有接地)通過。
    + (1)單片空接檢測(DMM正常接)通過。
    + (2)單片空接檢測(DMM用PSU線接)通過。
    + (3)單片短路檢測(DMM正接PSU正，DMM負接短路)通過。
    + (4)單片短路檢測(DMM正接PSU負，DMM負接短路)通過。
+ 2025100009: 空接正常。
### 2025010-2025019
+ 2025100010: 空接正常。
+ 2025100011: 空接異常。
+ 2025100012: 空接異常。
+ 2025100013: 空接正常。
+ 2025100014: 空接異常。
+ 2025100015: 空接異常。
+ 2025100016: 空接正常。
+ 2025100017: 空接正常。
+ 2025100018: 空接異常。
+ 2025100019: 空接正常。S009_CH01。
### 2025020-2025029
+ 2025100020: 空接正常。S009_CH02。
+ 2025100021: 空接異常。
+ 2025100022: 空接異常。
+ 2025100023: 空接異常。
+ 2025100024: 空接正常。S009_CH03。
+ 2025100025: 空接異常。目前安裝位置:借給學生。
+ 2025100026: 空接正常。S009_CH04。疑似CH25 31 32電流過大。更換為2025100059。
+ 2025100027: 空接正常。S009_CH05。疑似CH36電流過大。更換為2025100061。
+ 2025100028: 空接正常。S009_CH06。疑似CH45電流過大。更換為2025100063。
+ 2025100029: 空接異常。
### 2025030-2025039
+ 2025100030: 正常。目前安裝位置:無。
  + 2026-10-06:
    + 空接測試通過。
    + 測試地層量測方法1(有接地)通過。
    + (1)單片空接檢測(DMM正常接)通過。
    + (2)單片空接檢測(DMM用PSU線接)通過。
    + (3)單片短路檢測(DMM正接PSU正，DMM負接短路)通過。
    + (4)單片短路檢測(DMM正接PSU負，DMM負接短路)通過。
  + 2026-10-21:
    + 草坪放電(S007202610211253.v299S.csv): 異常
    ```
    BOARD	通道	AVG(CH)	AVG(Rx)	AVG(CH/Rx)	有效筆數
    01	CH01	0.003660873	0.123116021	1.079982235	252
    01	CH02	0.003262869	0.123116021	1.071718322	240
    01	CH03	0.010683195	0.123116021	3.038650405	240 異常
    01	CH04	0.004610664	0.123116021	1.073887211	252
    01	CH05	0.004666729	0.123116021	1.201168017	240 異常
    01	CH06	0.004945629	0.123116021	1.039066048	240
    01	CH07	0.005134667	0.123116021	1.070616863	252
    01	CH08	0.005014038	0.123116021	1.056227454	240
    ```
+ 2025100031: 正常。目前安裝位置:無。
  + 2026-10-06:
    + 空接測試通過。
    + 測試地層量測方法1(有接地)通過。
    + (1)單片空接檢測(DMM正常接)通過。
    + (2)單片空接檢測(DMM用PSU線接)通過。
    + (3)單片短路檢測(DMM正接PSU正，DMM負接短路)通過。
    + (4)單片短路檢測(DMM正接PSU負，DMM負接短路)通過。
  + 草坪放電(S007202610211253.v299S.csv): 異常
    ```
    BOARD	通道	AVG(CH)	AVG(Rx)	AVG(CH/Rx)	有效筆數
    02	CH09	0.007529702	0.123116021	1.464196007	240 異常
    02	CH10	0.013879095	0.123116021	3.382750324	252 異常
    02	CH11	0.005601095	0.123116021	1.146315552	240
    02	CH12	0.006798771	0.123116021	1.636396940	240 異常
    02	CH13	0.004668541	0.123116021	1.067187092	252
    02	CH14	0.004216985	0.123116021	1.035029837	240
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
    + (4)單片短路檢測(DMM正接PSU負，DMM負接短路)通過。
### 2025100
+ 2025100100: 空接正常。目前安裝位置:無。
  + 2026-10-27:
    + 空接測試通過
    + 測試地層量測方法1(有接地)通過。
    + (1)單片空接檢測(DMM正常接)通過。
    + (2)單片空接檢測(DMM用PSU線接)通過。
    + (3)單片短路檢測(DMM正接PSU正，DMM負接短路)通過。
    + (4)單片短路檢測(DMM正接PSU負，DMM負接短路)通過。
