cgrgncu/SwitchArray_info/production/DMM(34465A)/韌體更新.md

# DMM(34465A) 韌體更新
+ 作者: HsiupoYeh
+ 更新日期: 2025-09-22

### R2MS_Lite選擇之34465A韌體版本
+ 2021之後出貨的DMM(34465A)預裝韌體版本: A.03.03
+ 需要降級版本到「A.03.01」。
  + 下載頁面:https://www.keysight.com/tw/zh/lib/software-detail/instrument-firmware-software/34460a34461a34465a34470a-firmware-2367633.html
  + 也可從這裡下載。
+ 更新教學影片: https://www.youtube.com/watch?v=tioT84GQqUs
