cgrgncu/SwitchArray_info/production/PSU(9185B)/電源供應器報價單(簽回掃描).pdf

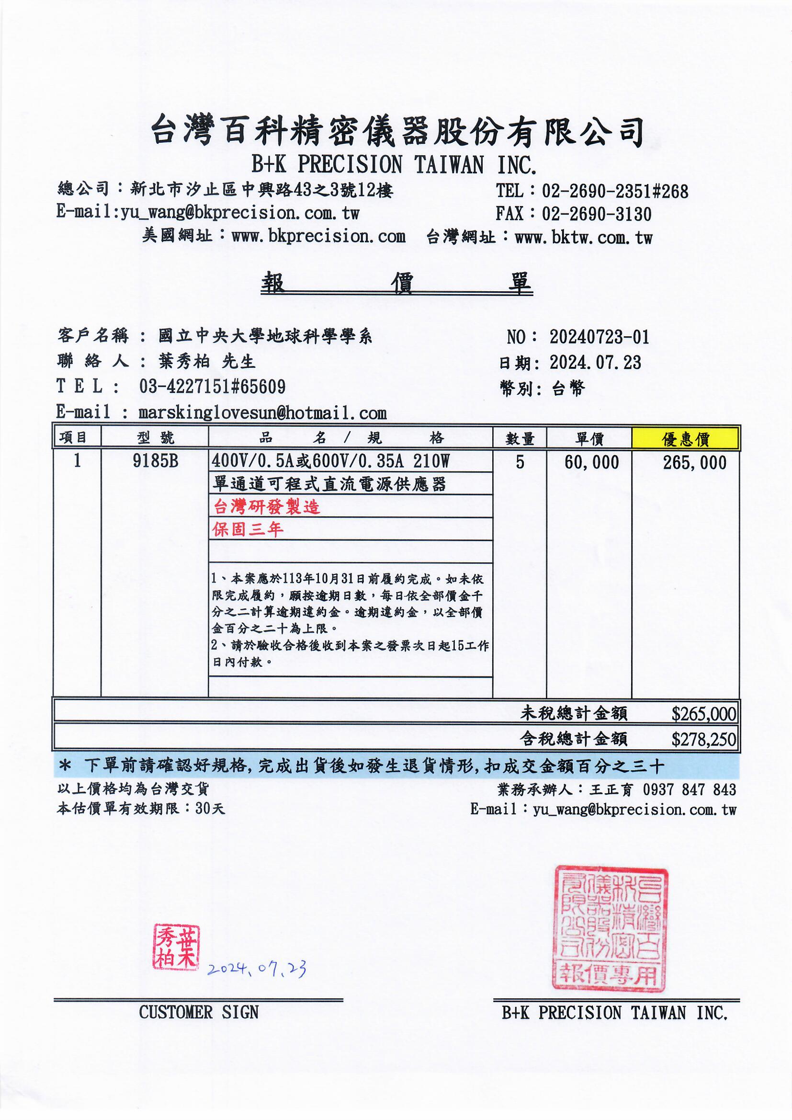
[picture p93: page 1]
