cgrgncu/SwitchArray_info/production/SwitchArray/SwitchArray-2025-S006/工研院R2MS_LITE_S006送貨單(掃描).pdf

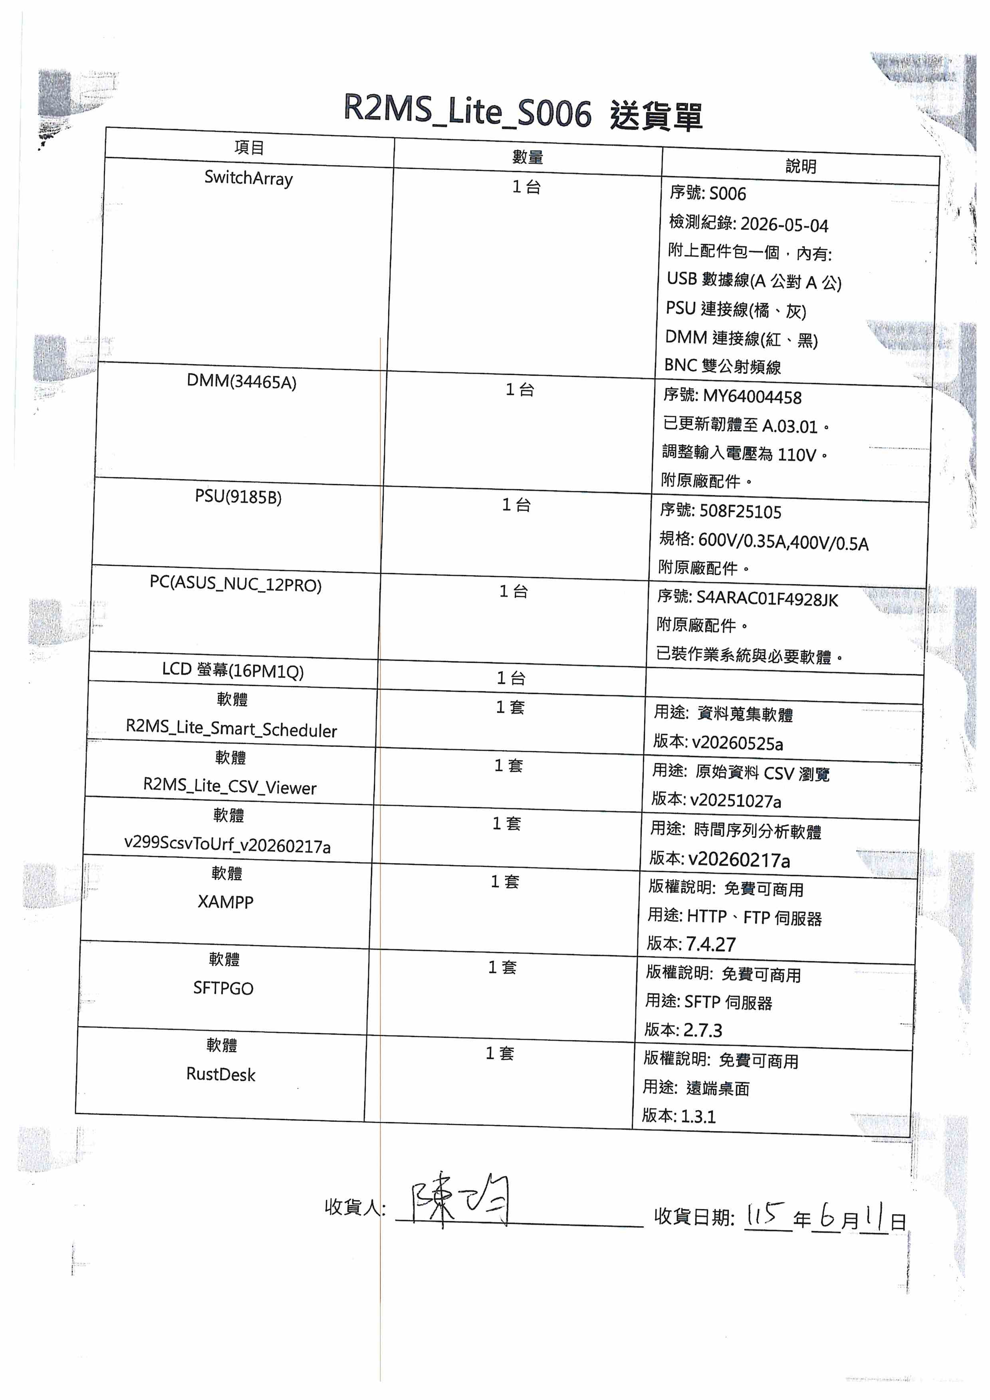
[picture p94: page 1]
