cgrgncu/SwitchArray_info/K16防水航空插頭插座.png

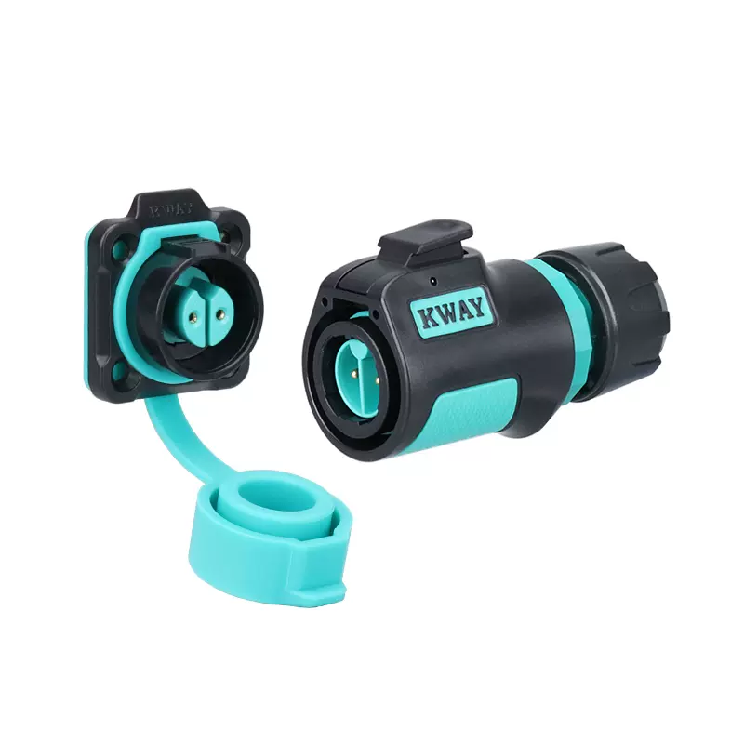
K16防水航空插頭插座.png
