cgrgncu/SwitchArray_info/production/SwitchArray/SwitchArray-2026-S007/20260504/S007202605041630.v299S.MPR_R01_L01_I05_INV3.png

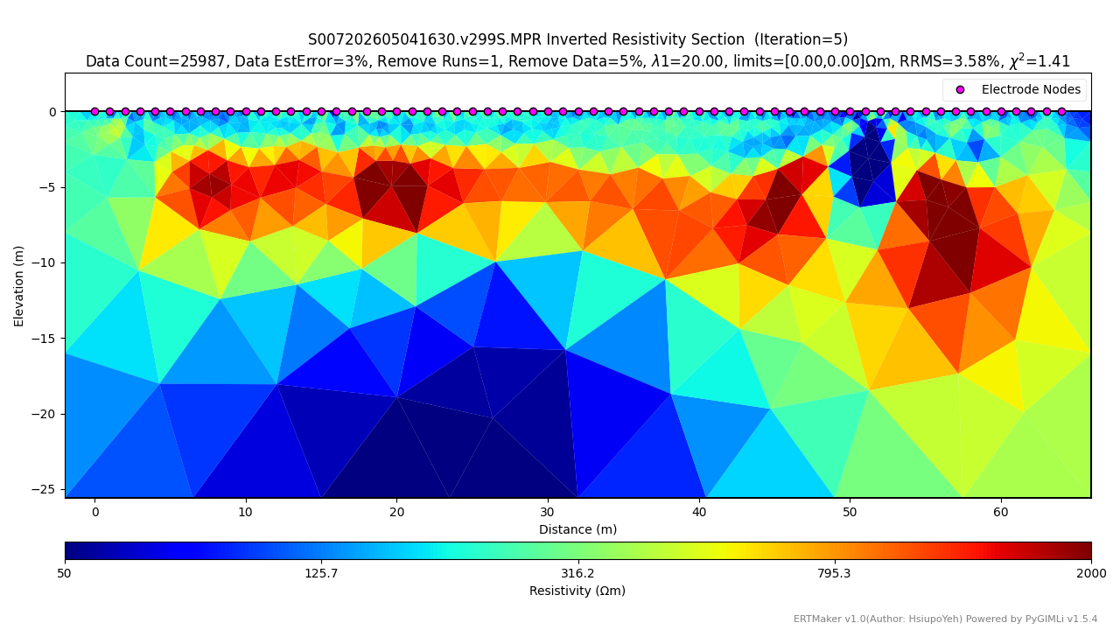
production/SwitchArray/SwitchArray-2026-S007/20260504/S007202605041630.v299S.MPR_R01_L01_I05_INV3.png
