cgrgncu/SwitchArray_info/production/SwitchArray/SwitchArray-2026-S009/20261028/S009202610281545_Floating2.png

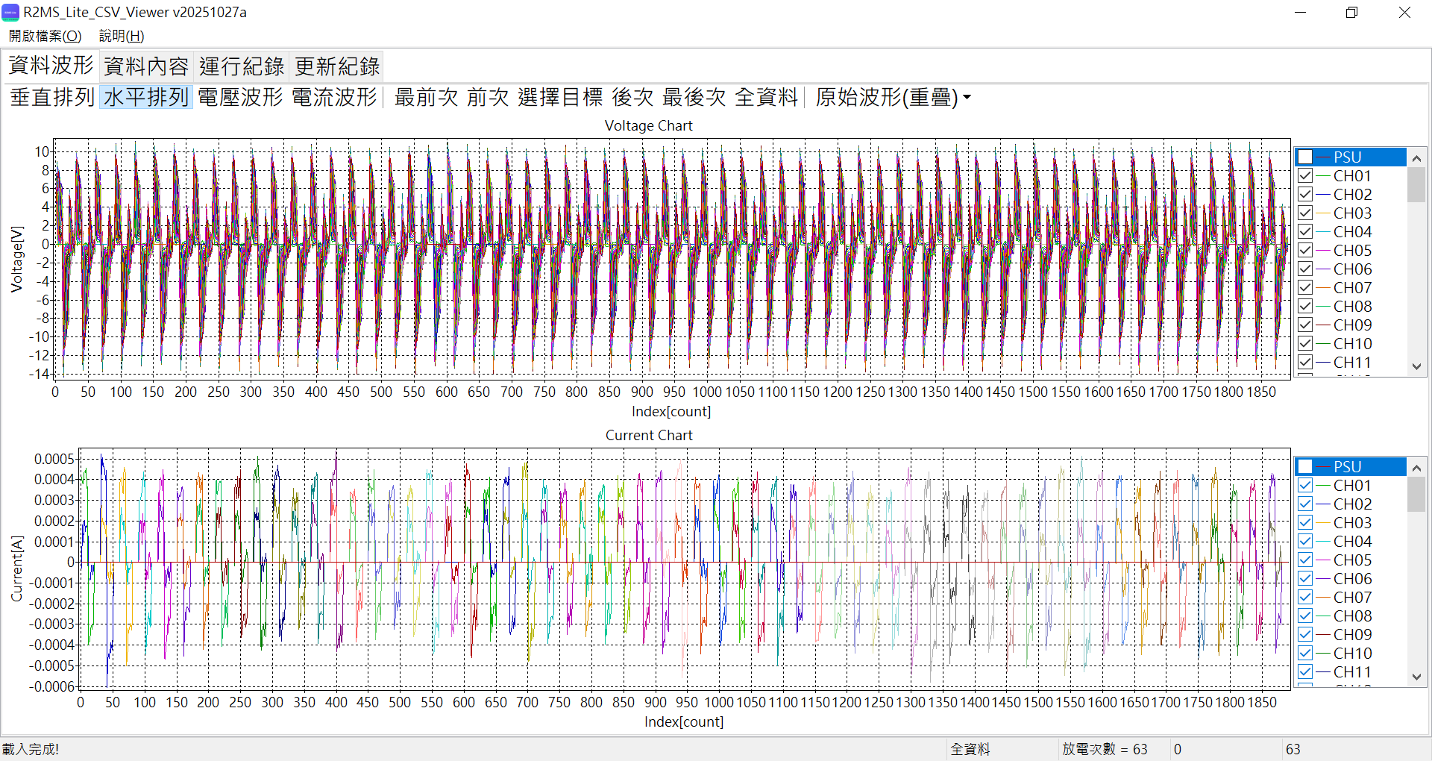
production/SwitchArray/SwitchArray-2026-S009/20261028/S009202610281545_Floating2.png
