cgrgncu/SwitchArray_info/安可信 小霸王實驗室聯名款PCB天線贈送腳位貼.png

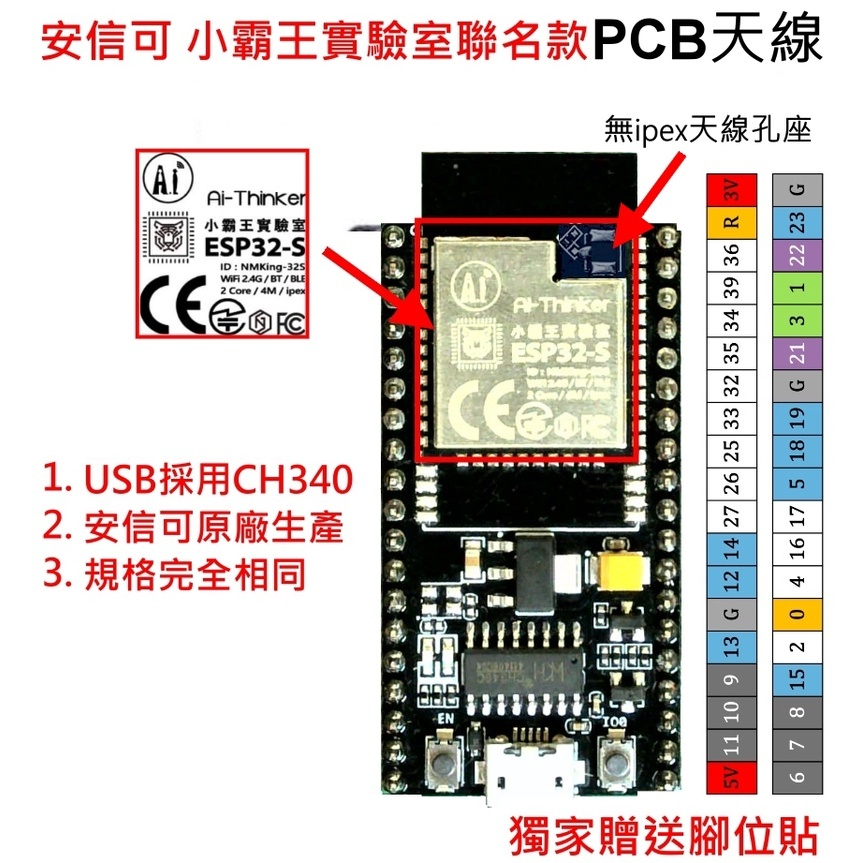
安可信 小霸王實驗室聯名款PCB天線贈送腳位貼.png
