cgrgncu/SwitchArray_info/SwtichArray_BOM.xlsx

@共用項目
編號 | 項目 | 數量 | 單價 | 幣別 | 備註 | 來源
1 | 機殼 | 1 | 800 | CYN |  | https://item.taobao.com/item.htm?spm=a1z09.2.0.0.12aa2e8dmm8tFh&id=650716903526&_u=f207c1240h89b1 | 3520
2 | 電源接頭+插孔 | 1 | 18.2 | CYN |  | https://item.taobao.com/item.htm?spm=a1z09.2.0.0.12aa2e8dmm8tFh&id=663162205748&_u=f207c1240h331f | 568.568
3 | USB插孔 | 1 | 22.5 | CYN |  | https://item.taobao.com/item.htm?spm=a1z09.2.0.0.12aa2e8dmm8tFh&id=662371485402&_u=f207c1240h22c0 | 0
4 | HDMI插孔 | 2 | 25.6 | CYN |  | https://item.taobao.com/item.htm?spm=a1z09.2.0.0.12aa2e8dmm8tFh&id=662442461312&_u=f207c1240hef03 | 0
5 | BNC插孔 | 1 | 39 | TWD |  | https://shop.cpu.com.tw/product/39037/info/ | 39
6 | 槍型接頭 | 6 | 130 | TWD | 3紅3黑 | https://shop.cpu.com.tw/product/8617/info/
7 | 香蕉插孔 | 3 | 22 | TWD |  | https://shop.cpu.com.tw/product/8617/info/ | 66
8 | 客製電路-切換版 | 8 | 10.5 | USD |  | https://jlcpcb.com/ | 2624.16
9 | 客製電路-控制版 | 1 | 9.5 | USD |  | https://jlcpcb.com/ | 296.78
10 | 電子元件 | 1 | 20 | USD |  | https://www.lcsc.com/ | 624.8 | .
11 | nodeMCU_ESP32s | 1 | 249 | TWD |  | https://shopee.tw/(%E6%94%B6%E6%93%9A%E7%99%BC%E7%A5%A8%E5%8F%AF)%E7%AA%84%E7%89%88ESP32%E9%9B%99%E6%A0%B8%E5%BF%83arduino-WIFI%E8%97%8D%E8%8A%BDble%E8%85%B3%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 | 249
12 | BNC線 | 1 | 120 | TWD |  | https://shop.cpu.com.tw/product/68473/info/ | 120
13 | 34465A電錶 | 1 | 63720 | TWD |  | https://www.pinsyun.com.tw/index.html | 63720
14 | 200V 1A 9184B電源供應器 | 1 | 57750 | TWD | 規格不限 | https://www.bktw.com.tw/ | 57750
15 | windows電腦 | 1 | 15000 | TWD | 規格不限 |  | 15000
 |  | 共用項目總價 | 144578.308 | 匯率 | CYN | 4.4
 |  |  |  |  | USD | 31.24
versionA@ 400V 100mA
編號 | 項目 | 數量 | 單價 | 幣別 | 備註 | 來源
15A | AB30S | 260 | 30 | TWD |  | https://www.relay.com.tw/zh-TW/index/index.html | 7800
 |  | 總價 | 152378.308 | 匯率 | CYN | 4.4
 |  |  |  |  | USD | 31.24
versionB@600V 600mA
編號 | 項目 | 數量 | 單價 | 幣別 | 備註 | 來源
15B | LT930 | 128 | 70 | TWD | 交期長 | https://www.letex.com.tw/ | 8960
16B | AM38S | 132 | 35 | TWD | 交期長 | https://www.relay.com.tw/zh-TW/index/index.html | 4620
 |  | 總價 | 158158.308 | 匯率 | CYN | 4.4 | 13580
 |  |  |  |  | USD | 31.24
versionC@1000V 350mA
編號 | 項目 | 數量 | 單價 | 幣別 | 備註 | 來源
15C | AA52F | 260 | 380 | TWD | 交頎長 | https://www.letex.com.tw/ | 98800
 |  |  |  |  | 交期長
 |  | 總價 | 243378.308 | 匯率 | CYN | 4.4 | 98800
 |  |  |  |  | USD | 31.24
versionD@600V 1A (DC Only)
編號 | 項目 | 數量 | 單價 | 幣別 | 備註 | 來源
15D | G3VM-601FR | 128 | 438 | TWD |  | https://www.letex.com.tw/ | 56064
16D | AM38S | 132 | 35 | TWD | 交期長 | https://www.relay.com.tw/zh-TW/index/index.html | 4620
 |  | 總價 | 205262.308 | 匯率 | CYN | 4.4 | 60684
 |  |  |  |  | USD | 31.24
