cgrgncu/SwitchArray_info/硬體_電路板/主控制板(ESP32)/線路圖(或Gerber)/BOM_ERT3_control-board_ver2_2024-04-16.csv

ID | Name | Designator | Footprint | Quantity | Manufacturer Part | Manufacturer | Supplier | Supplier Part | Price
1 | DZ254W-11-03-65 | H3 | HDR-TH_3P-P2.54-H-M-W10.0 | 1 | DZ254W-11-03-65 | DEALON(德艺隆) | LCSC | C2935928 | 0.021
2 | 2.54-1*4P反弯排针 | H6 | HDR-TH_4P-P2.54-H-M-W10.4 | 1 | 2.54-1*4P反弯排针 | BOOMELE(博穆精密) | LCSC | C91552 | 0.021
3 | 300 | R31 | R0603 | 1 | RC0603FR-07300RL | YAGEO(国巨) | LCSC | C114617 | 0.001
4 | 2.54-1*19P母 | H1,H2 | HDR-TH_19P-P2.54-V-F | 2 | 2.54-1*19P母 | BOOMELE(博穆精密) | LCSC | C319202 | 0.11
5 | T34069 | U201,U202 | XFCN_PKT-TH_4P-T34069 | 2 | T34069 | XFCN(兴飞) | LCSC | C481452 | 0.102
6 | DBT50G-9.5-5P | U100 | CONN-TH_5P-P9.50_DBT50G-9.5-5P | 1 | DBT50G-9.5-5P | DIBO(地博电气) | LCSC | C395961 | 0.485
7 | X6521WVS-2X08H-C60D74 | H101 | HDR-SMD_16P-P2.54-V-M-R2-C8-S7.4 | 1 | X6521WVS-2x08H-C60D74 | XKB Connectivity(中国星坤) | LCSC | C2884017 | 0.295
8 | AB30S | U1,U2,U3 | AB30S | 3 | ab30s | toward
9 | PM254-2-08-S-8.5 | H100 | HDR-SMD_16P-P2.54-V-F-R2-C8-LS7.1 | 1 | PM254-2-08-S-8.5 | HCTL(华灿天禄) | LCSC | C3975153 | 0.285
