cgrgncu/SwitchArray_info/硬體_電路板/繼電器板(可串接)/線路圖(或Gerber)/BOM_ERT3-rev2_2024-02-26.csv

ID | Name | Designator | Footprint | Quantity | Manufacturer Part | Manufacturer | Supplier | Supplier Part | Price
1 | T34069 | U201,U202 | XFCN_PKT-TH_4P-T34069 | 2 | T34069 | XFCN(兴飞) | LCSC | C481452 | 0.113
2 | 1u | C10 | C0603 | 1
3 | X6521WVS-2X08H-C60D74 | H2 | HDR-SMD_16P-P2.54-V-M-R2-C8-S7.4 | 1 | X6521WVS-2x08H-C60D74 | XKB Connectivity(中国星坤) | LCSC | C2884017 | 0.295
4 | 300 | R31,R38,R37,R36,R35,R34,R33,R32 | R0603 | 8 | RC0603FR-07300RL | YAGEO(国巨) | LCSC | C114617 | 0.001
5 | 0.01u | C1,C2,C3,C4 | C0603 | 4
6 | SN74HC595DR | U101,U102,U103,U104 | SOIC-16_L9.9-W3.9-P1.27-LS6.0-BL | 4 | SN74HC595DR | TI(德州仪器) | LCSC | C10092 | 0.227
7 | WJ2EDGRM-5.08-8P | CN1 | CONN-TH_8P-P5.08_WJ2EDGRM-5.08-8P | 1 | WJ2EDGRM-5.08-8P | KANGNEX(康奈克斯电气) | LCSC | C193972 | 0.216
8 | 200Ω | R1,R2,R3,R4,R5,R6,R7,R8 | R0603 | 8 | 0603WAJ0201T5E | UNI-ROYAL(厚声) | LCSC | C25217 | 0.001
9 | LT930 | U17,U1,U2,U5,U6,U9,U10,U13,U14,U18,U21,U22,U25,U26,U29,U30 | LT930 | 16 | ab30s | toward
10 | PM254-2-08-S-8.5 | H1 | HDR-SMD_16P-P2.54-V-F-R2-C8-LS7.1 | 1 | PM254-2-08-S-8.5 | HCTL(华灿天禄) | LCSC | C3975153 | 0.285
11 | 10Ω | R21,R28,R27,R26,R25,R24,R23,R22 | RES-SMD_L5.8-W2.2 | 8 | MMB02070C1009FB200 | VISHAY(威世) | LCSC | C2075182 | 0.094
12 | AB38S | U3,U4,U7,U8,U11,U12,U15,U16,U19,U20,U23,U24,U27,U28,U31,U32 | AB38S | 16 | ab38s | toward
