cgrgncu/SwitchArray_info/硬體_電路板/繼電器板(可串接)/線路圖(或Gerber)/Schematic_ERT3-rev2_2024-02-15.pdf

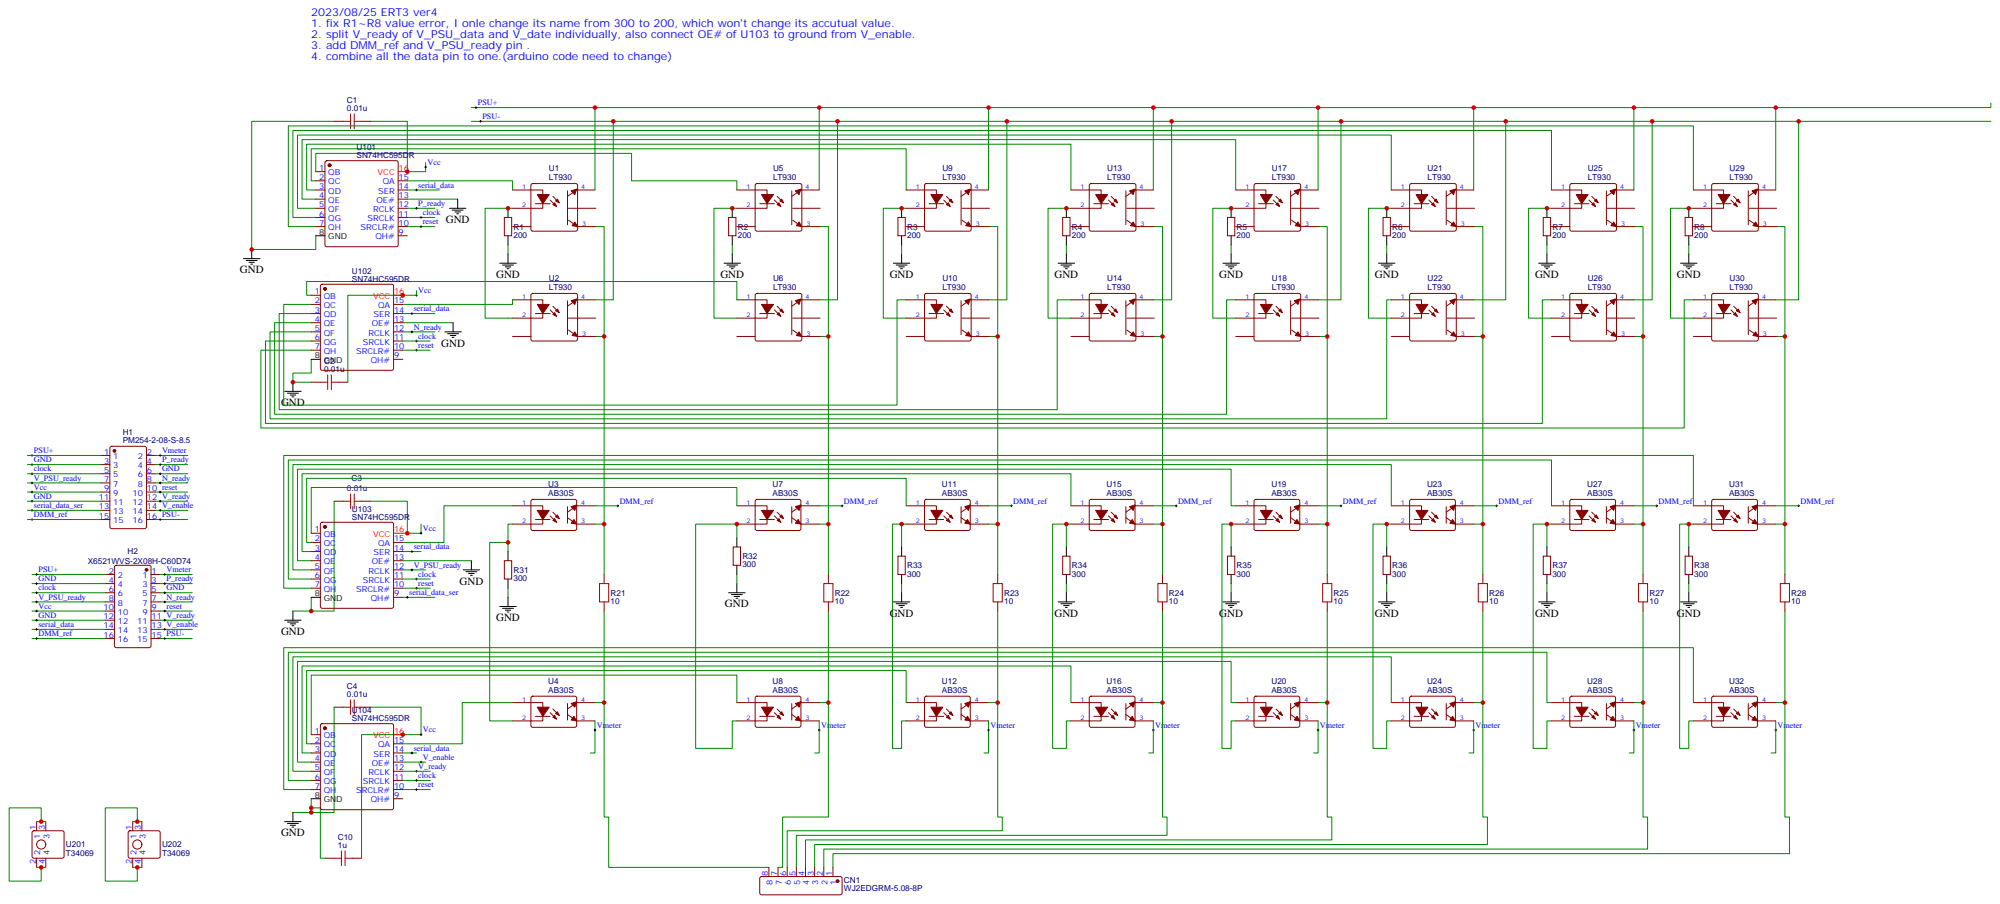
[picture p100: page 1]

2023/08/25 ERT3 ver4
1. fix R1~R8 value error, I onle change its name from 300 to 200, which won't change its accutual value.
2. split V_ready of V_PSU_data and V_date individually, also connect OE# of U103 to ground from V_enable.
3. add DMM_ref and V_PSU_ready pin .
4. combine all the data pin to one.(arduino code need to change)

SRCLR# 10 SRCLK 11 RCLK 12 OE# 13 SER 14 QA 15 VCC 16
