cgrgncu/SwitchArray_info/production/SwitchArray/SwitchArray-2026-S007/20261028/S00720261028_Report.pdf

## 室外檢測完成日期: 2026-10-28

## 室內浮接測試時間序列 PSU:SHOW S007202610281145

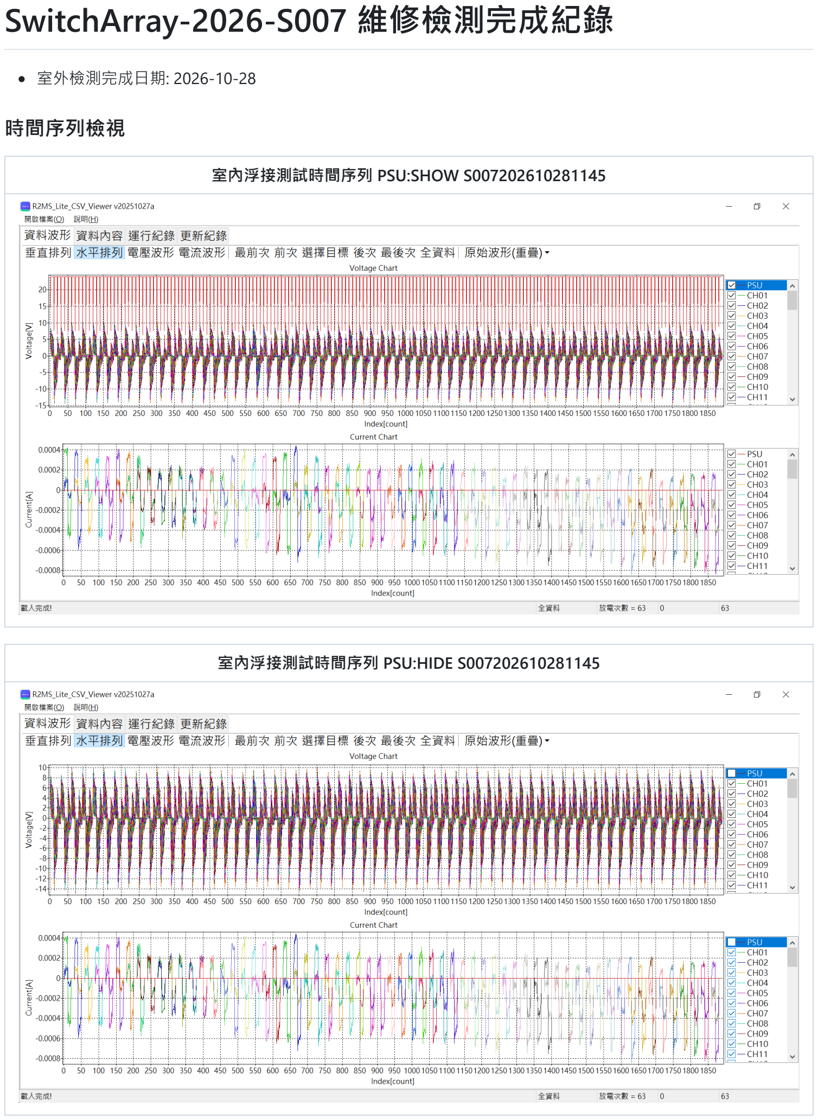
[picture p124: page 1]

## 室內浮接測試時間序列 PSU:HIDE S007202610281145

# SwitchArray-2026-S007 維修檢測完成紀錄

# 時間序列檢視

## 室內標準地層測試時間序列 PSU:SHOW S007202610281153

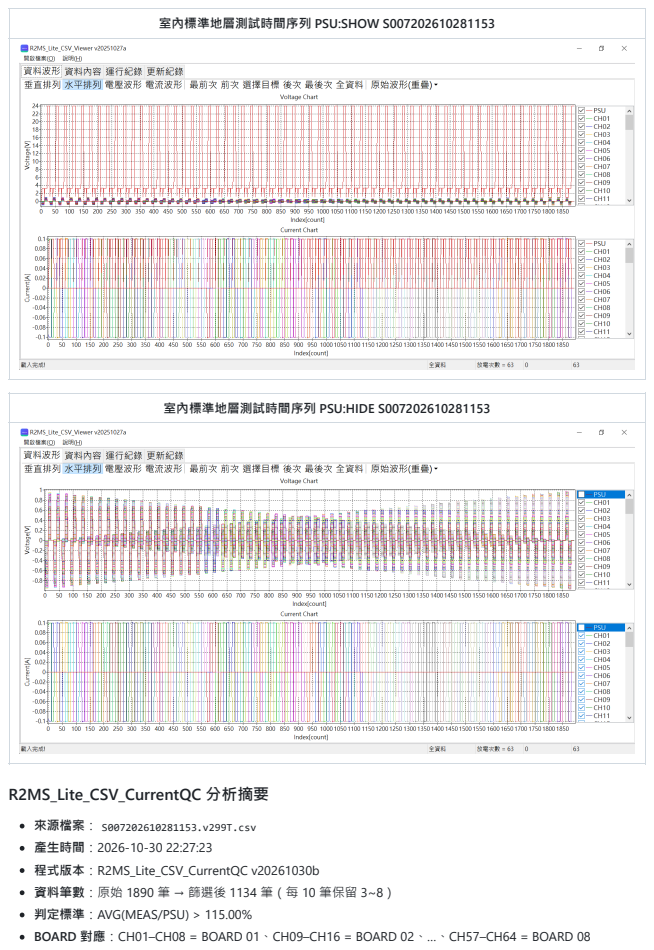
[picture p125: page 2]
R2MS_Lite_CSV_CurrentQC 分析摘要

室內標準地層測試時間序列 PSU:HIDE S007202610281153

來源檔案： S007202610281153.v299T.csv
產生時間：2026-10-30 22:27:23
程式版本：R2MS_Lite_CSV_CurrentQC v20261030b
資料筆數：原始 1890 筆 → 篩選後 1134 筆（每 10 筆保留 3~8）
判定標準：AVG(MEAS/PSU) > 115.00%
BOARD 對應：CH01–CH08 = BOARD 01、CH09–CH16 = BOARD 02、…、CH57–CH64 = BOARD 08

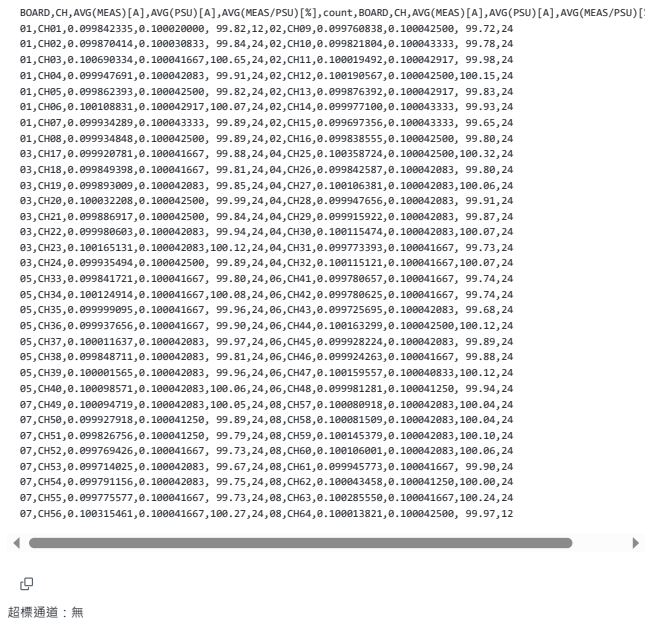
[picture p126: page 3]
超標通道：無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

## 野外測試時間序列 PSU:SHOW S007202610281229

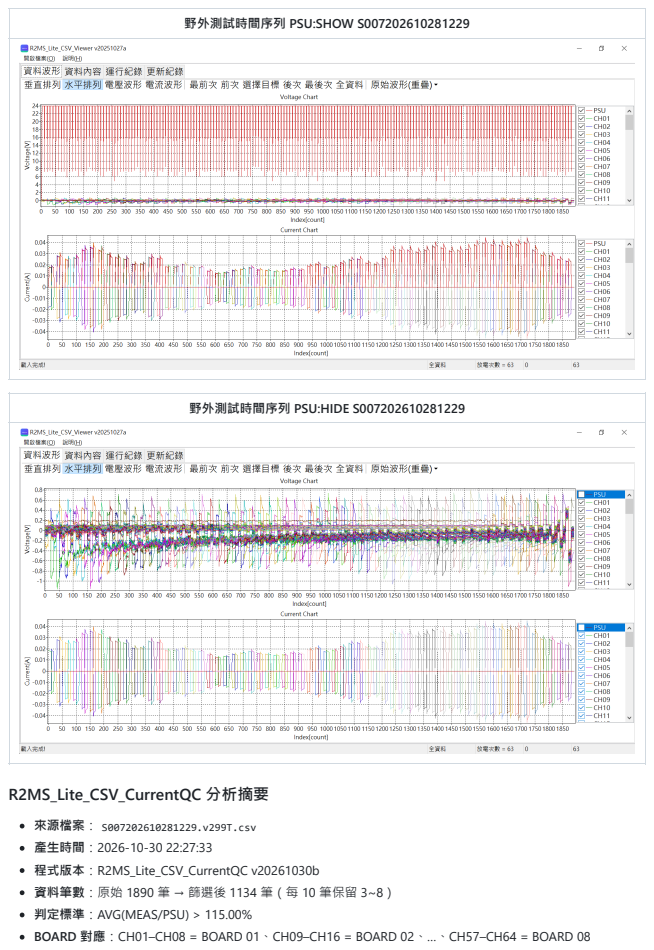
[picture p127: page 4]
R2MS_Lite_CSV_CurrentQC 分析摘要

野外測試時間序列 PSU:HIDE S007202610281229

來源檔案： S007202610281229.v299T.csv
產生時間：2026-10-30 22:27:33
程式版本：R2MS_Lite_CSV_CurrentQC v20261030b
資料筆數：原始 1890 筆 → 篩選後 1134 筆（每 10 筆保留 3~8）
判定標準：AVG(MEAS/PSU) > 115.00%
BOARD 對應：CH01–CH08 = BOARD 01、CH09–CH16 = BOARD 02、…、CH57–CH64 = BOARD 08

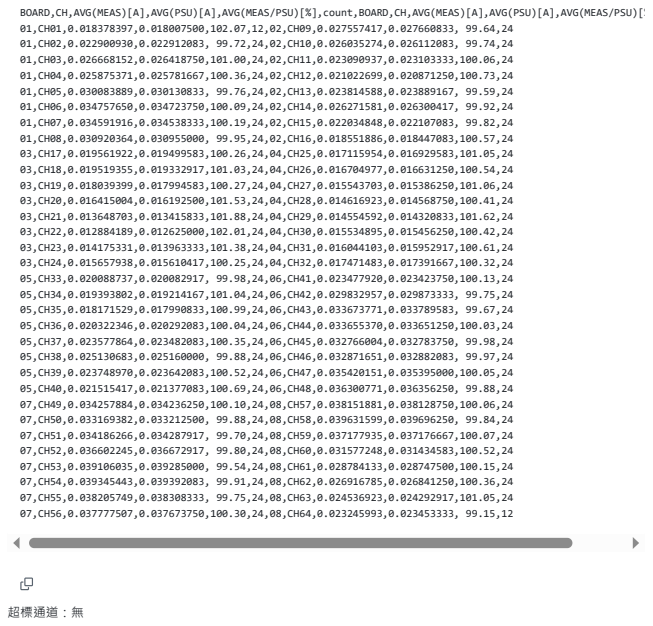
[picture p128: page 5]
超標通道：無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

## NCU草坪時間序列 PSU:SHOW S007202610281236

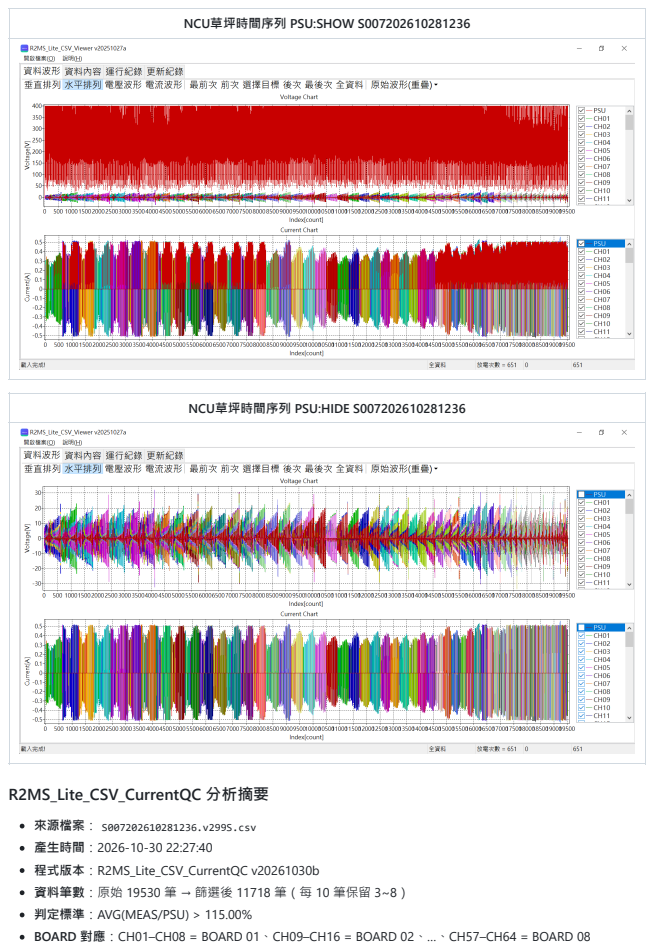
[picture p129: page 6]
R2MS_Lite_CSV_CurrentQC 分析摘要

NCU草坪時間序列 PSU:HIDE S007202610281236

來源檔案： S007202610281236.v299S.csv
產生時間：2026-10-30 22:27:40
程式版本：R2MS_Lite_CSV_CurrentQC v20261030b
資料筆數：原始 19530 筆 → 篩選後 11718 筆（每 10 筆保留 3~8）
判定標準：AVG(MEAS/PSU) > 115.00%
BOARD 對應：CH01–CH08 = BOARD 01、CH09–CH16 = BOARD 02、…、CH57–CH64 = BOARD 08

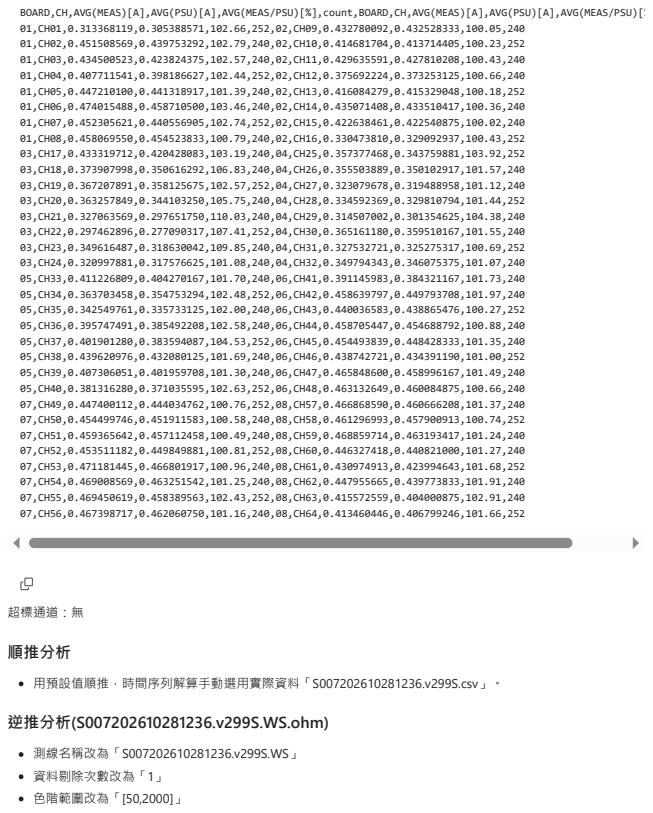
[picture p130: page 7]
超標通道：無; 測線名稱改為「S007202610281236.v299S.WS」 資料剔除次數改為「1」 色階範圍改為「[50,2000]」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

順推分析
用預設值順推，時間序列解算手動選用實際資料「S007202610281236.v299S.csv」。
逆推分析(S007202610281236.v299S.WS.ohm)

## 其他維持預設值。

## S007202610281236.v299S.WS 逆推結果

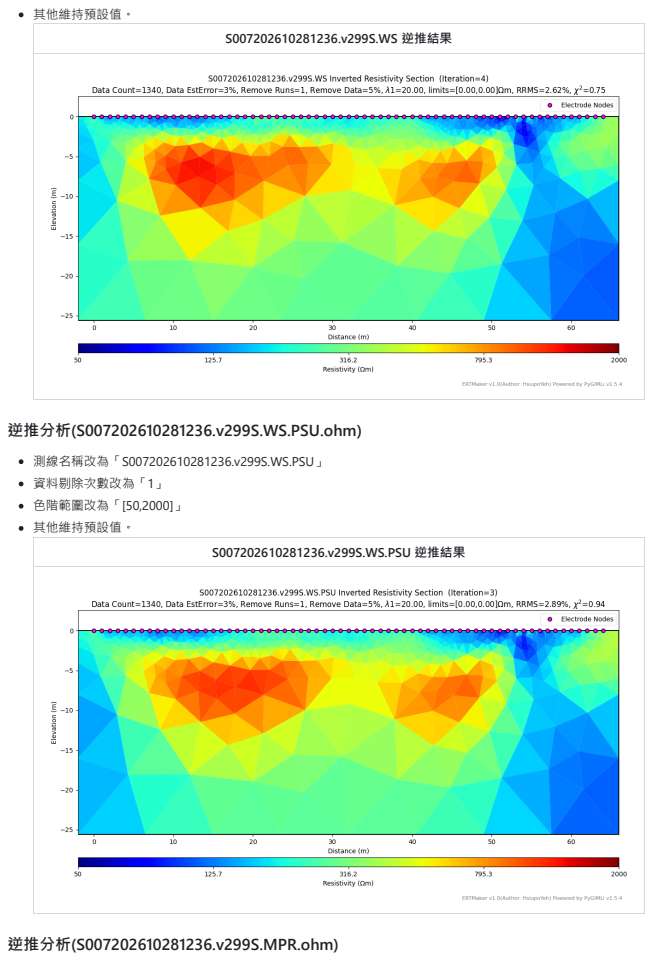
[picture p131: page 8]

逆推分析(S007202610281236.v299S.WS.PSU.ohm)

測線名稱改為「S007202610281236.v299S.WS.PSU」
資料剔除次數改為「1」
色階範圍改為「[50,2000]」
其他維持預設值。

S007202610281236.v299S.WS.PSU 逆推結果

逆推分析(S007202610281236.v299S.MPR.ohm)

## 測線名稱改為「S007202610281236.v299S.MPR」

## 資料剔除次數改為「1」

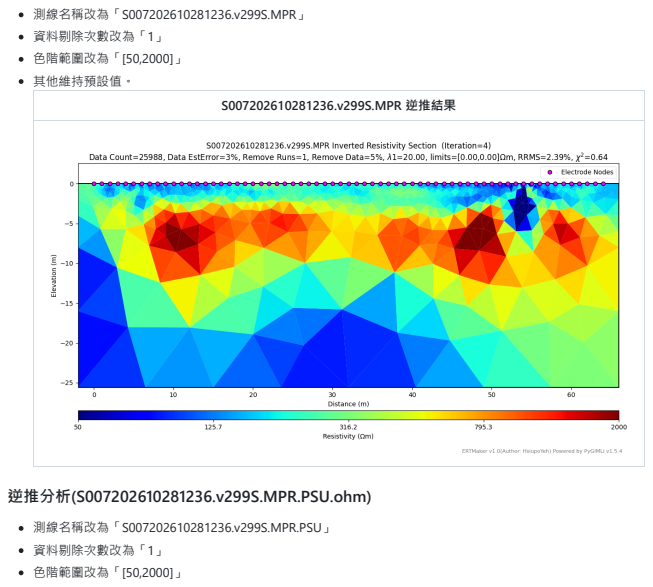
[picture p132: page 9]
色階範圍改為「[50,2000]」 其他維持預設值。; S007202610281236.v299S.MPR 逆推結果

逆推分析(S007202610281236.v299S.MPR.PSU.ohm)

測線名稱改為「S007202610281236.v299S.MPR.PSU」
資料剔除次數改為「1」
色階範圍改為「[50,2000]」

## 其他維持預設值。

## S007202610281236.v299S.MPR.PSU 逆推結果

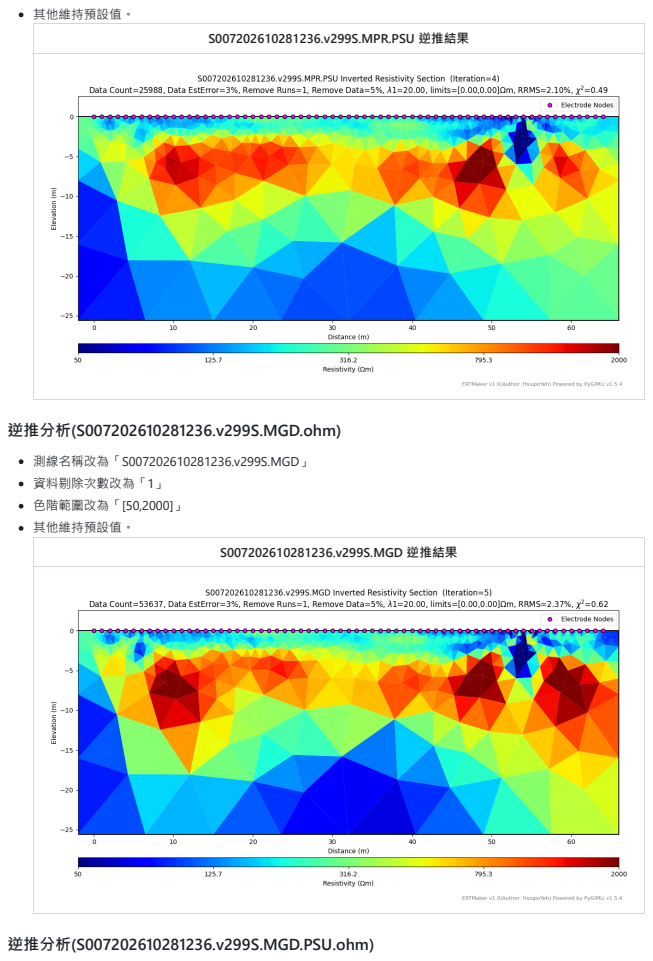
[picture p133: page 10]
測線名稱改為「S007202610281236.v299S.MGD」 資料剔除次數改為「1」 色階範圍改為「[50,2000]」 其他維持預設值。; S007202610281236.v299S.MGD 逆推結果

逆推分析(S007202610281236.v299S.MGD.ohm)

逆推分析(S007202610281236.v299S.MGD.PSU.ohm)

## 測線名稱改為「S007202610281236.v299S.MGD.PSU」

## 資料剔除次數改為「1」

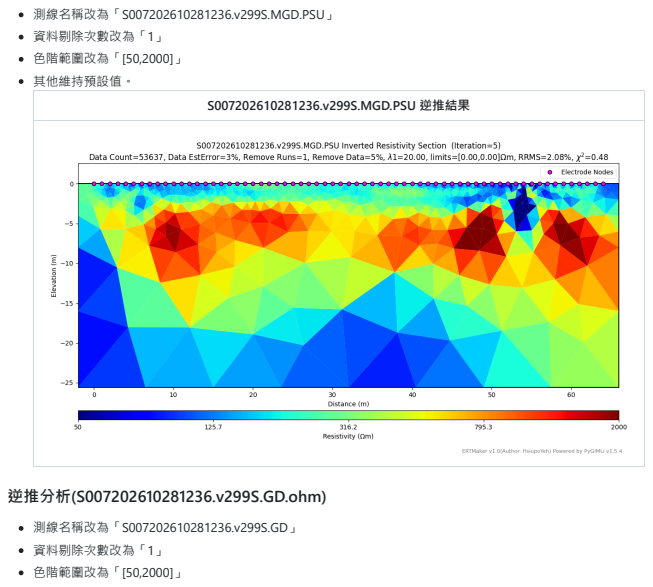
[picture p134: page 11]
色階範圍改為「[50,2000]」 其他維持預設值。; 測線名稱改為「S007202610281236.v299S.GD」 資料剔除次數改為「1」 色階範圍改為「[50,2000]」

S007202610281236.v299S.MGD.PSU 逆推結果

逆推分析(S007202610281236.v299S.GD.ohm)

## 其他維持預設值。

## S007202610281236.v299S.GD 逆推結果

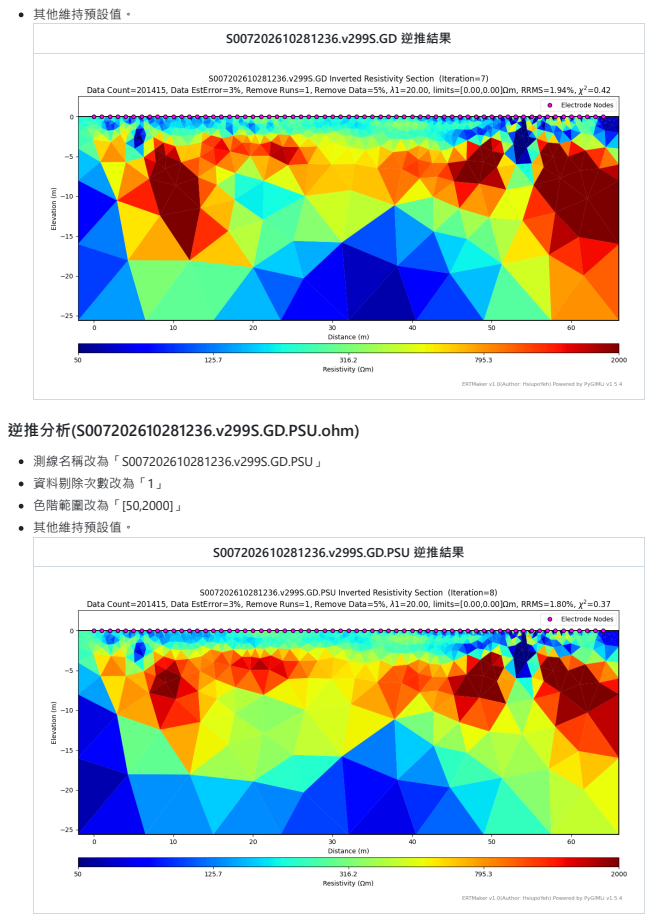
[picture p135: page 12]

逆推分析(S007202610281236.v299S.GD.PSU.ohm)

測線名稱改為「S007202610281236.v299S.GD.PSU」
資料剔除次數改為「1」
色階範圍改為「[50,2000]」
其他維持預設值。

S007202610281236.v299S.GD.PSU 逆推結果
