cgrgncu/SwitchArray_info/production/SwitchArray/SwitchArray-2026-S008/20261028/S00820261028_Report.pdf.pdf

## 室外檢測完成日期: 2026-10-28

## 室內浮接測試時間序列 PSU:SHOW S008202610281325


## 室內浮接測試時間序列 PSU:HIDE S008202610281325

# SwitchArray-2026-S008 維修檢測完成紀錄

# 時間序列檢視

## 室內標準地層測試時間序列 PSU:SHOW S008202610281333

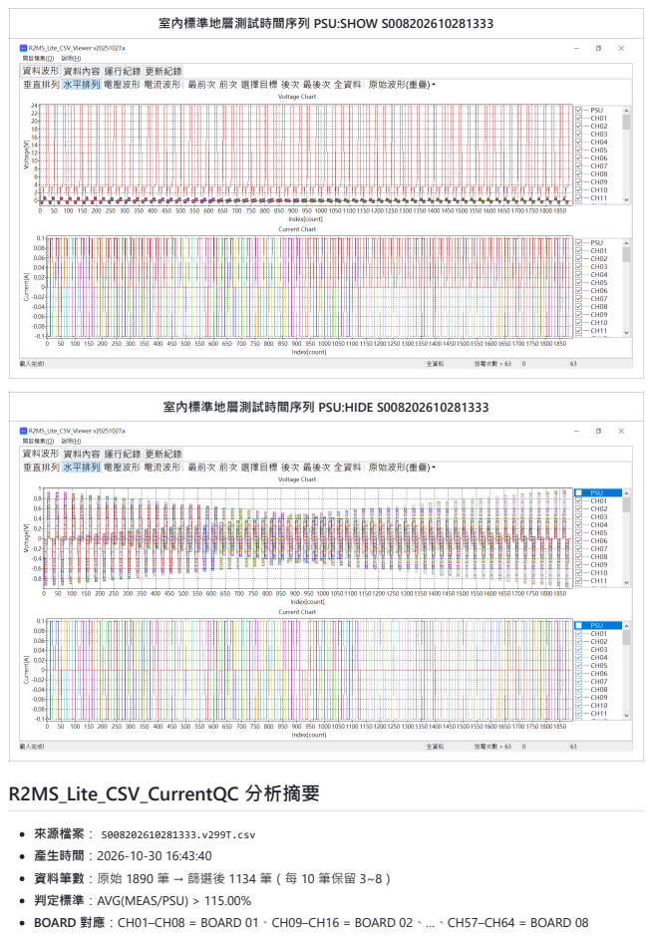
[picture p136: page 2]
R2MS_Lite_CSV_CurrentQC 分析摘要

室內標準地層測試時間序列 PSU:HIDE S008202610281333

來源檔案： S008202610281333.v299T.csv
產生時間：2026-10-30 16:43:40
資料筆數：原始 1890 筆 → 篩選後 1134 筆（每 10 筆保留 3~8）
判定標準：AVG(MEAS/PSU) > 115.00%
BOARD 對應：CH01–CH08 = BOARD 01、CH09–CH16 = BOARD 02、…、CH57–CH64 = BOARD 08

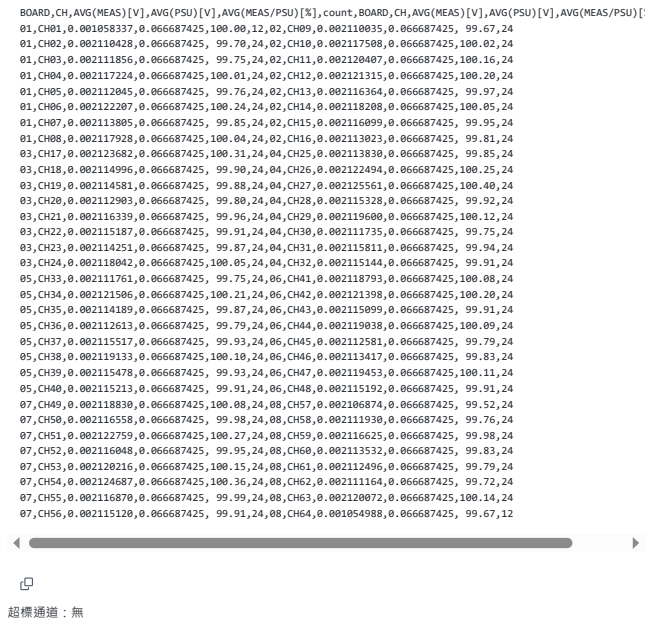
[picture p137: page 3]
超標通道：無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

## 野外測試時間序列 PSU:SHOW S008202610281342

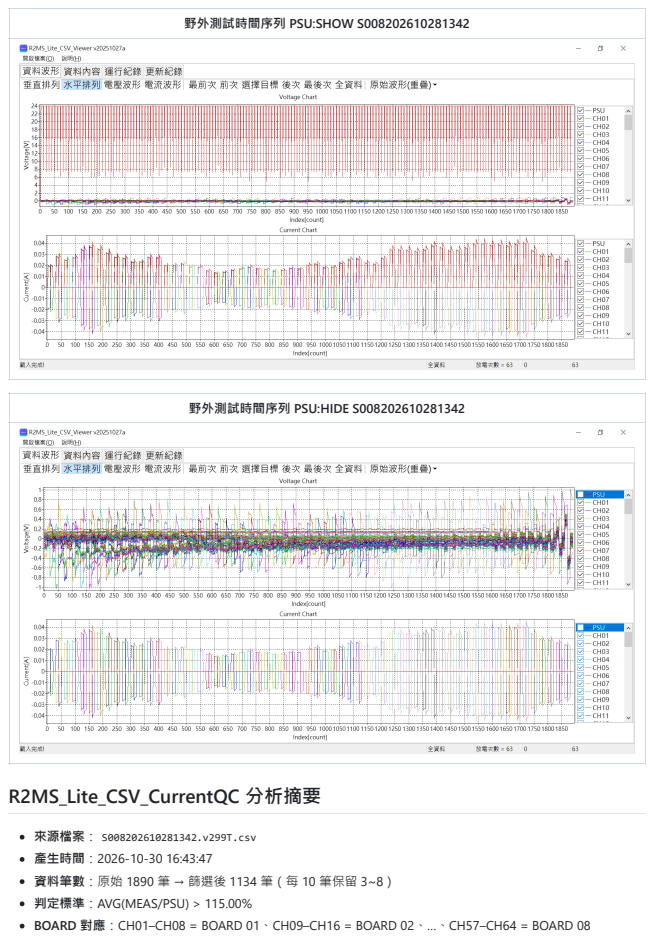
[picture p138: page 4]
R2MS_Lite_CSV_CurrentQC 分析摘要

野外測試時間序列 PSU:HIDE S008202610281342

來源檔案： S008202610281342.v299T.csv
產生時間：2026-10-30 16:43:47
資料筆數：原始 1890 筆 → 篩選後 1134 筆（每 10 筆保留 3~8）
判定標準：AVG(MEAS/PSU) > 115.00%
BOARD 對應：CH01–CH08 = BOARD 01、CH09–CH16 = BOARD 02、…、CH57–CH64 = BOARD 08

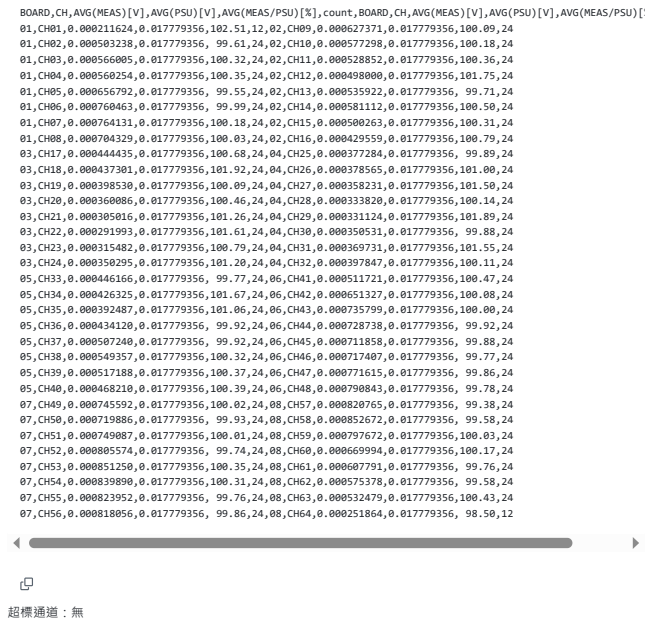
[picture p139: page 5]
超標通道：無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

## NCU草坪時間序列 PSU:SHOW S008202610281349

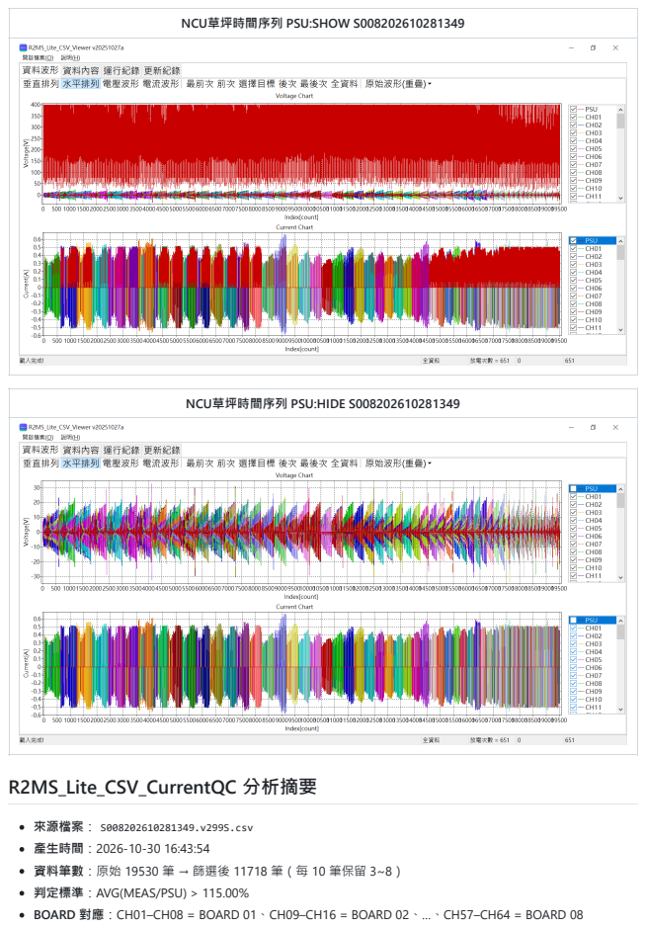
[picture p140: page 6]
R2MS_Lite_CSV_CurrentQC 分析摘要

NCU草坪時間序列 PSU:HIDE S008202610281349

來源檔案： S008202610281349.v299S.csv
產生時間：2026-10-30 16:43:54
資料筆數：原始 19530 筆 → 篩選後 11718 筆（每 10 筆保留 3~8）
判定標準：AVG(MEAS/PSU) > 115.00%
BOARD 對應：CH01–CH08 = BOARD 01、CH09–CH16 = BOARD 02、…、CH57–CH64 = BOARD 08

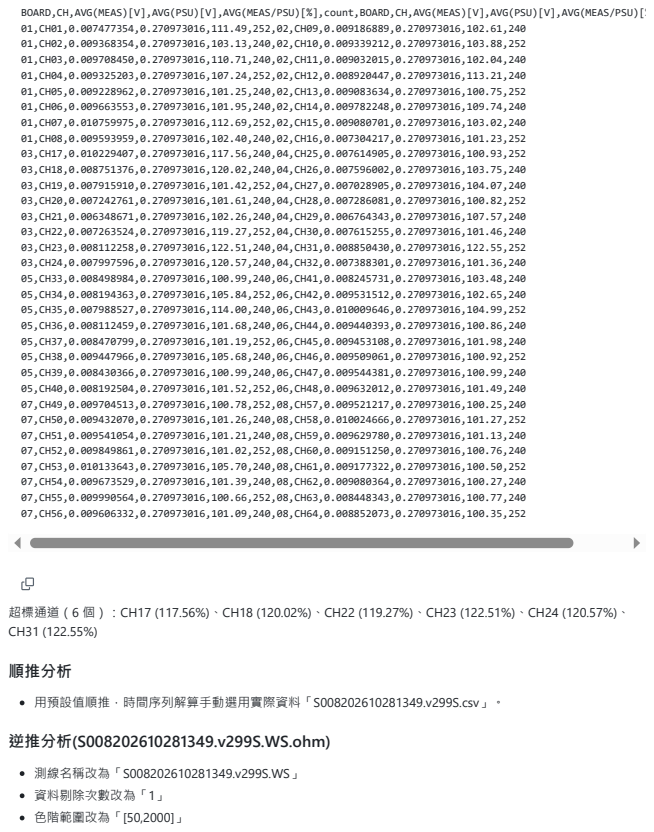
[picture p141: page 7]
超標通道（6 個）：CH17 (117.56%)、CH18 (120.02%)、CH22 (119.27%)、CH23 (122.51%)、CH24 (120.57%)、 CH31 (122.55%); 測線名稱改為「S008202610281349.v299S.WS」 資料剔除次數改為「1」 色階範圍改為「[50,2000]」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

順推分析
用預設值順推，時間序列解算手動選用實際資料「S008202610281349.v299S.csv」。
逆推分析(S008202610281349.v299S.WS.ohm)

## 其他維持預設值。

## S008202610281349.v299S.WS 逆推結果


逆推分析(S008202610281349.v299S.WS.PSU.ohm)

測線名稱改為「S008202610281349.v299S.WS.PSU」
資料剔除次數改為「1」
色階範圍改為「[50,2000]」
其他維持預設值。

S008202610281349.v299S.WS.PSU 逆推結果

逆推分析(S008202610281349.v299S.MPR.ohm)

## 測線名稱改為「S008202610281349.v299S.MPR」

## 資料剔除次數改為「1」

色階範圍改為「[50,2000]」 其他維持預設值。; S008202610281349.v299S.MPR 逆推結果

逆推分析(S008202610281349.v299S.MPR.PSU.ohm)

測線名稱改為「S008202610281349.v299S.MPR.PSU」
資料剔除次數改為「1」
色階範圍改為「[50,2000]」

## 其他維持預設值。

## S008202610281349.v299S.MPR.PSU 逆推結果

測線名稱改為「S008202610281349.v299S.MGD」 資料剔除次數改為「1」 色階範圍改為「[50,2000]」 其他維持預設值。; S008202610281349.v299S.MGD 逆推結果

逆推分析(S008202610281349.v299S.MGD.ohm)

逆推分析(S999202610281236.v299S.MGD.PSU.ohm)

## 測線名稱改為「S008202610281349.v299S.MGD.PSU」

## 資料剔除次數改為「1」

色階範圍改為「[50,2000]」 其他維持預設值。; 測線名稱改為「S008202610281349.v299S.GD」 資料剔除次數改為「1」 色階範圍改為「[50,2000]」

S008202610281349.v299S.MGD.PSU 逆推結果

逆推分析(S008202610281349.v299S.GD.ohm)

## 其他維持預設值。

## S008202610281349.v299S.GD 逆推結果


逆推分析(S008202610281349.v299S.GD.PSU.ohm)

測線名稱改為「S008202610281349.v299S.GD.PSU」
資料剔除次數改為「1」
色階範圍改為「[50,2000]」
其他維持預設值。

S008202610281349.v299S.GD.PSU 逆推結果
