cgrgncu/SwitchArray_info/硬體_電路板/主控制板(ESP32)/線路圖(或Gerber)/Schematic_ERT3_control-board_ver2_2024-04-16.pdf

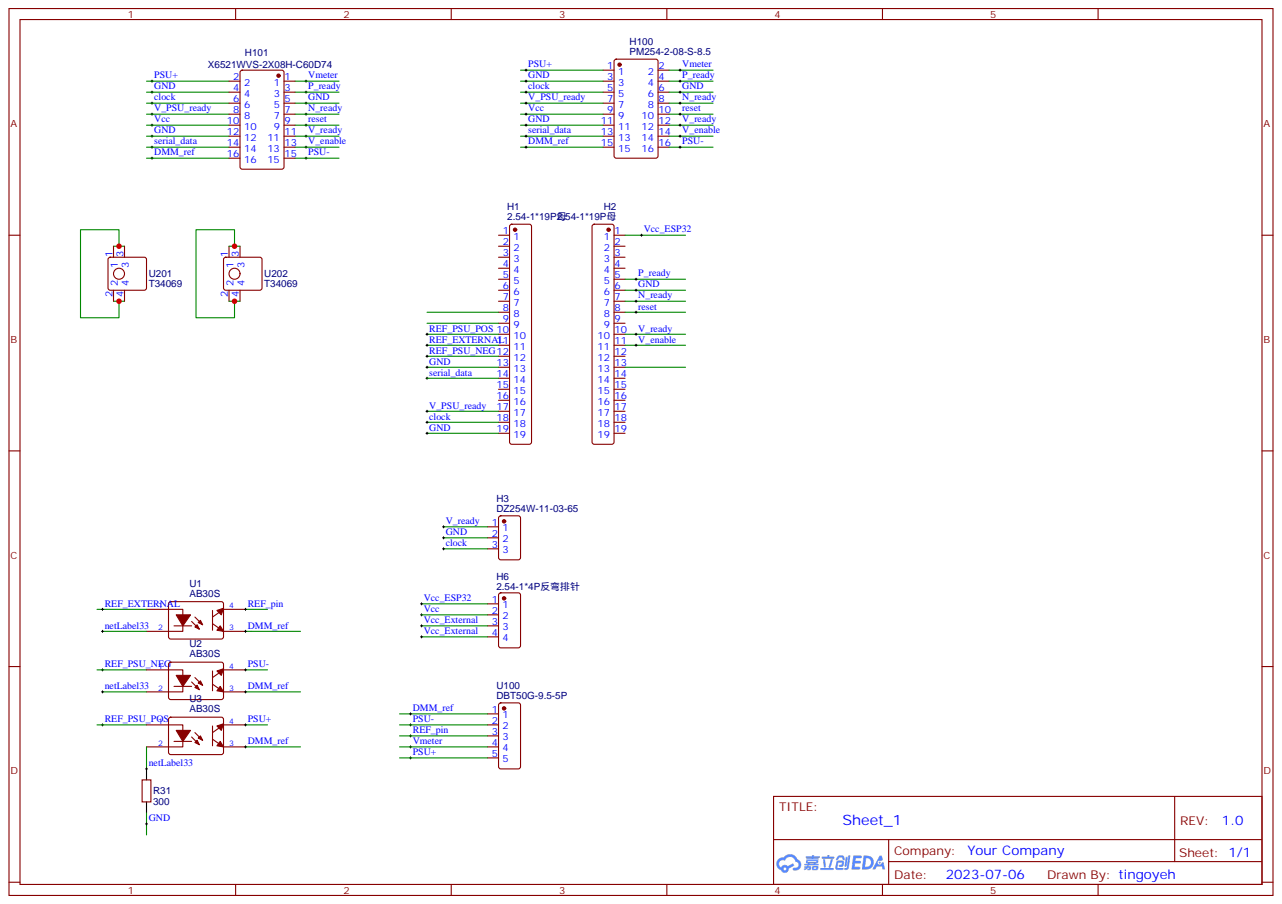
[picture p142: page 1]
