cgrgncu/SwitchArray_info/(commit log)

2024-11-06 Create R2MS_Lite_Manager_開發筆記 .md
2024-11-06 Update R2MS_Lite_Manager_開發筆記 .md
2026-05-05 Add README for SwitchArray-2025-S007 maintenance record
    Added maintenance inspection record for SwitchArray-2025-S007, including testing dates, content, time series views, and analysis.
2026-05-05 Revise 逆推分析 section in README.md
    Updated the analysis section with new parameters and images.
2026-06-11 Update RelayBoard_List with inspection results
    Added inspection results for relay board connections.
2026-08-16 Update R2MS_Lite存檔說明.md with Python example
    Added Python usage example for curl in documentation.
2026-09-21 Update README with 2026-06-30 details
    Added new section for 2026-06-30 with details on SwitchArray usage and assembly date.
2026-10-06 Update current observation range for testing methods
2026-10-06 Update assembly date in README.md
2026-10-15 Revise green power wire preparation steps
    Updated instructions for preparing green power wire and connector assembly.
2026-10-16 Update RelayBoard_List with recent test results
2026-10-22 Update RelayBoard_List.md to reflect abnormal results
2026-11-03 Update README.md for SwitchArray S009 data
2026-11-09 Update installation location for RelayBoard 2025100065
2026-11-13 Update RelayBoard_List.md with new test observations
    Added details about power supply voltage issues and relay behavior for entry 2025100007.
